jjjay0826/rocket-system/doc/README.md

# doc/ 導覽 

## 🆕 第一次接觸這個專案?先讀 **[getting_started.md](getting_started.md)**

**本頁是給「已經懂這個領域」的人用的路由表**,直接就出現開傘判據、
拖曳傘、卡爾曼、遙測封包這些詞。如果這些名詞你還不熟,
先花 20 分鐘讀 [getting_started.md](getting_started.md) —— 那份從
「這塊板子到底是幹嘛的」開始講,只需要會看 C 語言。

---

**懂了之後回到這頁。**下面每一份文件都標了狀態,
🔴 標記的**不要引用它的結論**,那是已經被推翻的舊版,留著只是為了追溯歷史。

---

## 五分鐘認識現況

**2026-08-01 在旭海實際飛過一次(第 161 隊,競賽第三名)。**

- 飛到 **833.7 m**。**ch1 的開傘主路徑在頂點後約 2 秒(1.6~2.1 s)觸發;ch2 主路徑失效,靠 18 秒備援計時器開傘** —— 備援救了它,但主路徑在兩塊板裡失敗了一塊
- 失效在回收系統的機械端:拖曳傘展開時把箭體帶進 **3.2 轉/秒**的自旋,
  主傘在自旋中充氣、傘繩扭轉、載荷集中到少數幾條線上、結構失效,
  以 32 m/s 落海
- **箭體未回收,只尋回鼻錐** → 兩塊板的 SD 卡沉海,**50 Hz 資料永久遺失**

完整版:**[flight_161_summary.md](flight_161_summary.md)** ← 沒時間的話只讀這份

---

## 依你要做的事找檔案

### 「我要準備下一次發射」

| 順序 | 檔案 | 為什麼 |
|---|---|---|
| 1 | **[known_issues.md](known_issues.md)** | **現在還沒修的問題,唯一的現況清單。**🔴 那 7 條是「下次飛之前一定要處理」 |
| 2 | **[launch_day_reference.md](launch_day_reference.md)** | 發射日操作手冊。編譯開關、開機檢查、地面站啟動、全部指令、按鈕、狀態燈 |
| 3 | **[flight_161_summary.md](flight_161_summary.md)** 第七節 | 上次飛完得到的六條改進項,前三條是回收系統 |
| 4 | [open_defects_20260801.md](open_defects_20260801.md) | 上次**發射前**的缺陷清單(快照)。當檢查清單的範本用;現況以 known_issues.md 為準 |
| 5 | [../firmware-rocket/doc/e28_b_board_checklist.md](../firmware-rocket/doc/e28_b_board_checklist.md) | B 板換 2.4 GHz E28 的接線與法規 |

> ⚠ **發射日守則**:`open_defects_20260801.md` 的 A 段是「做不到就別飛」的項目。
> 不要在發射日改開傘路徑 —— 那條寫在 `failure_analysis_20260801.md` 裡,
> 是上一屆的教訓。

### 「我要知道上次為什麼失敗」

| 檔案 | 涵蓋 | 狀態 |
|---|---|---|
| **[flight_161_summary.md](flight_161_summary.md)** | 全部三項失效的總表 ＋ 子系統成績單 ＋ 無解清單 | 🟢 **從這裡開始** |
| **[parachute_failure_20260801.md](parachute_failure_20260801.md)** | 主傘失效的完整因果鏈、證據、判據 | 🟢 開傘議題的權威版 |
| [failure_analysis_20260801.md](failure_analysis_20260801.md) | **§1 GNSS 失效**、**§2 卡爾曼速度失效** | 🟡 這兩節仍有效 |
| ↳ 同檔 §3 主傘 | | 🔴 **已被推翻,勿引用** |

### 「我要分析我自己的飛行資料」

**[../tools/README.md](../tools/README.md)** —— 兩條管線的完整使用說明,指令可以直接複製貼上:

- **管線 A 遙測**:`raw_chN.log` → 解析 → 雙板儀表板 / 對照表 / 速度反解
- **管線 B 影像**:YouTube 直播存檔 → 抽幀 → 追蹤裁切 → 天空扣除
- **管線 C 模擬**:OpenRocket `.ork` → 81 組矩陣 → 韌體開傘邏輯重跑 → 地面站回放

### 「我要改韌體」

| 檔案 | 內容 |
|---|---|
| [../firmware-rocket/doc/interactive_features.md](../firmware-rocket/doc/interactive_features.md) | 互動功能與 LED 指示(PB6/PB7 開關、兩顆 LED 的語意) |
| [../firmware-rocket/doc/rocket_v2_CubeMX_config.md](../firmware-rocket/doc/rocket_v2_CubeMX_config.md) | CubeMX 逐項設定清單(重新產碼時照這份) |
| [../shared/README.md](../shared/README.md) | 兩端共用的東西:封包契約、LoRa 模組設定檔 |
| [failure_analysis_20260801.md](failure_analysis_20260801.md) §2 | 卡爾曼速度為什麼不可信 —— **改開傘判據前必讀** |

### 「我要做地面站」

[../firmware-ground/README.md](../firmware-ground/README.md) ＋ [../shared/protocol.h](../shared/protocol.h)。
沒有真飛行資料時用 `tools/replay309.py` 灌模擬封包進去。

### 「我要準備簡報 / 報告」

[final_presentation_plan.md](final_presentation_plan.md) —— 2026 年那次的簡報規劃。
比賽已經結束(第三名),但**評分表逐項拆解**與**論述框架**對下一屆仍然適用。

---

## 檔案總覽

### doc/

| 檔案 | 狀態 | 內容 |
|---|---|---|
| `getting_started.md` | 🟢 **新手第一站** | 從零開始:這塊板子是什麼、怎麼判斷開傘、板上有什麼、名詞表、第一個小時動手做什麼 |
| `where_is_everything.md` | 🟢 **找檔案看這份** | 兩個 GitHub repo 的 clone 指令、完整檔案地圖、以及「新東西該放哪」 |
| `README.md` | 🟢 | 本頁(路由表) |
| `known_issues.md` | 🟢 **現況清單** | 所有還沒修的問題(🔴7／🟠12／🟡5／❓3)與已修好的教訓,每項附白話說明與修法。**修好一項就更新它** |
| `flight_161_summary.md` | 🟢 **入口** | 2026-08-01 飛行總結。總表／失效鏈／子系統成績單／無解清單／改進項 |
| `parachute_failure_20260801.md` | 🟢 | 主傘失效完整分析。**開傘議題以這份為準** |
| `launch_day_reference.md` | 🟢 | 發射日操作手冊(764 行,最厚的一份) |
| `failure_analysis_20260801.md` | 🟡 部分 | §1 GNSS 🟢／§2 卡爾曼 🟢／**§3 主傘 🔴 已被推翻** |
| `open_defects_20260801.md` | 🟡 快照 | 2026-08-01 發射前的缺陷清單。部分項目已被飛行結果回答;**現況看 `known_issues.md`** |
| `final_presentation_plan.md` | 🟡 歷史 | 2026 決賽簡報規劃。評分表拆解仍可參考 |
| `sim309_81cases.csv` | 🟢 資料 | 81 組 OpenRocket 模擬(3 推力 × 3 仰角 × 9 風況) |
| `sim309_analysis.txt` | 🟢 資料 | 上者的分析輸出 |

### 其他位置的文件

| 檔案 | 內容 |
|---|---|
| [`../README.md`](../README.md) | Monorepo 總覽、為什麼用 monorepo、編譯方式 |
| [`../tools/README.md`](../tools/README.md) | 全部分析工具的使用說明 |
| [`../firmware-ground/README.md`](../firmware-ground/README.md) | 地面接收端 |
| [`../firmware-rocket/doc/`](../firmware-rocket/doc/) | 韌體互動功能、B 板 E28 換裝 |
| [`../hardware/README.md`](../hardware/README.md) | 兩代航電板的電路圖、PCB、網表,以及參考的資料表版本 |
| [`../sim/README.md`](../sim/README.md) | OpenRocket 模型(含舊版)、推力曲線、定 DEPLOY_TB 用的模擬輸出 |
| [`history/README.md`](history/README.md) | 已被取代的設計:開傘邏輯 v1.5、2025-11 FMEA |
| [`flightdata/README.md`](flightdata/README.md) | 每一份原始資料的來源、格式與原始檔名 |

---

## 狀態標示的意思

| | 意思 |
|---|---|
| 🟢 | **現行有效。**可以直接引用 |
| 🟡 | **歷史紀錄或部分過時。**內容仍有價值,但引用前看該檔的頂部說明 |
| 🔴 | **結論已被推翻。**留著只為追溯,**不要引用** |

**寫新文件時請一起維護這一頁。**這次就是因為沒有索引,
repo 裡一度同時存在三份講同一件事而結論相反的文件。

---

## 已知的倉庫問題

### 1. ✅ 已解決:`main.c` 曾在 HEAD 上編譯不過

commit `b0ad361` 有 4 處 C 字串字面值被換行切斷(寫檔時 shell 把 `\r\n`
當成真的換行處理掉了)。**已於 `f6f4c1d` 修復並推送**,現在 clone 下來編得過。

留著這條是因為那個坑會再犯:**用工具寫 C 檔時,`\r\n` 這種跳脫序列很容易
被中間的 shell 層吃掉。**寫完務必檢查引號與括號是否平衡。

### 2. ✅ 已解決:原始飛行資料現在在 repo 裡

`doc/flightdata/` —— clone 下來就有,不必跟任何人要。逐檔說明見
[flightdata/README.md](flightdata/README.md)。

火箭模型同樣已收進 `sim/models/`(先前 `gen_sim_matrix_309.py` 寫死了
某台電腦的絕對路徑,換一台就跑不動)。

### 3. 🟠 協定同步機制沒有 CI,而且住在另一個 repo

`shared/protocol.h` 沒有被任何 `.c` `#include`,但**它是同步的** ——
地面站 repo 有一支 `tests/test_crossrepo_protocol.py`,**直接讀 `main.c`**
把格式字串抓出來逐字比對(2026-08-04 重跑 26/26 通過)。

問題不是「沒同步」,是:

1. **沒有 CI**,要手動跑
2. **它在另一個 repo** —— 只改韌體的人根本不知道有這支測試

**改 `main.c` 的封包格式或指令字串後,一定要跑:**

```bash
cd rocket_system_ground_side && python tests/run_all.py
```

完整說明見 [../shared/README.md](../shared/README.md)。

### 4. ✅ 已解決:Windows 上 clone 會改到資料檔的位元組

Git for Windows 預設 `core.autocrlf=true`,checkout 時會把 LF 換成 CRLF ——
連 PDF、STEP 都會被誤判成文字檔而改壞,`SHA256SUMS` 也永遠對不上。
**repo 裡存的位元組一直是對的,壞的是 Windows 上 checkout 出來的那份。**
2026-10-09 從乾淨 clone 驗證時發現(`sim/motors/*.eng` 從一開始就中招)。

修法是根目錄的 [`../.gitattributes`](../.gitattributes):資料、設計檔、雜湊清單一律不轉換。
**在那之前 clone 的 Windows 使用者,重新 clone 一次。**

---

## 2026-08-04 做過的結構整理

給接手的人一個交代,以免以為東西不見了:

| 動作 | 原因 |
|---|---|
| 刪除 `firmware-rocket/` 與 `firmware-ground/` 的 `Application/User/` | 2026-06-26 CubeIDE UnderRoot 遷移的殘骸。這兩個是**根結構**專案,`Core/Src` 才是真實 source folder,`Application/` **從未被編譯**(產物只有 `Debug/Core/Src/*.o`),`.project`／`.cproject` 也完全沒有引用它 |
| 刪除 `firmware-rocket/Core/Inc/imu.h`、`lora.h` | 0 個 include,對應的 `.c` 早已改名成 `.bak`(而 `.bak` 被 gitignore,所以 repo 裡根本沒有) |
| `firmware-ground` 的 `.ioc` 改名 `rocket sensor` → `rocket ground` | **兩個專案的 `.ioc` 都自稱 rocket sensor。**ground 的 `.cproject` 還有 5 處 `${workspace_loc:/rocket sensor}` —— 同一個 workspace 下建置,輸出可能寫進火箭專案的目錄 |
| `lora_922_*.ini` 搬到 `shared/` | 地面端的設定檔原本住在火箭專案裡 |
| `rocket_v2_CubeMX_config.md` 搬進 `firmware-rocket/doc/` | 與其他兩份韌體文件放一起 |
| `.gitignore` 移除 `*.launch` 規則 | 與它自己上面三行的註解「刻意保留入庫:`*.launch`」自相矛盾。既有的兩個沒事(早就被追蹤),但**新增的會被靜默忽略** |

### ⚠ `sandbox/baro` 刻意沒有比照辦理 —— 它的結構和另外兩個不一樣

整理過程中差點把 `sandbox/baro` 也一起清掉,**那會讓它連結失敗**。原因:

| | `firmware-rocket` / `firmware-ground` | `sandbox/baro` |
|---|---|---|
| 專案根 | 資料夾本身 | **`STM32CubeIDE/` 子資料夾** |
| 結構 | 根結構(2026-06-26 已遷移) | **舊 linked-resource** |
| `Core/Src/*.c` | 真實 source folder | 以 `<link>` 連進 `Application/User/Core/` 這個虛擬名稱 |
| `Application/User/` 裡的 startup／syscalls／sysmem | 沒被引用的重複品 | **實體檔案,而且是建置唯一的來源** |

`sandbox/baro/Core/` 底下雖然也有一份 startup／syscalls,但那在**專案根之外**,
`.project` 沒有連它,所以不在建置裡。**動 baro 的檔案結構之前先看 `STM32CubeIDE/.project`。**

**沒有動的**(已知取捨,不是疏漏):

- `main.c` 2468 行的 monolith。IMU 是唯一沒有獨立驅動的感測器
  (bmp585／gnss／lora_e22／logger／sd 都有),`imu.c` 是最自然的第一刀 ——
  **但那是飛安關鍵路徑,不該在沒有台架驗證的情況下拆。**
- `sdcard.c` 是死碼但不能刪:`logger.c:18` 的 `extern FIL file;` 靠它定義。

---

## 附註

**① 兩塊完全獨立的板,是這個專案做過最值得的決定。**
2026-08-01 那次,**兩次開傘衝擊各只有一塊板錄到** —— 單板就永遠不會知道
發生過兩次衝擊,整條失效鏈也就推不出來。電源、感測器、天線全部獨立。

**② 純量測比濾波後的量可靠一個數量級。**實測:

| 量 | 雙板差 |
|---|---|
| 頂點**純氣壓**高度 | **0.3 m** |
| 頂點**卡爾曼**高度 | 3.5 m |
| 最大上升速度(卡爾曼) | 10.3% |
| `cond_B` 觸發時刻(吃卡爾曼速度) | **4.5 秒** |

開傘判據能用純氣壓就別用濾波後的速度。

**③ 事後才想量的東西,加進封包幾乎不要錢。**
2026-08-01 的關鍵證據(1166 °/s 自旋)是**事後**從封包裡湊出來的;
如果當初直接送 `|w|`,地面在飛行當下就看得到。同理加速規的峰值保持暫存器 ——
2 Hz 取樣抓不到開傘衝擊真峰值,那個暫存器成本近乎為零。
