jjjay0826/rocket-system/doc/flightdata/README.md

# flightdata/ — 原始遙測與 SD 卡記錄

**這是整個專案唯一無法重製的東西。**其他所有分析產出（CSV、圖表、影像幀）
都可以從這些檔案 ＋ `tools/` 重跑出來，但這些檔案本身沒有備份來源。

兩種來源，**都沒有經過任何處理**：

- `raw_ch*.log` —— 地面站收到什麼就存什麼
- `IMU_*.CSV`、`LOG_*.TXT` —— 板上 SD 卡寫的原檔（只有檔名在收進來時改過，對照表在各段）

| 資料夾 | 日期 | 是什麼 |
|---|---|---|
| [`20260801/`](#20260801--2026-08-01-旭海實飛第-161-隊) | 2026-08-01 | ★ 旭海實飛 |
| [`20260731_eve_of_launch/`](#20260731_eve_of_launch--發射前一晚的-ch1-測試) | 07-31 夜 | 發射前一晚 ch1 地面測試 |
| [`20260722_ground_test/`](#20260722_ground_test--2026-07-22-ch2-的地面測試) | 07-22 | ch2 地面測試（含 SD 失敗樣本） |
| [`20260720_ground_test/`](#20260720_ground_test--2026-07-的三次測試) | 07-20～21 | 三次地面／飛行測試 |
| [`20260717_test/`](#20260717_test--2026-07-17-的-500-hz-記錄) | 07-17 | 500 Hz SD 記錄 |
| [`20260605_drop_tests/`](#20260605_drop_tests--2026-06-投放測試的-sd-卡記錄) | 06-05～06 | 投放測試 SD 記錄 |

---

## 20260801/ — 2026-08-01 旭海實飛（第 161 隊）

| 檔案 | 大小 | 行數 | 是什麼 |
|---|---|---|---|
| **`raw_ch1_20260801_152419_5e03e520_utc.log`** | 15 KB | 85 | **★ ch1，帶 UTC 時戳，只含飛行窗口** |
| **`raw_ch2_20260801_152419_5e03e520_utc.log`** | 18 KB | 91 | **★ ch2，同上** |
| `raw_ch1_20260801_152419_5e03e520.log` | 1.75 MB | 10136 | ch1 完整連線記錄（含發射前 93 分鐘待機） |
| `raw_ch2_20260801_152419_c212c94f.log` | 1.94 MB | 11257 | ch2 完整連線記錄 |

### ★ 為什麼 `_utc` 那兩個最重要

`T` 欄位是各板**自己開機後的毫秒數**，兩塊板開機時間不同，所以兩份 log 的 `T`
**不能直接比對**。`parse_raw_lora.py` 再各自以「第一個 `ST:1` 封包」當 t=0，
兩板的 t=0 差 0.49 秒 —— **那是 ch1 離架時掉了兩包（SQ14170、14171）加上 2 Hz 量化，
不是兩板判定離架的時間差**（2026-10-15 更正，舊文寫成「ch1 較晚判定」）。

`_utc` 版本在每行前面多了地面站收到封包時的 UTC 時戳，**這是唯一能把兩塊板放到
同一條時間軸上的東西**：

```
16:57:25.560 T7087226 SQ14166 AX-0.983 AY+0.011 AZ-0.011 ...
└─ 地面站 UTC ─┘ └────────── 火箭送出的原始封包 ──────────┘
```

2026-08-01 的整個失效分析都建立在這上面 —— 「**兩次**開傘衝擊，各只有一塊板錄到」
這個關鍵發現，沒有共同時間軸就推不出來。每包的「UTC − T」相對中位數只散佈 ±10 ms，
所以換算後兩板的取樣點穩定相差 30 ms，這是對齊正確的驗證。

⚠ ch2 的 `_utc` 版**沒有收錄 MSG 行**；ch1 的 `_utc` 版裡 MSG 行的時戳是沿用前一包的，
不是獨立的收包時間。開傘訊息在哪兩包之間，要看完整版 log 的前後順序。
[`tools/verify_timeline_0801.py`](../../tools/verify_timeline_0801.py) 就是這樣讀的，
並把失效分析時間軸的每一列從這裡重算一次。

### 完整版有什麼額外的東西

- 發射前 93 分鐘的待機封包 —— 可以看電池電壓漂移、GPS 收斂過程
- ch1 的**空中斷電重開機**（`RST=POWER-ON`）與重開後的 41 個封包
- `raw_ch1_...5e03e520.log` 含約 5000 個損壞位元組（占 0.29%）。
  **那不是檔案壞掉，是無線電位元錯誤** —— 它本身就是鏈路品質的真實記錄，不要「修」它。

---

## 20260720_ground_test/ — 2026-07 的三次測試

| 檔案 | 大小 |
|---|---|
| `raw_ch1_20260720_115824_8153b14f.log` | 124 KB |
| `raw_ch1_20260720_122930_7f8a913d.log` | 252 KB |
| `raw_ch1_20260721_122019_509bd551.log` | 52 KB |

發射前的地面／飛行測試。硬體與韌體都與 8/1 那次不同，
**不要拿來和實飛資料混著分析**。

---

## 20260722_ground_test/ — 2026-07-22 ch2 的地面測試

| 檔案 | 大小 | 行數 |
|---|---|---|
| `raw_ch2_20260722_173021_41f29e2c.log` | 31 KB | 171 |
| `raw_ch2_20260722_175316_f0a1dfec.log` | 3 KB | 19 |
| `raw_ch2_20260722_210613_4fdd140b.log` | 845 KB | 3967 |

地面站 `data/` 資料夾留下的 ch2 原始記錄（當天在做雙板地面站）。
**開頭就是 SD 初始化失敗**（`SD: FAIL ... fres=3`、`REINIT FAIL`、`GIVE-UP`）——
是 [known_issues.md](../known_issues.md) #8「SD 卡 reset 後鎖死」的實際樣本。

## 20260731_eve_of_launch/ — 發射前一晚的 ch1 測試

| 檔案 | 大小 | 行數 |
|---|---|---|
| `raw_ch1_20260731_235856_5baa84ec.log` | 98 KB | 855 |
| `raw_ch1_20260801_011332_ffaff45a.log` | 170 KB | 1445 |
| `raw_ch1_20260801_023341_5096a02d.log` | 1 KB | — |

2026-07-31 23:58 ～ 08-01 02:33，實飛前一晚 ch1 的地面測試，同樣來自地面站 `data/`。
最後一個檔只有 978 位元組、**全是亂碼**（鮑率不對或模組雜訊），照原樣保留。

## 20260605_drop_tests/ — 2026-06 投放測試的 SD 卡記錄

| 檔案 | 原始檔名 | 大小 | 長度 |
|---|---|---|---|
| `IMU_20260605_1723.CSV` | `IMU.CSV` | 2.5 MB | 81.8 s |
| `IMU_20260605_1738.CSV` | `IMU(1).CSV` | 270 KB | 8.2 s |
| `IMU_20260605_1743.CSV` | `IMU(2).CSV` | 333 KB | 11.5 s |
| `IMU_20260606_1653.CSV` | `IMU(3).CSV` | 1.8 MB | 58.5 s |
| `LOG_20260605_1727.TXT` | `LOG(1).TXT` | 49 KB | 539 行 |
| `LOG_20260605_2043.TXT` | `LOG(2).TXT` | 9 KB | 60 行 |

- 投放測試板（`sandbox/parachute` 的前身）寫在 SD 卡上的記錄。
  `IMU_*.CSV` 是 **500 Hz**（`ts_us` 每筆 2000 µs），欄位
  `ts_us,gx_dps,gy_dps,gz_dps,ax_g,ay_g,az_g,baro_m,vz_ms,imu_hz_m`；
  `LOG_*.TXT` 是 2 Hz 的氣壓文字記錄（`T= P= H= RelH=`）。
- **檔名是收進來時重新命名的**：原檔名都叫 `IMU.CSV`／`LOG.TXT`，
  下載時被加上 `(1)(2)`。新檔名用的是檔案時間（取出 SD 卡或下載的時間，
  測試本身在當天或更早），對照見上表。
- ⚠ **每個檔對應哪一次投放、投放高度多少，沒有留下紀錄。**

## 20260717_test/ — 2026-07-17 的 500 Hz 記錄

| 檔案 | 大小 | 長度 |
|---|---|---|
| `IMU_002.CSV` | 3.0 MB | 87.6 s |

`sandbox/parachute` 格式（多了 `g_tot,kf_vz_ms,kf_h_m` 三欄）。測試內容沒有留下紀錄。

### 每個資料夾都有 `SHA256SUMS`

收進來時算的雜湊值。要確認檔案沒被改過：

```bash
cd doc/flightdata/20260605_drop_tests && sha256sum -c SHA256SUMS
```

---

## 怎麼用

```bash
python tools/parse_raw_lora.py doc/flightdata/20260801/raw_ch1_20260801_152419_5e03e520_utc.log --out-dir out
python tools/parse_raw_lora.py doc/flightdata/20260801/raw_ch2_20260801_152419_5e03e520_utc.log --out-dir out
python tools/flight_report.py out/raw_ch1_*_parsed.csv out/raw_ch2_*_parsed.csv --out report.png
```

**第一個參數放先失聯的板（ch1）**，第二個放涵蓋全程的（ch2）。
完整說明見 [`../../tools/README.md`](../../tools/README.md)。

封包欄位的意思見 [`../getting_started.md`](../getting_started.md) 第六節。

---

## 沒有進來的東西

| | 為什麼 |
|---|---|
| **SD 卡的 50 Hz 記錄** | 🔴 **永久遺失。**箭體未回收，兩塊板隨之沉海 |
| 直播影像幀（668 MB） | 可再生：`tools/grab_yt_frames.py`，來源 `youtube.com/watch?v=ogR7rgce_ps` 的 **5:54:53 起 47 秒** |
| 解析後的 CSV、事件檔、儀表板 | 可再生：用上面的指令 |
