jjjay0826/rocket-system/doc/open_defects_20260801.md

# 發射日缺陷清單 — 2026-08-01

> ## 🟡 這是 2026-08-01 **發射前**的快照
>
> **火箭已經飛了**，所以下面有些項目已經被飛行結果回答，有些則被證明無關。
> 下一屆的用法是：**當作檢查清單的範本**逐條確認現況，不要當成現在的狀態。
>
> 飛行結果 → [flight_161_summary.md](flight_161_summary.md)
>
> **現在還沒修的有哪些 → [known_issues.md](known_issues.md)**（現況清單，與本檔衝突時以它為準）
>
> 已知被飛行結果直接影響的項目：
>
> | 原項目 | 飛行後 |
> |---|---|
> | 回收系統相關（B 段） | 🔴 **主傘確實失效了**。因果鏈見 [parachute_failure_20260801.md](parachute_failure_20260801.md)。減震繩／傘繩強度那幾條要按新結論重寫 |
> | D 段「只有現場能回答」 | 大部分已有答案，但**箭體未回收**，實體相關的永遠不會有答案 |
> | SD 卡相關 | 🔴 **卡隨箭體沉海**。SD 問題仍未解，但這次沒有資料損失以外的後果 |
>
> 文件導覽 → [README.md](README.md)

> 發射 13:00。本表依「還來不來得及」排序，不是依嚴重性。
> 每一項都註明是【已確認】還是【未知】—— 未知的那些只有現場能回答。

---

## 🔴 A. 會擋住發射

| # | 缺陷 | 狀態 | 需時 |
|---|---|---|---|
| ~~**A1**~~ | ~~`REMOTE_CMD_UNRESTRICTED` 仍開啟~~ → **2026-08-01 已關閉**<br>連同另外兩個一起：`PYRO_ADC_FITTED`（分壓實際沒焊）、<br>`LORA_MODE_PINS`（M0/M1 實際還接地，`/setch` 會讓 GPIO 短路到地 82mA）<br>🔴 **仍需重新編譯燒錄兩塊板，並確認 `#warning` 消失** | 已改，未燒錄 | 燒錄 + 驗證 |
| **A2** | **關掉之後的閘門從未在硬體上測過**<br>`/arm` → `/dpl` 的接受／拒收路徑只驗過編譯與結構斷言<br>★2026-08-01：IDLE+ARM 已改成裸脈衝，**ARM 窗口內可重複測**，<br>　不必每發都斷電重開 | 未測 | 20 分 |
| **A3** | **開傘改雙路 PA0+PA1 從未實測**<br>並聯到同一顆電火頭，**任一路單獨拉高就會點著**。<br>要用電表確認開傘時**兩支腳都有 7V** | 未測 | 15 分 |
| **A4** | **E28 在吐 RSSI 位元組**<br>會混進遙測流 → 解析器整幀丟棄。實測 21 個位元組全部落在<br>−71 ~ −111 dBm，是環境噪聲的 RSSI 值 | 已確認 | 20 分 |
| **A5** | **ch2 (com14) 完全連不上**（重試 331 次）<br>雙板熱備援目前只剩一塊板。可能是 A4 的下游症狀 | 已確認 | ? |

**A1～A3 沒做完不該上箭。**

---

## 🟠 B. 已知缺陷，發射前該查

### 回收系統

| # | 缺陷 | 數字 |
|---|---|---|
| **B1** | **CO2 彈射只噴 50 cm** | HPR 通則要 3～5 m。**95% 的能量沒到鼻錐上**。<br>驗法：秤 CO2 瓶刺破前後重量（五分鐘） |
| **B2** | **開傘衝擊 22～53 g** | 靜風 557 kgf／最壞 **1336 kgf**（×1.2～1.8 開傘衝擊係數後更高）。<br>傘繩與連接件額定值**未知** |
| **B3** | **減震繩是否有彈性** | 有彈性 18 kgf vs 沒彈性 272 kgf — **差 15 倍**。<br>最便宜的一項改善 |
| **B4** | **浮力段 88 cm 不夠** | 17.5 kgf vs 需要 25.2 kg → 短少 7.7 kgf。<br>要 2～3 條泳池浮條 ＋ 引擎室隔板封死 |

### 韌體（2026-08-01 新增）

| # | 缺陷 | 影響 |
|---|---|---|
| **B8** | **`rel_alt` 完全沒有突波抑制**<br>`peak_rel_alt` 直接吃 `if (rel_alt > peak) peak = rel_alt`，<br>實測 KH 會有單包 >10m 的突波 | ① cond_A 提早觸發（無害，速度較低反而好）<br>② 上升段大突波會提前武裝 cond_A（**靠 AND 閘擋住**）<br>🔴 ③ 觸發 KF 大偏差重置 → `kf2_v = vz_baro_lp`（被污染成正值）<br>　　→ **cond_B 的 1.5 秒計時重來**<br>🔴 ④ 突波間隔 < 1.5s → cond_B 永不成立 → **只剩 C 計時器**<br>單次突波：C 備援接得住（已驗證）。**賽後修，不要在發射日動開傘路徑** |

### 硬體

| # | 缺陷 | 狀態 |
|---|---|---|
| **B5** | **酸性助焊劑**（凡士林＋氯化鋅＋鹽酸） | 航電板是否用它焊的**未確認**。<br>「室內好、室外壞」與離子污染的濕度依存完全吻合 |
| **B6** | **LDO 板通電 7 秒短路** | 未解決。下游只剩排針與單芯線 |
| **B7** | **E28 發射功率 12 dBm**（模組是 27 dBm 的料） | 白白少 15 dB。2.4 GHz 的傳播本來就吃緊 |

---

## ⚪ C. 已知但這次接受

| # | 缺陷 | 為什麼接受 |
|---|---|---|
| **C1** | SD reset 鎖卡救不回來 | 已實測四修無效。飛行資料以 LoRa 為主，SD 當備份 |
| **C2** | 沒有看門狗（IWDG／WWDG 都關） | 四個故障處理器已改成重開機，但「當機以外的卡死」無保護 |
| **C3** | SD 寫入最長阻塞 ~1.1 s | 原本 2 s，已降。跑在開傘狀態機同一迴圈 |
| **C4** | LoRa RX ring 266 ms < SD 恢復 1.1 s | SD 卡住時上行指令可能整段掉 |
| **C5** | `cmd.c` 單槽 pending 覆寫 | 連續兩道指令會蓋掉前一道 |
| **C6** | `settings.json` 機器專屬卻入庫 | 合併會互相覆蓋 |

---

## ❓ D. 未知 — 只有現場能回答

這些直接決定上面的結論：

- [ ] **實測秤重的回收質量**（25.2 kg 是推算）→ 決定浮條 2 條還是 3 條
- [ ] **傘繩／連接件的額定拉力** → 決定 B2 是不是致命
- [ ] **減震繩是彈性的嗎** → 15 倍差距
- [ ] **CO2 瓶規格與秤重結果** → 決定 B1 的原因
- [ ] **傘艙實際長度**（49 cm 是從設計圖讀的）
- [ ] **剪切銷幾支？還是只靠摩擦？**
- [ ] **洩壓孔孔徑與數量**
- [ ] **航電板用哪一罐助焊劑焊的**
- [ ] **E22 (ch1) 的參數** — 有沒有同樣的 RSSI 問題
- [x] ~~分壓電路焊了沒~~ → **沒焊**（2026-08-01 現場確認，`PYRO_ADC_FITTED` 已關）
- [x] ~~M0/M1 改線了沒~~ → **沒改，還接在 GND**（`LORA_MODE_PINS` 已關）
- [x] ~~AUX 接 PB9 了沒~~ → **接了**（`LORA_USE_AUX` 維持開啟）
- [ ] **落區是海是陸**

---

## 🔍 E. 從未審查過的程式碼

```
韌體
  firmware-rocket/FATFS/Target/user_diskio.c
  firmware-rocket/FATFS/Target/ffconf.h
  firmware-rocket/Core/Src/tim.c              104 行
  firmware-rocket/Core/Src/syscalls.c         176 行   newlib 樁，低風險
  firmware-rocket/Core/Src/sysmem.c            79 行   同上
  USB_DEVICE/Target/usbd_conf.c               671 行
  Core/Src/system_stm32f4xx.c                 747 行   CubeMX 生成

地面站
  src/gui/visualizers/attitude_displayer.py
  src/gui/visualizers/visualization_tools.py
  src/gui/flow_layout.py
  src/core/models.py 的邊界情況（格式已由 crossrepo 覆蓋）
```

風險評估：`syscalls.c`／`sysmem.c` 是 newlib 樁，幾乎不可能有事。
`user_diskio.c`／`ffconf.h` 在 SD 那條路，而 SD 已降級成非必要。`tim.c` 值得看一眼。

---

## 📌 F. 今天新發現、且推翻先前結論的

| # | 事情 |
|---|---|
| **F1** | **C 備援在 7/81 組會先觸發**。`tools/analyse_309.py` 的彈道解析式說 0/81，<br>但 `tools/fw_logic.py` 真跑韌體邏輯是 **7/81**。<br>A∧B 實際要頂點後 **1.95 s**，不是解析式的 1.55 s ——<br>氣壓計要穿過自己的雜訊才確認跌破 10 m，卡爾曼也要時間把負速度建起來。<br>**不是失效**（C 在頂點後 1.67 s 觸發，火箭正在下降），<br>但「開傘靠 A∧B」要改成「高推力端靠 C」 |
| **F2** | **`fw_logic` 不含氣壓膜時間常數** → 真板的 A 會更慢，走 C 的組數只會更多 |
| **F3** | **`groundhitvelocity` 是合速度**，含水平漂移。<br>先前用它反推質量得到 26.3 kg 是高估的；<br>用無風組的純垂直降速 6.449 m/s 反推是 **25.2 kg** |

---

## 建議的當日順序

```
第 1 小時   A4  關掉 E28 的 RSSI 輸出 → 看 ch2 通不通（A5 可能一起解決）
            B1  秤 CO2 瓶刺破前後重量

第 2 小時   A1  關掉 UNRESTRICTED、重新編譯（確認 #warning 消失）
                燒錄兩塊板

第 3 小時   A2  測 /arm → /dpl 閘門
            A3  電表確認開傘時 PA0+PA1 兩支腳都有 7V

第 4 小時   B3  檢查減震繩彈性
            B4  買浮條、用擠的泡棉封引擎室隔板

隨時       B5  目視檢查 SPI2 焊點有無腐蝕（★不要洗，來不及乾）
```

**如果只能做三件事：A1、A3、B3。**
前兩件決定傘會不會開，第三件決定傘開了之後繩子會不會斷。
