jjjay0826/rocket-system/doc/launch_day_reference.md

# 發射日操作手冊

> 建立 2026-07-27。所有數值皆從程式碼核對而來,非憑記憶。
> 韌體 `rocket-system@main`、地面站 `rocket_system_ground_side@main`。
> 飛行模擬來源:**OpenRocket `3.0.9`**,81 組矩陣(3 推力 ×3 仰角 ×9 風況)。
>
> ⚠ **2026-08-01 更新**:本文以下的數字多數仍是 3.0.8 的。3.0.9 每一項都更好
> (最小備援餘裕 1.29→**1.69 s**、C 先觸發 6/81→**0/81**、最偏西 −48→**+19 m**、
> 臨界東風 4.0→**4.6 m/s**),所以舊數字是**保守側**,照舊值操作不會出錯。
> 完整 81 組見 `doc/sim309_analysis.txt` 與 `doc/sim309_81cases.csv`。
>
> 🔴 但有一項**結論改變**:`tools/fw_logic.py`(真跑韌體的 (A∧B)∨C,不是彈道
> 解析式)顯示 **7/81 組會由 C 先觸發**,而不是 0/81。A∧B 實際要頂點後 1.95 s。
> 不是失效 —— C 在頂點後 1.67 s 觸發,火箭正在下降。詳見
> `doc/open_defects_20260801.md` 的 F1。
> 最後更新 2026-07-31。

---

## 🔴 第一部分:出門前必做(做不到就別飛)

### 1. 三個編譯開關的狀態

| 開關 | 位置 | 現在 | 飛行前必須 |
|---|---|---|---|
| `REMOTE_CMD_UNRESTRICTED` | `main.c:774` | ✅ **已關** | 保持關閉 |
| `PYRO_ADC_FITTED` | `main.c:181` | ✅ **已關** | 保持關閉(分壓**沒有**焊) |
| `LORA_MODE_PINS` | `lora_e22.c:49` | ✅ **已關** | 保持關閉(M0/M1 **還接在 GND**) |
| `LORA_USE_AUX` | `lora_e22.c:71` | ✅ 開 | 維持(AUX→PB9 已接,現場確認) |

**⚠ 2026-08-01 更正:本表在此之前有兩行是錯的。**
舊版寫 `PYRO_ADC_FITTED` 與 `LORA_MODE_PINS`「✅ 開,維持」,理由是
「2026-07-27 分壓已焊/M0M1 已改線」—— **兩項硬體改動實際上都沒有做**。
照舊表操作會在發射台上做出錯誤決定,所以三個開關已全部關閉。

**關閉的理由**

- **`REMOTE_CMD_UNRESTRICTED`**:開著時遠端開傘沒有任何閘門 —— 不需要 ARM、
  不管飛行狀態、可無限重複點火。那是桌測用的。
  關閉後恢復三道閘門:IDLE 需先 ARM、離架後 10 秒內拒收、已開傘/已落地拒收。
  **編譯時不再噴 `#warning ... NOT FLIGHT SAFE`,那行消失才算真的關掉。**

- **`PYRO_ADC_FITTED`**:分壓沒焊,PB0/PB1 讀到的是浮接雜訊(0.0~0.5V)。
  而 5.0V 以下就判定「保險絲熔斷」→ **等於永久謊報一個最該告警的故障**。
  關掉之後 `v_fuse`/`v_arm` 維持 `-1`,遙測送 -1 =「沒有量測能力」,
  與「量到 0V＝真的熔斷」明確區分。

- 🔴 **`LORA_MODE_PINS`**:M0/M1 還硬接在 GND,而韌體把 PB7/PB5 設成**推挽輸出**。
  平常寫 LOW 無害,但 **`/setch` 會把兩支同時拉 HIGH 200~700ms** ——
  3.3V 直接短路到地,輸出級 R_ds(on) 約 25~50Ω → **每支腳約 82mA,
  而 STM32F411 單腳絕對最大值是 25mA(超標 3.3 倍)**。
  而且換頻根本不會成功:模組端 M0/M1 實體仍是 0,從沒進設定模式。
  **關閉前絕對不要打 `/setch`。**

⚠ **兩塊板都要燒同一個設定。**

### 2. 燒錄後立刻接 USB 檢查開機報告

```
MOD: BMP=1 IMU=1 LORA=1  REF_PRESS=1013.25 hPa  CLK=HSE  RST=POWER-ON  VF=-1.00V VA=-1.00V
```

| 欄位 | 正常 | 不正常代表什麼 |
|---|---|---|
| `BMP=` | 1 | 0 = 氣壓計沒起來,開傘條件 A 失效 |
| `IMU=` | 1 | 0 = 慣性感測沒起來,開傘條件 B 失效 |
| `LORA=` | 1 | 0 = **模組沒回應**,整場收不到遙測 |
| `REF_PRESS=` | 950~1030 | 超出 = 氣壓計讀值有問題 |
| `CLK=` | **HSE** | `HSI-FB` = 晶振故障已降級,**板子要查** |
| `RST=` | POWER-ON | `BROWNOUT` = 電源瞬斷(接觸不良/撞擊)<br>`IWDG` = 看門狗(異常)<br>`NRST-PIN` = 有人按了重置 |
| `VF= / VA=` | **7~8.4V** | -1.00 = ADC 沒啟用(分壓已焊,不該再看到 -1)<br>接近 0 = **保險絲熔斷** |
| 若出現 `BUS=CLAMPED!` | 不該出現 | SPI2 匯流排被鉗位,**立刻斷電查線** |
| 若出現 `UNRESTRICTED MODE` | 不該出現 | **不能飛,回去關開關** |

**兩塊板都要各自檢查一次。**

### 3. 電火頭安全程序

規範 4.6:儲能裝置在有人靠近時必須有**兩個獨立事件**擋著。

- **整備/搬運/上架**:啟動開關 OFF(或點火線未接)= 安全狀態
- **人員撤離後**、依審查委員指示才武裝
- **武裝動作必須從遠處做**(拉繩拔銷/長桿),不可用手在箭體上接線
- 武裝後**任何人不得靠近火箭**

---

## 第二部分:地面站啟動

### 開機順序

```
1. 先插好兩個 LoRa dongle(915MHz 和 2.4GHz)
2. 確認 settings.json 的 COM 埠對得上(見下)
3. 雙擊 run_persist_backend.bat   ← 最常用:同時起後端+GUI
```

| 檔案 | 用途 |
|---|---|
| `run_persist_backend.bat` | **標準啟動**:後端常駐 + GUI,GUI 關掉後端還在 |
| `run_gui_only.bat` | 只開 GUI,接到已經在跑的後端(GUI 崩潰後重開用) |
| `run_backend_ch1.bat` / `ch2.bat` | 只開單一頻道後端(除錯用) |

### COM 埠設定

檔案 `settings.json`,現在是:

```json
ch1 → com11 @ 9600     (915MHz  E22)
ch2 → com7  @ 9600     (2.4GHz  E28)
```

**COM 號換插孔就會變。** 開機發現對不上,兩個辦法:
- 改 `settings.json` 後重開
- 或 GUI 裡打 `/port COM12`(只改焦點頻道,即時生效)

⚠ **兩個頻道絕對不能設同一個 COM 埠**——序列埠是獨佔的,設一樣會有一塊板無聲失聯。

---

## 第三部分:所有指令

在 GUI 最下方的命令列輸入,**必須以 `/` 開頭**。打 `/help` 可以隨時叫出清單。

### 連線類

| 指令 | 作用 |
|---|---|
| `/port <COM>` | 換焦點頻道的序列埠,例 `/port COM12` |
| `/baud <數字>` | 換鮑率(正常都是 9600) |
| `/connect` | 重新連線 |
| `/disconnect` | 停止序列通訊 |
| `/focus <ch>` | 切換焦點頻道,例 `/focus ch2` |

### 資料類

| 指令 | 作用 |
|---|---|
| `/reset-angle` | 地面端姿態歸零(火箭平放時做) |
| `/reset-data` | **開新的一場**:舊 CSV/log 封存,開新檔,畫面全清 |

### 校準類

| 指令 | 作用 |
|---|---|
| `/cal` | 焦點板氣壓歸零 + 地面姿態歸零 |
| `/cal_all` | **全部板**氣壓歸零 + 地面姿態歸零 ← 發射台上用這個 |

⚠ 只在 IDLE 受理,飛行中火箭會拒收。

### 🚨 緊急類(火工品)

| 指令 | 作用 |
|---|---|
| `/arm` / `/arm_all` | 遠端解鎖,**30 秒**視窗 |
| `/dpl` / `/dpl_all` | 強制開傘 |
| `/abg` / `/abg_all` | 開氣囊 |

**帶 `_all` 的會同時發給兩塊板,緊急時一律用 `_all`。**

### 換頻(硬體改線後才能用)

| 指令 | 作用 |
|---|---|
| `/setch <0-80>` | 換 LoRa 頻道,頻率 = 850.125 + ch (MHz) |

**合規頻道只有 CH70~74**(920~925MHz)。現用 **CH72 = 922.125MHz**。
撞頻時的順序建議:**CH73 → CH71 → CH74**(CH70 貼著法規邊界,最後才用)。

⚠ **火箭換頻後,地面端 dongle 必須跟著換,否則該板立刻失聯。**

---

## 第四部分:按鈕(地圖與 log 之間那一排)

```
焦點: [ch1][ch2] ┃ [傘 ch1][囊 ch1][傘 ch2][囊 ch2] ┃ [傘 ALL][囊 ALL] ┃ [校準 ALL] [☑Auto 跟隨]
```

| 按鈕 | 行為 |
|---|---|
| **焦點 ch1/ch2** | 切換圖表/地圖顯示哪塊板。單板指令(`/dpl` 等)會打到焦點板 |
| **傘/囊 各板** | 只對該板 |
| **傘 ALL / 囊 ALL** | 兩塊板同時 |
| **校準 ALL** | 氣壓歸零(單擊即發,靠火箭的 IDLE 閘門防誤按) |
| **Auto 跟隨** | 圖表自動捲動 |

### ARM 到底在管什麼（2026-08-01 補寫）

`ARM` 做三件事，然後就開始倒數：

```c
manual_arm_code = HAL_GetTick() % 10000;   // 隨機四位數，每次都不同
manual_arm_time = HAL_GetTick();           // 起算
manual_armed    = 1;
```

火箭回：`MSG INFO MANUAL ARMED - FIRE 0473 within 30s (SAFE aborts)`
**那個四位數只有這一次有效，而且只有你看得到**（走你的 LoRa 頻道回來）。

#### 窗口長度是動態的

| 狀態 | 窗口 | 為什麼 |
|---|---|---|
| `IDLE`（地面） | **30 秒** | 防「ARM 完就分心」——發射台上有人站在旁邊 |
| 飛行中（≠IDLE） | **300 秒** | 緊急時「單發 `FIRE <碼>`」就開傘（1~2 秒），<br>不必在下墜的十幾秒裡跑完兩步 |

★ 地面 ARM 之後火箭起飛，窗口會**自動延長成 300 秒**（判斷式看的是當下的
`flight_state`，不是 ARM 當時的）。這是刻意的：飛行中 armed 待命正是備援
要的狀態。

#### 🔴 兩條開傘路徑，只有一條需要 ARM

| 路徑 | 需要 ARM？ | 完整條件 |
|---|---|---|
| **`FIRE <碼>`**（USB／手打） | ✅ **一定要** | ① 已 ARM<br>② 窗口未逾時<br>③ **四位數碼完全相符**<br>④ 不是 DEPLOYING／DEPLOYED<br>⑤ 不是 LANDED |
| **`/dpl`**（地面站，`#CMD:FORCE_DPL_SALT9981#`） | **只在 IDLE 要** | · IDLE → **必須先 ARM**（桌測解鎖）<br>· 飛行中 → **不必 ARM**，改由三道閘門擋：<br>　　離架後 10 秒內拒收（上升段誤開＝解體）<br>　　已 DEPLOYING／DEPLOYED 拒收<br>　　已 LANDED 拒收 |
| **PB6 實體鈕** | ✅ 要，還要更多 | IDLE **且** ARM **且** GNDTEST 三者齊備 |

**為什麼 `/dpl` 飛行中不要 ARM**：那是唯一的緊急救援手段，而且它的秘鑰
字串本身就是驗證（24 字元，同頻他隊或雜訊發不出來）。要求兩步會在最需要
它的時候多花 0.7 秒×2。

#### ★ 地面上：ARM 窗口內可以【重複】測試（2026-08-01）

`IDLE` 且已 ARM 時，`/dpl` 與 `FIRE <碼>` 都走**裸脈衝** ——
只拉腳、**不推狀態機、也不解除 ARM**。

```
/arm            → FIRE 0473 within 30s
/dpl            → 點火（1 秒脈衝）    ← 量電壓
/dpl            → 再一次              ← 換人看
/dpl            → 再一次              ← 拍照存證
   ...30 秒內想測幾次都可以
```

**為什麼需要這個**：走正常路徑的話 `flight_state` 會被推進
`DEPLOYING → DEPLOYED →（靜止 10 秒）→ LANDED`，而 **LANDED 是終點、回不去**
—— 一次上電只能測一發，之後全部回 `already deployed / landed`。
桌測要量兩支腳的電壓、要驗上行鏈路、要換人確認，一發不夠。

**這不是把解禁模式開回來。** 那個版本【完全沒有閘門】；這裡：

| 條件 | 效果 |
|---|---|
| **必須先 ARM** | 刻意動作，30 秒後自動失效 |
| **必須在 IDLE** | 離架偵測一成立（2.5g×200ms）這條路就消失，<br>之後只剩會推狀態機的正常路徑 |
| 脈衝進行中不重複觸發 | `dpl_pulse_active` 擋著 |

火箭的回應會標明是哪一種：

```
地面測試  MSG SUCCESS Parachute deployed successfully (ground test - repeatable while ARM holds)
飛行中    MSG SUCCESS Parachute deployed successfully
```

#### 什麼會讓 ARM 失效

| 觸發 | 位置 |
|---|---|
| 窗口逾時 | `ManualDeploy_Poll` 每輪主迴圈檢查 |
| **`SAFE` 指令** | 立刻解除，回 `MANUAL SAFE (disarmed)` |
| `FIRE` 成功點火 | **飛行中**點完就解除；**地面（IDLE）不解除**，見上一節 |
| `FIRE` 碼過期／已開傘／已落地 | 一併解除，強迫重新 ARM |
| 遠端 `/dpl` 成功 | **飛行中**解除；**地面（IDLE）不解除** |

★ **`FIRE` 打錯碼【不會】解除 ARM** —— 只回 `wrong code`，窗口繼續。
打錯字不用重來。

#### 地面站上怎麼看

狀態列會顯示 `🔓ARMxx s` —— **那是火箭回讀的倒數**，不是地面站自己算的。
看不到它就代表 ARM 沒有真的送達。

### 點火鈕的兩段式保險

1. **第一次按** → 變紅、文字變「確認?」、開始 **3 秒倒數**
2. **3 秒內再按一次** → 才真的發射
3. **300ms 內的連按會被忽略**(防手抖/雙擊)
4. **3 秒沒有第二次按** → 自動解除

按鈕寬度是鎖死的,按下去**位置不會移動**,第二下不會誤點到旁邊。

---

## 第五部分:狀態燈與符號

### 每塊板的 LED(左下角)

| 顏色 | 意思 | 該做什麼 |
|---|---|---|
| 🟢 **綠** | 正常收資料 | — |
| 🟠 **橙(常亮)** | 後端在跑,還沒收到遙測 | 等/查天線/查火箭有沒有開 |
| 🟡 **黃(閃)** | **有資料流入但全部解析失敗** | **查裝置插對沒、鮑率對不對、頻段對不對** |
| 🟠 **橙(閃)** | 資料變舊(1.5~5 秒沒新資料) | 訊號變弱,注意 |
| 🔴 **紅** | 超過 5 秒沒資料 | RF 中斷 |
| 🟣 **紫(閃)** | 後端服務沒啟動 | 跑 `run_persist_backend.bat` |

**黃燈是最容易被誤解的**:它代表訊號有進來但看不懂,通常是**插錯 dongle**或**鮑率設錯**,不是天線問題。

### 狀態列符號

```
▶ch1 com11 ✔0.3s 🔒7.9V    ch2 com7 ◌無資料
```

| 符號 | 意思 |
|---|---|
| `▶` | 這是焦點板,單板指令會打到它 |
| `✔0.3s` | 正常,0.3 秒前收到資料 |
| `⚠2.1s` | 資料變舊 |
| `✖8s` | 失聯 8 秒 |
| `◌無資料` | 還沒收到過 |
| `⚠格式錯` | 有資料但解析失敗 |
| `🔓ARM28s` | **該板已武裝**,還剩 28 秒 |
| `🔒7.9V` | pyro 電源正常、未武裝(要 ADC 焊好才有) |
| `🔓武裝7.9V` | pyro 已武裝 |
| `🔴熔斷` | **保險絲斷了,這塊板點不了火** |

### 開傘確認訊息

| 訊息 | 意思 |
|---|---|
| `✅ [CONFIRMED] ch1 DPL verified` | **火箭確實收到並執行了** |
| `🚫 [ch1] DPL REJECTED by rocket: ...` | 火箭收到但拒收(後面會寫原因) |
| `🔴 [UNCONFIRMED] ch1 DPL 已送出但 10s 內未見下行確認` | **沒有任何回應**,可能上行中斷 |

**看到 UNCONFIRMED 不要慌**:另一塊板若正常,單傘仍可安全著陸。可以重發,但**不要因為單板未確認而中止任務**。

---

## 第六部分:飛行狀態機

```
IDLE(0) ──離架偵測──► LAUNCHED(1) ──開傘判斷──► DEPLOYING(2) ──1秒──► DEPLOYED(3) ──靜止──► LANDED(4)
```

| 狀態 | 顯示 | 意思 |
|---|---|---|
| 0 IDLE | 地面靜置 | 等待離架 |
| 1 LAUNCHED | 飛行中 | 監視高度與時間 |
| 2 DEPLOYING | **開傘訊號輸出中** | GPIO 拉高 1 秒 |
| 3 DEPLOYED | 開傘完成 | 等待落地 |
| 4 LANDED | 已落地 | 低功耗記錄(終點,不會再變) |

### 地面站畫面上的 11 列是怎麼來的

火箭只有 5 個狀態,但畫面列了 11 列 —— **其餘 6 列是地面站從遙測推導的**,
用不同底色與「推導」二字標示,不會和火箭回報混在一起。

**火箭回報(綠底,ST 欄直接來)**

| 列 | ST | 韌體怎麼判 |
|---|---|---|
| `IDLE` | 0 | 開機預設 |
| `LAUNCHED` | 1 | 合加速度 ≥ 2.5g **持續 200ms**(100Hz 下連續 20 筆) |
| `DEPLOYING` | 2 | `(A ∧ B) ∨ C` — 見下一節 |
| `DEPLOYED` | 3 | DEPLOYING 之後 1 秒(`DEPLOY_PULSE_MS`) |
| `LANDED` | 4 | \|total_g−1\|<0.15 **且** rel_alt<30m,**持續 10 秒**<br>★兩半都要有活著的感測器背書,否則不判定 |

**地面站推導(淡藍底,標「推導」)**

| 列 | 依據 | 規則 |
|---|---|---|
| `ARMED` | 下行 MSG | 收到 `MANUAL ARMED` —— 是火箭的**回讀**,不是地面站送出指令的時刻(規範 4.6.7 要的就是回讀) |
| `IGNITION` | 遙測 `GA` | **ST:0 期間只記候選**(最後一次由下往上穿過 1.5g),**等 ST 變 1 才定案**。★火箭自己看不到點火(要 2.5g×200ms,那時已過約 1.3 秒),但遙測一直在送,地面站看得到推力爬升 —— 這是量到的,不是拿常數回推。<br>★**不能在 ST:0 就定案**:那是整段待命時間,搬上架/放下/撞到/陣風都會超過 1.5g,而推導是一次性的,誤標就再也蓋不掉。<br>候選距離離架超過 5 秒不採信 —— 寧可空著也不標編出來的時間 |
| `BURNOUT` | 遙測 `GA` | ST:1 期間 `GA < 1.15`(且先看過 `GA > 1.5`)。與韌體同一門檻 |
| `COASTING` | 同 BURNOUT | 同一刻。時間戳相同**不是冗餘** —— BURNOUT 是「推力沒了」,COASTING 是「開始純靠慣性」,報告書要分開講 |
| `APOGEE` | ST 轉 2 | 進入 DEPLOYING 的那一刻,峰值已經確定。標籤帶高度 |
| `TOUCHDOWN` | 遙測 `VZ` | ST:3 期間 \|vz\| 從 >3 掉到 <1。**★這不等於 LANDED** —— LANDED 要靜止 10 秒,也就是觸水後 10 秒。落海要記的是**觸水點**,不是十秒後漂走的位置 |

**時間軸**

- **T0 = `LAUNCHED`**(離架),不是點火、也不是開傘
- **用火箭自己的時鐘**(遙測 `T` 欄的 uptime),不是地面站收到封包的時間 ——
  否則鏈路延遲與 GUI 延遲會被算進 T+
- 遙測 2Hz → **時間解析度就是 0.5 秒**,而且 T0 最多晚半包,所以之後每一格
  會系統性早約 0.3 秒。這是量測極限,不是 bug
- 火箭中途重開(uptime 歸零)會自動退回牆上時鐘

**怎麼讀顏色**

| 樣子 | 意思 |
|---|---|
| 綠底 | 火箭回報過,已經越過 |
| 灰底 | 目前所在 |
| **紅底** | 🔴 **火箭列被跳過** = 那段遙測整段掉包 |
| 淡藍底 + 「推導」 | 地面站推導出來的 |
| 白底 + 灰字 + 「—」 | 推導列還沒推導出來(**不是掉包**,火箭本來就不送) |

### 離架偵測

**合加速度 ≥ 2.5g 持續 200ms**。地面搬運甩動甩不出 2.5g,所以不會誤判。

### 🔴 2026-08-01 更新：開傘不總是靠 A∧B

`tools/fw_logic.py` 用 Python 重跑韌體的判斷（真的跑卡爾曼、真的加感測器
雜訊），餵 3.0.9 的 81 組模擬。結果與手冊裡的彈道解析估計**不一致**：

| | 解析式估計 | **真跑邏輯** |
|---|---|---|
| 上升段開傘 | 0/81 | **0/81** ✓ 兩者一致，這才是安全要求 |
| **由 C 觸發** | 0/81 | 🔴 **7/81** |
| A∧B 落在頂點後 | 1.55 s（假設） | **1.95 s（實測）** |

A∧B 慢了 0.4 秒 —— 氣壓計要**穿過自己的雜訊**才確認跌破 10m，卡爾曼也要
時間把負速度建起來。於是推力最高的 7 組，18 秒備援先到，早 A∧B 約 0.14 秒。

**不是失效**：C 在頂點後 1.67 秒觸發，火箭正在下降。但說法要改成
**「高推力端靠 C」**，`DEPLOY_TB_MS` 是承重的，不是純保險。

⚠️ 而 `fw_logic` 還**不含氣壓膜的時間常數** → 真板的 A 只會更慢，走 C 的組數只會更多。

### 開傘條件 `(A ∧ B) ∨ C`

| 條件 | 內容 |
|---|---|
| **A** | 氣壓高度低於最高點 10m(且最高點需 ≥20m) |
| **B** | 垂直速度持續向下 1.5 秒 |
| **C** | **離架後 18 秒**無條件強制開傘(備援) |

- A∧B 同時成立 = 頂點後確認下降,**最精確**
- C 單獨成立 = 感測器故障時的保底

### ★ 感測器故障時的降級規則(2026-07-30 改成不對稱)

| 死掉的 | 結果 | 為什麼 |
|---|---|---|
| **IMU 死** | **cond_A(純氣壓)單獨守門**,照常開傘 | 純氣壓無積分無漂移,峰值是單調閂鎖,假高點只會讓開傘變晚(安全方向) |
| **氣壓計死** | **主路徑整個關閉,退到 18 秒備援** | cond_B 用的 `kf2_v` 靠氣壓修正,氣壓一死就沒有修正源;滑行段近自由落體,加速度計讀 ≈0,連重力參考都失去 → 那個數字是漂移量不是量測值 |
| 兩者皆死 | 只剩備援 C | — |

> **舊版是對稱的(任一顆死掉就讓另一顆單獨決定)。已改掉**——用一個漂移中的
> 濾波器決定開傘,最壞情況是推力段誤觸 = 解體。

### 遙測上怎麼看降級

| `MOD:` | 意思 |
|---|---|
| **`F`** | 四個模組全活 ✓ |
| **`7`** | 🔴 氣壓計死(主路徑已關,只剩 18 秒備援) |
| **`B`** | 🔴 IMU 死(cond_A 單獨守門,仍會正常開傘) |
| `E` | SD 卡死(不影響開傘) |

`C:` 欄是開傘條件:`C:0` 正常飛行中 ／ `C:1` IMU 死 ／ `C:F` 兩條件皆成立(開傘)

### 實測時序(**3.0.8** 的 81 組模擬:3 推力 × 3 仰角 × 9 風況)

| | 離架偵測後 |
|---|---|
| 頂點出現 | 13.53 ~ **16.71 s** |
| C 備援觸發 | 固定 18.00 s |
| **最小餘裕** | **+1.29 s**(`T110_e80_W4`,頂點 1230m) |
| 主路徑 A∧B | 頂點 +1.55 s(「持續下降 1.5 秒」是瓶頸) |

**C 只在 6/81 組比 A∧B 早觸發**,而且全是 +10% 推力(T090 0/27、T100 0/27)。
**標稱馬達完全走 A∧B。**看到「backup timer」訊息 = 馬達超推,或氣壓路徑失效。

> 3.0.5(short) 的舊數字是 0.58 s 餘裕、25/81 走 C。**3.0.8 頂點低了約 12%,
> 滑行短 0.7 秒,兩項都因此改善**——備援餘裕變 2.2 倍,主路徑拿回主導權。

> **`DEPLOY_TB_MS` = 18 秒是定案值,不要再調。**
> 加大能買到「上升段誤觸」的餘裕,但那個後果是良性的;代價卻是氣壓計全死時
> 開傘速度從 44 → 54 m/s(衝擊負荷 1.5 倍,隨 v²),而那條路徑沒有其他保護。

### ~~氣囊~~ → **已於 2026-07-31 移除**

🔴 **這一節原本描述的自動充氣邏輯已經整組刪掉。** 氣囊不飛,而**PA0(原氣囊路)
已經並聯進降落傘的發火迴路** —— 傘要 PA0 與 PA1 同時驅動。

因此:

| 原本 | 現在 |
|---|---|
| 撞擊偵測自動充氣 | **已刪除** |
| LANDED 補充氣 | **已刪除** |
| 遠端 `/abg` | **韌體明確拒收**,地面站按鈕也拿掉了 |
| PB6 只點 PA0 | **改成同時點 PA0+PA1**(單路等於什麼都沒發生) |

⚠️ **並聯的意義:任一路單獨拉高就會點著電火頭。** 所以任何殘存的「只拉 PA0」
路徑都是活雷 —— 全部已移除,`tests/test_crossrepo_protocol.py` 有反向斷言守著。

🔴 **燒錄後必須用電表確認開傘時兩支腳都有 7V。** 這一項從未實測過。

### ~~自旋不可能誤觸氣囊~~ → 已無意義

氣囊移除後這個分析不再適用（原內容：IMU 安裝半徑 <1.5cm，5g 需 9.1 rev/s，
而陀螺儀 5.56 rev/s 就飽和，所以自旋撞不到氣囊門檻）。保留這段只是為了說明
當初為什麼判定安全 —— 現在沒有任何東西會被 5g 觸發。

## 📅 2026-08-01 13:00 的實際預測(Windy 地面預報:東北東偏東 2 m/s)

```
地面東風分量 = 2.0 × cos(11.2°) = 1.96 m/s     ← 落在判準卡的 🟡 帶
傘下等效東風 = 3.14 ~ 3.53 m/s（地面 ×1.6~1.8）
```

**九種推力×仰角組合全部在回收區內。**但餘裕差很多:

| 仰角 | 最壞落點 | 距西界 | |
|---|---|---|---|
| **79°** | +139 m | **191 m** | ✅ |
| 80° | +86 m | 138 m | ✅ |
| **81°** | **+13 m** | **65 m** | 🟡 |

> **仰角從 81° 改成 79°,餘裕從 65 m 變成 191 m —— 接近三倍。**
> 這是當天零成本、效果最大的一個動作。

南北向:最大南移約 103 m,距南界還有 1787 m ✅

### 箭身彎曲在這個風況下的容許量

```
朝西 1.0°  → 0/9 出界
朝西 2.0°  → 1/9 出界
朝西 3.0°  → 3/9 出界
```

比 3.0.5 的舊估算寬鬆(舊值 1° 就有 1 組出界)。**但彎曲朝東仍然是零成本的,照做。**

> 這是預報,不是實測。**發射前仍要現場量一次風**——風向轉北或轉南都會讓
> 東風分量變小(更安全),轉東才是要停的。

---

## 🌬️ 放行判準卡:風速風向(可單獨印一張帶去發射台)

```
┌─────────────────────────────────────────────────────────┐
│  發射前量風。只有「東風分量」要緊。                       │
│                                                          │
│  東風分量 = 實測風速 × cos(風向與正東的夾角)              │
│                                                          │
│  ┌──────────────────┬──────────────────────────────┐    │
│  │ 東風 < 1.5 m/s   │  ✅ 放行                      │    │
│  │ 或西/南/北風      │                              │    │
│  ├──────────────────┼──────────────────────────────┤    │
│  │ 東風 1.5~2.5 m/s │  🟡 確認箭身彎曲朝【東】       │    │
│  │                  │     仰角取公差下緣(79°)       │    │
│  ├──────────────────┼──────────────────────────────┤    │
│  │ 東風 > 2.5 m/s   │  🔴 暫停,等風轉               │    │
│  └──────────────────┴──────────────────────────────┘    │
│                                                          │
│  ⚠ 這是【地面實測值】。1000m 高的風約是地面的 1.6~1.8 倍  │
│    模擬的臨界值 4 m/s 是傘下的有效平均風。                │
└─────────────────────────────────────────────────────────┘
```

### 為什麼只怕東風

回收區極度不對稱:**東邊 +2812 m,西邊只有 −52 m**。東風把火箭吹向西邊的陸地。

**每 1 m/s 東風把落點往西推 82~131 公尺**,而無風落點才 +365~571 m。

| 東風(模擬中的均勻風) | 落西界以西 | 落**發射台**以西 |
|---|---|---|
| 3 m/s | 0 / 9 | 0 / 9 |
| **4 m/s** | 0 / 9 | **1 / 9** |
| 4.5 m/s | 1 / 9 | 4 / 9 🔴 |
| 5 m/s | 3 / 9 | 7 / 9 🔴 |
| 6 m/s | 8 / 9 | 9 / 9 |

**落在發射台後方比出界更嚴重**——那裡是人員位置。4.5 m/s 就有 4/9 會這樣。

### 反直覺:推力越大、仰角越垂直,越容易回陸地

```
T090  頂點 835m   飛行 146s   臨界東風 5.0 ~ 6.0 m/s
T100  頂點1008m   飛行 173s   臨界東風 4.7 ~ 5.7 m/s
T110  頂點1183m   飛行 201s   臨界東風 4.0 ~ 5.1 m/s  ← 最危險
```
(區間的兩端是仰角 81° 與 79°)

飛得高 → 傘下時間長 → 風吹得久。**在 ±1° 公差內,寧可偏低(79°)不要偏高。**

### 箭身彎曲:方向是你可以控制的

仰角每偏 1° → 落點移動約 **46 公尺**。箭身接合處彎曲 β 度,效果等同飛行方向偏 β 度。

```
向西偏 2.0°  → 1/9 出界（在 8/1 的預報風況下）
向東偏 3.0°  → 最遠 1078m，東界 2812m，完全安全
```

**上架前把火箭放平在直的參考面上轉一圈,量出彎向哪一側,做記號,上架時朝【東】。**
零成本,而且比「想辦法把箭身弄直」實際得多。

### 南北風不用擔心

每 1 m/s 只推 90~147 m,要出南北界(±1890 m)需要 **13~21 m/s** 的風——那種風不會放行。

---

## 第七部分:現場故障排除

### 收不到遙測

```
1. 看 LED 顏色 → 紫 = 後端沒開,跑 .bat
                → 黃 = 插錯裝置或鮑率錯
                → 橙/紅 = 真的沒訊號
2. 接 USB 看火箭開機報告 → LORA=0 就是模組問題,不是地面站
3. 檢查兩個頻道有沒有設成同一個 COM 埠
4. 剛剛在 GUI 改過 COM port / 鮑率 / 按過重連嗎?
   → 2026-07-30 之前這會有約 10% 機率讓解析執行緒無聲死亡,已修
```

### 改完 COM port 就整個沒資料(但 raw log 一直在長)

**這個缺陷已於 2026-07-30 修掉**(`start()` 每次重建佇列)。若跑的是舊版地面站,
症狀是:序列埠照讀、raw log 檔案照長,但畫面完全靜止且沒有任何錯誤訊息。

```
處置:把該頻道的 backend daemon 視窗【整個關掉】,再重跑 .bat
     ⚠ .bat 會偵測 port 還被綁著就跳過,所以舊視窗一定要先關乾淨
```

判斷方法:raw log 檔案大小一直增加(表示序列埠正常)但 GUI 完全靜止。

### 只有一塊板有訊號

**這不是中止的理由。** 雙板是熱備援,單板仍可完成回收。繼續任務,記下來事後查。

### 顯示「保險絲熔斷」

代表誤觸發被並聯導線擋下來了(**人是安全的**),但那塊板的 pyro 電源已死,點不了火。

- **發射前**:換保險絲
- **發射後**:靠另一塊板,不要中止

### 資料看起來不對

- **Roll 一直往一個方向漂** = 正常。六軸無磁力計,積分必然漂移
- **兩塊板數字略有差異** = 正常。各自獨立感測、獨立開機
- **切換頻道後統計歸零** = 正常。每塊板有各自的統計,切回去就回來了

### GUI 當掉

跑 `run_gui_only.bat` 重開 GUI,**後端還在跑、資料不會斷**。

---

## 第八部分:發射台流程(建議)

```
□ 1. 兩塊板燒錄「UNRESTRICTED 已關閉」的韌體
□ 2. 各自接 USB 檢查開機報告:
       · BMP/IMU/LORA 全 1、CLK=HSE、無 UNRESTRICTED 字樣
       · WHO=xx      → 69/6A(LSM6DS3) 或 6C(LSM6DSO),記下來
       · AZ_BIAS=x.x → 必須在 ±0.02 g 以內。超過表示校準那 2 秒火箭在晃,
                        放著別碰、重開一次
□ 3. 電火頭啟動開關 OFF,確認在安全狀態
□ 4. ★量箭身接合處的彎曲方向(放平在直的參考面上轉一圈),做記號
□ 5. ★量風。東風 >2.5 m/s → 暫停(見放行判準卡)
□ 6. 火箭上架、固定,**彎曲側朝東**、仰角取公差下緣(79°)
□ 7. 地面站啟動,確認兩個頻道都是綠燈
□ 8. 打 /reset-data 開新的一場
□ 9. ★★ 按「校準 ALL」→ 確認兩板都回 MSG SUCCESS RECAL
       這一步不能省,也不能用早上開機時的基準:
       氣壓漂 1.2 hPa → 誤判離架後無法撤銷;漂 2.4 hPa → C 備援的
       20m 地面保護失效。在發射台等幾小時就可能漂到。

       ★★ **判準:地面上 `RH` 顯示的數字,就是漂移量。**
          火箭沒動高度卻不是 0,只可能是基準過期。
            RH  < 5 m  ✅ 正常
            RH ≥ 5 m   ⚠  重新校準
            RH ≥ 10 m  🟠 誤判離架已【無法撤銷】
            RH ≥ 20 m  🔴 C 備援的 20m 地面保護【已失效】
          地面站會自動跳這三級告警,不用自己盯著算。
          等待期間隨時看到告警就再校準一次。

□ 10. ★★★ 確認 **`ST:0`**、高度歸零、`MOD:F`、`C:0`
       **`ST:` 一定要是 0。**如果顯示 1(LAUNCHED)代表已經被誤判離架閂死了
       ——狀態機沒有回 IDLE 的路徑,而 t_fly 會一路累積。真正發射時高度一過
       20m(離架後約 2.1 秒、39~46 m/s)備援計時早就超過 18 秒 → **當場開傘
       → 結構解體**。看到 ST:1 就斷電重開,不要硬飛。
□ 11. 人員撤離
□ 12. 依審查委員指示,從遠處武裝(拉繩/長桿)
□ 13. 地面站確認顯示「🔓武裝」(需 ADC 硬體)
□ 14. 倒數、點火
□ 15. 全程監看:狀態 0→1、高度上升、頂點、狀態轉 2、高度下降
       ⚠ 標稱馬達應該走 A∧B。看到「backup timer」= 馬達超推或氣壓路徑失效
□ 16. 落海後可用「囊 ALL」(若氣囊未自動觸發;自動觸發要等點火後 6 秒)
```

---

## 附錄:遙測封包格式

```
T12345 SQ42 AX+0.012 AY-0.003 AZ+0.998 GX+0.10 GY-0.20 GZ+0.05
P1013.25 RH0.5 KH0.3 VZ+0.01 GA1.00 ST:0 MOD:F GPS:1,9 C:0
VF8.12 VA7.98 LAT+22.17485 LON+120.89272
```

| 欄位 | 意思 |
|---|---|
| `T` | 開機至今毫秒 |
| `SQ` | 封包序號(算掉包率;數字倒退 = 火箭重開機) |
| `AX/AY/AZ` | 加速度 (g) |
| `GX/GY/GZ` | 角速度 (°/s)。**貼在 ±2000 = 陀螺飽和** |
| `P` | 氣壓 (hPa) |
| `RH` / `KH` | 相對高度(**裸氣壓**,開傘條件 A 用它) / KF 融合高度 (m) |
| `VZ` | KF 垂直速度 (m/s),開傘條件 B 用它 |
| `GA` | 合加速度 (g) |
| `ST:` | **飛行狀態 0~4**(不是 12 態!`ST:2` = 正在放傘,不是點火) |
| `MOD:` | 模組存活 hex:**`F`**=全好、**`7`**=氣壓計掛、**`B`**=IMU 掛、`E`=SD 掛 |
| `GPS:1,9` | GPS 有定位,9 顆衛星 |
| `C:` | 開傘條件 hex:`0` 正常飛行中、`1` IMU 死、`F` 兩條件成立 |
| `VF` / `VA` | 保險絲後端 / 武裝後端電壓(**-1 = 未裝 ADC**) |
| `LAT/LON` | 經緯度(**只在有定位時出現**;宣稱定位卻沒這兩欄的幀會被降級) |

完整定義:`shared/protocol.h`(C)與 `ground_side/doc/telemetry_format.md`。

**發射場**:旭海 22.174847, 120.892723,向東發射(方位 90°)。

---

## 附錄:已知的待辦(不影響本次發射的判斷)

- **SD 卡 reset 鎖卡的修復實測過但沒成功**——`sd_unstick_card` 深度救援
  沒能把卡救回來。飛行資料仍以 LoRa 遙測為主,SD 是加分項
- 氣囊硬體型式未確認(pyro 式 vs 泵)→ 1 秒脈衝夠不夠未定
- st.md 的 12 階段火箭端尚未實作(目前仍是 5 態,文件已標為未實作提案)
- 🔴 **本日(2026-07-30)所有韌體與地面站改動都未上實機驗證**——
  邏輯斷言與編譯都過,但沒有一項在板子上跑過

### 🔴 2026-07-31 全案審查後新增的燒錄前提醒

**這次改動很多,重燒後務必確認:**

```
□ 開機報告沒有 UNRESTRICTED MODE 字樣
□ MOD: BMP=1 IMU=1 LORA=1
□ 打一次 STATUS,確認 USB 指令仍正常
□ 飛行中不再能打維修指令 —— 這是刻意的
     PINTEST/PINHOLD/BUSFLOAT/READ/CLEAR/TRUNC/BRIDGE 只在 IDLE 受理
□ PB6 手動點火鈕已加閘門:必須 IDLE + ARM + GNDTEST 三者同時
     本次不使用 → 條件永遠不成立 = 等同關閉
□ SD 的 log.csv 每行現在完整(含換行)。舊版每行都被截斷 17~37 bytes,
     連 CRLF 都沒了 → 整份檔案黏成一行
```

**新增的自動保護(不需操作):**

| 情況 | 舊行為 | 新行為 |
|---|---|---|
| MCU hard fault | 永遠卡住 → 傘不開 | **自動重開 → 墜落救援接手開傘** |
| UART 溢位 | 上行永久失聰(遙測還在跑,看不出來) | 自動重掛接收 |
| 忘了關 BRIDGE 就上天 | 整場零遙測 | 離架偵測自動退出 |
| USB 拔掉後 | 每 500ms 空轉 80ms | 偵測到沒主機就停止重試 |

### 已解決(2026-07-30)

- ~~`shared/protocol.h` 與實際封包脫節~~ → 已對齊,並加了自動比對測試
  (`ground_side/tests/test_crossrepo_protocol.py`,韌體改格式會當場叫)
- ~~`telemetry_format.md` 的 ST 表是 12 態~~ → 已改正為 5 態
- ~~氣囊會被開傘衝擊誤觸~~ → 加了 6 秒 arming 延遲 + 30ms 持續要求
- ~~地面站 sentinel 毒化(改 COM port 後約 10% 機率遙測無聲中斷)~~ → 已修
- ~~GUI 階段名稱用的是未實作的 12 態表(ST:2 顯示成 IGNITION)~~ → 已改為 5 態
- ~~兩顆感測器全死時 60 秒後推測離架~~ → 已刪除(時間不是高度的證據)
- ~~落點模擬有一組出界(`T110_e81_E4` 在西界外 27m)~~ → 改用 3.0.8 後 **0/81 出界**
- ~~氣壓計死時由漂移的 IMU 一票決定開傘~~ → 改成關閉主路徑退到備援
- ~~IMU 凍結(SPI 有回應但停止轉換)偵測不到~~ → 加了凍結看門狗
