jjjay0826/rocket-system/doc/flight_161_summary.md

# 2026-08-01 旭海　第 161 隊　飛行總結

競賽成績 **第三名**。箭體未回收，僅尋回鼻錐。
本文全部結論來自**兩塊完全獨立的航電板 2 Hz 遙測** ＋ **TASA 直播存檔 59.94 fps 影像**。

---

## 一句話

**航電做對了它該做的事；失效全部發生在回收系統的機械端。**
ch1 的開傘主路徑在頂點後約 2 秒（1.6~2.1 s）觸發；ch2 主路徑失效、由 18 秒備援接手（見四）。

> **★2026-10-07 更正**：本文原寫「頂點後 1.5 秒」，是把 ch1 時鐘的開傘時刻（T+16.02）
> 減去 ch2 時鐘的頂點（T+14.5）—— 兩塊板各以「自己第一個 `ST:1` 封包」為 T+0，差 0.49 s，不能互減。
> （2026-10-15 補：這 0.49 s 是 ch1 離架時掉了兩包＋2 Hz 量化，**不是**兩板判定離架的時間差；
> 原文寫成「判定差 0.49 s」是錯的，見 parachute_failure 第 0 節。）
> 用同一塊板自己的時鐘重算（頂點以 ±3 s 內 11 點拋物線擬合）：
> 兩板頂點 ch1 T+13.9／ch2 T+14.4，換成 UTC 是同一刻（差 0.02 s）；
> cond_A 首次出現在頂點後 +1.6 s 的封包（前一包 +1.1 s 尚未成立；自由落體掉 10 m 至少 1.43 s）；
> ch1 開傘落在 +1.6~2.1 s、ch2 落在 +3.1~3.6 s（依韌體阻塞行為推算 ≈3.5 s）。區間來自 2 Hz 遙測的解析度。
> （2026-10-15：ch2 原寫 +3.1~4.1 s。上界改用「判定離架 ≤ 第一個 `ST:1` 封包」收緊，
> 推算方法見 parachute_failure 第 1 節；全部可用 `tools/verify_timeline_0801.py` 重算。）
之後拖曳傘把箭體帶進 3.2 轉/秒的自旋，
主傘在自旋中充氣、傘繩扭轉、載荷集中到少數幾條線上，結構失效，
主傘永久喪失阻力，全程以 32 m/s 落海。

---

## 一　飛行概要

| 項目 | 值 | 來源 |
|---|---|---|
| 起飛質量 | **29.999 kg**（實測） | 地面量測 |
| 推進劑 | 4.64 kg | `TASA_Pioneer_5K.eng` |
| 燃盡質量 | **25.36 kg** | 三條獨立驗證鏈一致 |
| 發射軌傾角 | 10.4° | 設定值 |
| 最大加速度 | **5.72 / 5.65 g**（比力）＝ 動力學 4.7 g | 雙板 |
| 最大上升速度 | 138.9 / 154.8 m/s | 雙板（卡爾曼，**不可靠，見四**） |
| **頂點高度** | **833.4 / 833.7 m** @ ch1 T+13.9／ch2 T+14.4（各板自己的時鐘；UTC 同一刻） | 雙板純氣壓 |
| 頂點水平速度 | 39.2 m/s | 滑行段標定 |
| 開傘點火 | **ch1 T+15.5~16.0（ch1 時鐘；A∧B，頂點後 1.6~2.1 s）／ch2 T+17.5~18.0（推算 ≈17.93；備援 C，頂點後 3.1~3.6 s）** | 遙測 ST＋MSG 順序 |
| 拖曳傘衝擊 | 6.14 g ＝ 1.53 kN @ T+18.04 | ch1 |
| 主傘衝擊 | 5.62 g ＝ 1.40 kN @ T+18.52 | ch2 |
| 傘降率 | **32.1 / 31.6 m/s**（端點法 31.0 / 30.4） | 雙板 |
| 終端阻力面積 | 主傘設計 10.4 m² 的 **4.5%** | 遙測 |
| 落點 | **離發射點 ≥807 m，方位 98°** | ch1 最後定位 |
| 收包 | ch1 80 包（含空中重開機）／ch2 91 包，飛行段遺失 3.49% | 地面站 |

---

## 二　失效因果鏈

```
拖曳傘展開　→　箭體開始繞長軸自旋
                （T+17.0 滾轉 50~68 °/s，此時 GA 才 0.4 g）
        ↓
自旋加劇到 1166 °/s ＝ 3.2 轉/秒（T+18.52，主傘充氣的同一瞬間）
        ↓
主傘在自旋中充氣，傘繩扭轉
        ↓
★ 載荷【不再平均分給 8 條線】而集中到少數幾條
        ↓
受力最大那條所在的傘布結構失效
        ↓
主傘永久喪失阻力，成為飄帶
        ↓
終端阻力 ＝ 只剩拖曳傘（設計值的 4.5%），以 32 m/s 落海
```

### 每一環的證據

**自旋是量到的，不是推論。**兩塊獨立航電板、兩顆獨立 IMU：

| ch2 T+ | ch1 滾轉 | ch2 滾轉 | 橫向 | |
|---|---|---|---|---|
| 16.50 | +15.5 | +15.4 | 小 | 點火後 0.5 s，還沒動 |
| 17.00 | **+49.8** | **+67.7** | 僅滾轉的 1/5~1/7 | **純滾轉，不是翻滾** |
| 17.50 | −100.0 | −114.7 | 110 | 方向反轉 |
| 18.04 | **−463.9** | （跳拍） | 524 | 拖曳傘衝擊 |
| 18.52 | （已失聯） | **+991.5** | 612 | **主傘衝擊，1166 °/s** |

- 推力段 `ax = −5.65 g`、`ay≈az≈0` → **X 是長軸，gx 就是滾轉率**
- 兩板點火前都讀 `+17 °/s`（同號同值）→ 軸定義一致，**正負號比較有效**
- **滾轉先於載荷**（T+17.0 已 50~68 °/s，GA 僅 0.4 g）→ 不是衝擊造成旋轉
- **是純滾轉不是翻滾**（橫向只有滾轉的 1/5~1/7）→ 扭矩來自回收硬體，不是氣動失穩
- **方向反覆反轉** → 懸吊系統變成扭轉振盪器，不是穩定自旋

**結構失效（而非可逆的束口）由兩條獨立證據支持：**

1. **扭轉在 T+22 就鬆開了**（滾轉降到 ±20~150 交替＝正常鐘擺），
   但 T+22~43.6 的下降率完全平直，**21 秒零恢復** → 損傷是永久的
2. **終端阻力精確等於「只有拖曳傘」**（設計值的 4.5%，等效布面約 0.8 m 見方）。
   被束口的傘通常仍有滿開的 10~30%，**主傘貢獻字面上的零**

**「載荷太低撕不動」這個反駁不成立** —— 1.40 kN 是 2 Hz 取樣的下限，
而且**傘在 1000 °/s 自旋時載荷根本不平均分配**。陀螺儀資料不是在反駁撕裂，
是在**解釋撕裂為什麼會發生**。

---

## 三　★ 第二個問題：設計本身

**這條與自旋完全獨立，就算沒有自旋也會發生。**

主傘滿開的設計下降率 6.4 m/s，很理想。但開傘載荷取決於開傘瞬間的速度，
以及傘張開要花多久（[`tools/opening_load.py`](../tools/opening_load.py)，張開時間 0.1～0.4 s）：

| 開傘速度 | 全開衝擊力 | 瞬間全開（上限） | 與驗證過的強度比 |
|---|---|---|---|
| **39～41 m/s**（本次實際） | **約 240～490 kgf** | 約 900～990 kgf | ❓ 超出驗證範圍 |
| **31 m/s**（拖曳傘終端） | **約 170～330 kgf** | 約 565 kgf | ❓ 超出驗證範圍 |
| 20 m/s | 約 100～170 kgf | 約 235 kgf | ⚠ 在邊緣 |

**驗證過的強度**：傘繩固定結構靜態拉到 **134.3 kgf 未壞**（隊上設計報告；受限於兩人體重，
不是破壞值）；8/1 飛行中撐過至少 **156 kgf** 的拖曳傘衝擊。

主傘設計成「直接跟著拖曳傘」，而拖曳傘終端就是 31 m/s ——
**這副主傘在原設計流程下，全開衝擊力會超出目前驗證過的範圍。**會不會壞不知道，
因為從來沒有拉到破壞過（見 [known_issues.md](known_issues.md) #29）。

> **★2026-10-09 更正**：本節原本寫「41 m/s 滿開 8.8 kN、會直接拉爆箭身」。
> 8.8 kN 是「瞬間全開」的上限，而「拉爆箭身」從來沒有任何強度分析或測試支持，已刪除。

> 附帶：主傘從未在氣動意義上完全張開。影像上 T+18.486 攤得最開，
> 但 ch2 在 25 ms 後只讀到 5.62 g；那一刻的有效阻力面積**只有全開的約 15%**。
> （2026-10-15：影像對齊已實測，誤差 ± 0.07 s，所以「25 ms」應讀作「± 0.1 s 內」；
> 15% 是 ch2 那一筆純遙測算出來的，成立。見 parachute_failure 第 0.1 節。）
> 從第一次看得到傘衣到攤得最開約 0.27 s（傘在自旋中，只能當量級參考）。

---

## 四　各子系統成績單

| 子系統 | 結果 | 說明 |
|---|---|---|
| **開傘判定邏輯** | ⚠ **一板成功、一板靠備援** | ch1 走 A∧B（頂點後 1.6~2.1 s）；**ch2 的 cond_B 從未及時成立，靠 18 秒備援 C 開傘**。韌體訊息明載 `backup timer T>18s`。cond_A 本身兩板差 13~36 ms，沒問題 |
| **氣壓計 BMP585** | ✅ 優 | 兩板頂點差 **0.3 m** |
| **IMU LSM6DS3** | ✅ 優 | 提供了本次唯一的關鍵證據 |
| **LoRa E22** | ✅ 良 | 飛行段遺失 3.49%，兩板皆然 |
| **雙板熱備援** | ✅ **關鍵** | 兩次開傘衝擊**各只有一塊板錄到**。單板就永遠不知道有兩次 |
| **卡爾曼高度濾波** | ⚠ 差 | 頂點兩板差 **3.5 m**（純氣壓只差 0.3 m）—— **濾波器在增加誤差** |
| ↳ 卡爾曼垂直速度 | 🔴 **導致 ch2 主路徑失效** | 頂點 ch1 −2.42／ch2 **+11.65** m/s（真值 0）；開傘衝擊時 ch2 衝到 **+30.86**（實際在以 30 m/s 下降）。根因＝Mahony 缺 `|a|` 閘，已修 |
| **GPS AT6558** | 🔴 失效 | 上升段凍結 17 s／49 m。ch2 下降段軌跡 527 m 路徑對 42 m 淨位移 |
| **SD 卡** | 🔴 不可用 | 已知的 reset 鎖卡問題，且卡隨箭體沉沒 |

### GPS 失效的定位

- 韌體**完全沒有做任何濾波**（`gnss.c` 167 行，直接賦值，零組態位元組）→ 失效在模組內部
- 全程 `fix=1`、`sats=24~25` → **沒有任何帶內指示**，地面無從察覺
- 資料表 **Maximum Acceleration 4 g** vs 實測動力學 **4.7 g** → 超規 18%，強假說但**未證實**
- ch1 空中斷電重開機後 GPS 完全正常（54 m 路徑／20 m 淨位移）→ 冷啟動可復原

---

## 五　雙板互證（本次最強的資產）

兩塊板**電源、感測器、天線全部獨立**，不預設誰是真值，兩者的差就是量測不確定度。

| 量 | ch1 | ch2 | 差 |
|---|---|---|---|
| 頂點純氣壓高度 | 833.4 m | 833.7 m | **0.3 m (0.04%)** |
| 推力段最大加速度 | 5.72 g | 5.65 g | **1.2%** |
| 傘降率 | 32.1 m/s | 31.6 m/s | **1.5%**（端點法 2.0%） |
| cond_A 觸發 | — | — | **13~36 ms** |
| 頂點卡爾曼高度 | 834.3 m | 837.8 m | 3.5 m |
| 最大上升速度 | 138.9 m/s | 154.8 m/s | 10.3% |
| cond_B 觸發 | — | — | **4.5 s** |

**上半部（純量測）一致到儀器精度；下半部（經過卡爾曼濾波）差一到兩個數量級。**
這是本次最乾淨的一條系統性結論：**純氣壓判據可靠，卡爾曼速度判據不可靠。**

> ch1 的傘降率是**空中斷電重開機、重新取零點之後**獨立量到的
> （重開機後又送回 41 包，最低到 10.2 m，比 ch2 的 20 m 還低）。
> 兩次完全獨立的量測差 1.5～2.0%。

### 質量閉合（三條獨立鏈）

| 方法 | 結果 |
|---|---|
| 引擎峰值推力 1469 N ÷ 實測 5.72 g | 25.0 kg |
| 實測起飛 29.999 − 推進劑 4.64 | **25.36 kg** |
| 傘降終端速度 ＋ 阻力反解 | 25.2 kg |

以 29.999 kg 正算峰值比力得 **5.65 g**，ch2 實測 **5.65 g** —— **誤差 0.0%**。
**引擎的峰值推力符合規格。**

---

## 六　無解清單

### 🔴 永久無解（箭體沉沒）

最大的單一損失是**板 2 的 SD 卡（50 Hz）**，它本來能一次解決：

- 引擎**實際總衝量**（峰值已證實符合，總衝量因 2 Hz 在 3 秒推力段只有 6~7 點且分不出阻力，**兩個方向都證不了**）
- 開傘衝擊真峰值（1.53 kN 只是下限）

> **★2026-08-07 更正**：原本列在這裡的「卡爾曼板間差異的根因」與「`kf2_v` 有沒有
> 彈回」**已經解開了，而且不需要那張卡**。根因是 `mahony_update()` 沒有 `|a|` 閘 ——
> 滑行段 `|a|≈0.06 g`（純阻力雜訊）也被正規化當成重力，方向取決於各板安裝姿態，
> 所以兩板歪的程度不同。頂點實測 ch1 vz=−2.42、ch2 vz=**+11.65**（真值 0）。
> 已修，見 `0b1c66b`。

傘的實體問題同樣全部關閉：破壞的確切形式、哪條繩先失效、破口從哪個角、
有無布片脫離、有無裝轉環。

> 影像也幫不上：傘衣僅約 80 px，候選碎塊 10~30 px，H.264 在該位元率下吃掉了。
> 最近鄰追蹤 2~3 幀即失效。**不要基於這段影片宣稱「看到布片飛走」。**

### 🟡 這次無解，下次量得到

| 問題 | 下次怎麼解 |
|---|---|
| 自旋的扭矩源頭（十字傘固有旋轉／倒飛尾翼／傘袋抽出） | 提高陀螺取樣率；地面拖曳測試單獨量十字傘旋轉傾向 |
| 累積扭轉圈數 | 同上（2 Hz 取樣 3 Hz 自旋且方向會反轉，積分無意義） |
| GPS 為什麼凍結 | 震動台／離心台架把模組推到 5 g |
| ~~卡爾曼板間差異的機制~~ | ✅ **已解**（Mahony 缺 `|a|` 閘），不需台架 |
| 修正後的門檻抗噪表現 | 台架跑真實 50 Hz 氣壓，確認 `vz_baro_lp` 不會在 −0.5 附近抖 |

### 🟢 有解，只是還沒做

- `main.c` 的字串修復（`f6f4c1d`）與**估計器四項修正**（`0b1c66b`）已推送，但**尚未實機編譯燒錄**
- 確認哪個韌體 binary 真的飛了（遙測反推 K1 增益比原始碼小 10×，比對 git 即可）
- `GA_ALT`／`GA_SPD` 已解析進 `GNSS_Data` 但從未送出
- 🔴 pad misfire 路徑：誤判離架 → `baro_untrusted` 於 +5 s 移除 20 m 閘 → +18 s 無條件點火且不可撤銷
- SD reset 鎖卡（四次修改未成功）

---

## 七　下次要改什麼

按優先序。前三項針對本次失效，後三項針對「下次要能查得出來」。

1. **拖曳傘與主吊帶之間加轉環**，能在 1.5 kN 載荷下自由旋轉。
   這是整條因果鏈的**起點**，也是唯一能用一個零件擋掉全部後果的環節。
   > 航電板（裝在箭身裡）錄到 3.2 轉/秒 → 扭矩一路傳到箭身 →
   > **要嘛沒裝轉環，要嘛卡死或規格不足**。

2. **主傘不可直接跟著拖曳傘。**擇一：
   - 雙段式：拖曳傘先降到 ≤20 m/s，主傘延遲到 200~300 m 再開
   - 收口（reefing）：主傘先以縮口張開，數秒後解除

3. **傘衣補強按「單條繩承受總載荷的數倍」設計，不是「總載荷 ÷ 繩數」。**
   本次總載荷 ≥1.4 kN 除以 8 條只有 175 N，任何繩都撐得住 ——
   但實際載荷全壓在少數幾條上。**平均值在自旋的傘上沒有意義。**

4. **拖曳傘偏小。**約 0.44 m² 的 CdA 給 25.4 kg 得 32 m/s；要 20 m/s 需約 **1.1 m²**（2.5 倍）。

5. **遙測封包加 `|w|`（合角速度）。**本次的關鍵證據是事後才從封包裡讀出來的；
   若直接送出，**地面在飛行當下就會看到 1166 °/s**。加一個欄位而已。

6. **加速規加峰值保持暫存器。**成本近乎為零。本次兩次衝擊各只有一塊板錄到，
   純屬運氣；有峰值保持不但不會漏，1.53 kN 那個下限也會變成真值。

---

## 附　相關文件與工具

| 檔案 | 內容 |
|---|---|
| `doc/parachute_failure_20260801.md` | 開傘失效的完整分析（本文第二、三節的展開） |
| `tools/parse_raw_lora.py` | 原始 log → CSV ＋ 事件檔（含 UTC 對齊） |
| `tools/flight_report.py` | 雙板儀表板（含空中重開機的自動處理） |
| `tools/compare_boards.py` | 雙板逐項對照 |
| `tools/fragment_track.py` | 傘衣碎塊多物體追蹤（本次證明此footage 解析度不足） |
| `tools/README.md` | 兩條管線的完整使用說明 |

### 這批分析的共同原則

1. **量到的 vs 算出來的分開標。**每個數字都註明來源。
2. **兩塊板對等。**不預設誰是真值，兩者的差就是量測不確定度。
3. **不要用猜的。**對齊準不準、裁切有沒有切到、GPS 可不可信，
   都用可以重跑的量測去判，並把判據印出來。
