jjjay0826/rocket-system/doc/final_presentation_plan.md

# 決賽簡報規劃 — 161 隊

> ## 🟡 歷史文件 —— 2026 決賽已結束，**本隊第三名**
>
> 本文寫於簡報之前，**部分主張已不成立**：
>
> - 「發射後完整性 20 分」原本主張滿分。**最終只尋回鼻錐**，
>   該項在評分表上落在「有損壞缺件」。
> - 「漂浮／打撈」的推分規劃同樣建立在箭體回收之上。
>
> **下一屆仍然可以用的部分**：§1 的**評分表逐項拆解**（分數分布在哪裡、
> 哪些該守哪些該推）、§3 的**論述框架**（怎麼講技術爭議才不會扣分）、
> 以及「雙板互證」那一頁的敘事結構。
>
> 技術結論一律以 [flight_161_summary.md](flight_161_summary.md) 為準。
> 文件導覽 → [README.md](README.md)

> 依據《2026 台灣盃火箭競賽各階段評分表》「決賽評分表-1K組」逐項規劃。
> 所有數字來自 2026-08-01 實飛的雙板遙測，可回溯到原始 log 的哪一列。

---

## 0. 簡報之前一定要做的三件事

| # | 事情 | 為什麼是最優先 |
|---|---|---|
| **A** | **把板 2 的 SD 卡資料救出來**（`tools/recover_log.py`） | 板 2 全程 `MOD:F`，SD 健康。但 `ST` 從沒進 LANDED → `f_truncate` 沒跑 → 檔案是 16MB＋垃圾尾巴，**直接打開會看到亂碼，要用腳本切**。裡面是 **50 Hz** 資料，遙測只有 2 Hz。它能給你兩樣簡報裡最值錢的東西：① 真正的開傘衝擊峰值 ② 精確的燃盡速度（＝把「推力不足」和「阻力偏高」分開的唯一辦法） |
| **B** | **看發射影片** | 「降落傘不完全開啟」這 5 分完全靠它。影片 21.5 秒，正好涵蓋點火到開傘後 |
| **C** | **確認燒進去的韌體版本** | 遙測反推的卡爾曼增益 K1 比原始碼常數小 10 倍，懷疑飛的不是 repo 那份。這件事若被評審問到而答不出來，會傷到所有「箭上資料」的可信度 |

---

## 1. 評分表拆解 — 分數在哪裡

**已主張的（紅框）＝ 47.5 分。**「放棄」的意思是不再往上追一階，不是棄權。

| 項目 | 配分 | 已主張 | 這份簡報要做的事 |
|---|---|---|---|
| 總飛行時間差異度 | 20 | **0** | 已認。不爭。**但仍要交數據**（理由見下） |
| 降落傘開啟與否 | 10 | **半分 5** | 🛡 **守住**——被壓到「無運作」就是 0 |
| 漂浮／易於打撈 | 10 | **半分 5** | ⬆ **推到滿分（＋5）** |
| 發射後完整性 | 20 | **滿分 20** | 🛡 **守住**——這是最大的單一數字 |
| 數據資料回收（加分） | 每感測器 +1 | — | ⬆ **最大槓桿（最多 ＋16）** |
| 海報成果展示 | 5 | 半分 2.5 | ⬆ **推到滿分（＋2.5）** |
| 發射前準備狀態 | 15 | **滿分 15** | 🛡 守住 |
| 設計規範（扣分） | −1／項 | — | 別踩 |

### ★ 三個要守、三個可推

> **要守的（現在手上的 40 分）比可推的（最多 23.5 分）更重要。**
> 一次失守就抵掉所有往上推的努力 —— 尤其「完整性滿分 20」。

**守 ①　發射後完整性 20 分**

風險：以 **30 m/s（108 km/h）** 觸水，衝擊動能約 11,600 J，相當於從 47 m 自由落下。
評審會特別看尾翼、外殼、鼻錐。

- **簡報前一定要自己先把箭體逐項檢查完，知道哪裡有傷**，不要被評審先發現
- 論述主軸：評分標準寫的是「**非系統設計**損壞」
  - 鼻錐彈出 → **系統設計**（回收機構本來就要噴出）
  - 降落傘狀態 → 已在「降落傘開啟與否」那 10 分計過，**不應重複計扣**
  - 若真有結構傷 → 主動指出，並用上面的衝擊能量說明這是**回收系統失效的下游後果**，
    不是結構設計缺陷。結構在飛行段（5.65 g 推力、開傘 6.14 g）完好無損。

**守 ②　降落傘半分 5 分**

風險：南灘工作人員若記錄成「沒看到傘」，就會被壓到「無運作」＝ 0。
→ 第 5 頁那四條證據鏈就是為這件事準備的。**這是「箭上資料雙重確認」最該用的地方。**

**推 ①　漂浮／打撈 半分 → 滿分（＋5）**

評分標準原文是「**是否漂浮於海面且易於搜尋打撈** ／ 火箭有無順利完整回收」。

你們有一個別隊多半沒有的東西：**航電提供了落點座標**。

- 最後一包（T+43.55 s，高度 20 m）：**22.17411 N, 120.89983 E**
- 相對發射點 **728 m、方位 97°**
- 外推到水面只再多 12～39 m
- 官方影片已拍到箭體漂浮於海面

→ 主張：**「易於搜尋打撈」的條件由航電系統主動達成了**。
打撈作業的困難不等於火箭不易搜尋 —— 座標一直都在。
若箭體完整回收，即符合「順利回收」。

**推 ②　加分項（最多 ＋16）**

見第 3 頁。這項**沒有分級**，完全看評審認定，是唯一還有大空間的地方。

**推 ③　海報 半分 → 滿分（＋2.5）**

這項 100 % 在你們控制範圍內。用雙板互證那張圖當主視覺，
比任何設計說明都有說服力。

### 關於「總飛行時間」已認 0 分

該欄寫「>20 % **或未有數據**」——兩者都是 0，**交數據不會讓這格變高**。

但仍然要交，理由有三：
1. **加分項**寫的是「審查委員依據團隊提供之分析結果」——飛行時間的完整分析是其中一份
2. 你若能自己算出「傘正常的話會是 143 s、差 10.3 %」，證明你**知道分數是怎麼掉的**
3. 這是後面談引擎時唯一站得住的鋪陳（見第 7 頁拆帳表）

---

## 2. 簡報結構（建議 12 頁）

### 【第 1 頁】一句話定調

> 「這趟飛行的**回收系統失效**，我們沒有迴避。
> 但航電系統完整記錄了全程，而且是**雙板獨立互證**——
> 以下每一個結論都有兩條獨立的證據鏈。」

**先認失敗**。評審看過太多把失敗講成成功的簡報。先認，後面的每句話可信度都不同。

### 【第 2 頁】雙板互證 —— 這是本隊的護城河

| 量 | 板 1 | 板 2 | 差 |
|---|---|---|---|
| 頂點高度 | 833.3 m | 833.7 m | **0.3 m** |
| 最大加速度 | 5.72 g | 5.65 g | 1.2 % |
| 頂點時水平速度 | 46.7 m/s | 45.3 m/s | 3 % |
| cond_A 觸發時刻 | — | — | **10 ms** |

再加一條：**用原始壓力值（不是韌體算好的高度）套氣壓公式獨立反算，
三個相距 400 m 的點都吻合到 0.2 m 內。**

→ 這頁的目的是讓評審接受「這隊的數字可以信」。**後面所有主張都靠這頁。**

### 【第 3 頁】感測器資料回收清單（加分項，逐項列）

每個感測器一列，**附一張該感測器的實際曲線**。不要只列表格。

| # | 感測器 | 資料品質 | 證據 |
|---|---|---|---|
| 1 | BMP585 氣壓 | ★ 雙板互證 0.3 m | 高度剖面圖 |
| 2 | BMP585 溫度 | 完整 | 溫度歷程 |
| 3 | LSM6DS3 加速度（3 軸） | 完整、未撞量程（用掉 35 %） | 加速度歷程 |
| 4 | LSM6DS3 陀螺（3 軸） | 完整、未撞量程（用掉 43 %） | 滾轉率歷程 |
| 5 | GNSS 定位 | **部分可用**，上升段解算凍結 | 航跡圖＋誠實標註 |
| 6 | GNSS 衛星數／fix | 完整 | — |
| 7 | LoRa 鏈路品質 | 飛行段掉包 3.5 %、全檔 0.16 % | SQ 連號分析 |
| 8 | SD 卡 50 Hz 記錄 | 待救出（見 0-A） | — |

> **🔴 不要把 VF／VA（保險絲／arming 電壓）列進去。**
> 分壓電路實際沒焊，全程輸出 −1.00。列進去被抽查到，
> 上面 7 項的可信度會一起被打掉。**少拿 2 分，保住 14 分。**

GNSS 那項**主動講出缺陷**（上升段凍結）反而加分——顯示你們真的分析了，
不是把資料丟出來湊數。

### 【第 4 頁】飛行事件時序（放那張儀表板圖）

`flight_161_20260801_report.png`。重點標三件事：
- 頂點 833.3 m @ T+13.87 s
- **板 1 靠 A∧B 開傘（T+16.02）／板 2 靠備援計時器（T+18.0）—— 雙冗餘兩條路都動作了**
- 板 1 遙測在開傘衝擊（6.14 g）當下中斷

第二點要講出來：**這是熱備援設計成功的直接證據**，不是失敗。

### 【第 5 頁】降落傘：爭「不完全開啟」的 5 分

證據鏈，四條，缺一不可：

1. **有點火**：兩塊板的韌體訊息都明載開傘指令發出（原文可秀）
2. **有出艙**：T+17.52 s 量到 **6.14 g** 的衝擊 —— 沒有東西出去就不會有這個
3. **沒充氣**：開傘後下降率 **30.9 m/s** 等速到底，反解有效阻力面積**只剩設計的 4.5 %**
   （★ 這個比值**與假設質量無關**，分子分母都正比於 m，評審沒得挑）
4. **不是翻滾**：下降段橫向合成角速度 RMS 只有 28 deg/s（每 12.7 秒才轉一圈），
   姿態穩定 → 是 **streamer（出艙未充氣）**，不是「無運作」

> **主張**：符合「不完全開啟或斷裂」＝ **半分**，不是「無運作」＝ 0 分。

**加一句解釋原因**（顯示你們知道為什麼，不是運氣）：
開傘瞬間速度**偏離鉛直 65°**、側向 45 m/s。傘是在橫向氣流裡被拉出去的，
這是 streamer 最典型的成因。

### 【第 6 頁】回收與完整性（30 分）

- **漂浮**：官方影片有拍到漂浮於海面 → 主張「順利回收」或至少「部分回收」
- **完整性**：箭身整體保持相對完整。
  **關鍵論述**：評分標準寫的是「**非系統設計**損壞」。
  降落傘是回收系統的**消耗性元件**，其狀態應歸「降落傘開啟與否」那 10 分項，
  **不應在「火箭外觀完整性」重複計扣**。
- 若有尾翼／外殼損傷，**主動指出並用資料說明成因**：
  以 30 m/s（108 km/h）觸水，衝擊動能約 11,600 J，
  相當於從 47 m 高度自由落下 —— **這是回收系統失效的下游後果，不是結構設計缺陷**。

### 【第 7 頁】總飛行時間：誠實拆帳（這頁決定你們的格調）

不要辯解。直接把帳攤開：

| 情境 | 頂點 | 飛行時間 | 差異度 | 得分 |
|---|---|---|---|---|
| 模擬宣告（標稱推力／80°／靜風） | 941 m | 159.6 s | — | 20 |
| 若傘正常、頂點仍是實測的 833 m | 833 m | 143 s | 10.3 % | 10 |
| **實際** | 833 m | **約 44 s** | **72 %** | **0** |

> **拆帳結論：推力不足約佔 10 分、降落傘失效約佔 10 分。責任各半。**

**主動說出「降落傘那 10 分是我們自己的責任」**——
這句話講出來，後面談引擎才不會被當成推卸。

### 【第 8～9 頁】引擎推力議題（見第 3 節，兩頁）

### 【第 10 頁】根因與已完成的改正

不要只列問題，要列**已經動手的**：

| 問題 | 根因（有算式） | 狀態 |
|---|---|---|
| 卡爾曼速度偏差 +13 m/s | Mahony 濾波器把「阻力」誤認為重力，燃燒結束後 180° 翻轉 | 已定位到 `main.c` 行號，修法 3 行 |
| cond_B 遲到 | 上述偏差 ＋ T+16.5 一次 +8 m 氣壓突波重置計時器 | 已定位 |
| 降落傘 streamer | 開傘時偏離鉛直 65°、側向 45 m/s | 待設計改正 |
| 上升段 GNSS 凍結 | 未做動態模式設定、韌體無陳舊解偵測 | 已定位 |

**這頁是給評審看「這隊會不會從失敗學到東西」的。權重比看起來高。**

### 【第 11 頁】雙板熱備援的價值（本隊最大的技術亮點）

這趟飛行**證明了**雙板獨立備援不是紙上談兵：

- 板 1 在開傘衝擊當下失聯（6.14 g，SD 同時死）
- **板 2 完整記錄到落地前 20 m**
- 若只有一塊板，就看你抽到哪一塊 —— 抽到板 1 就什麼都沒有

而且兩塊板的**開傘決策走了不同路徑**（A∧B ／ 備援計時器）都成功動作。

### 【第 12 頁】結語與請求

---

## 3. 引擎推力議題 —— 怎麼講才有殺傷力

### 3.0 先認清一件事：這一段**買不到分數**

「總飛行時間」已經主張 0 分，而該欄「>20 %」和「未有數據」同格。
**引擎議題不會讓那 20 分回來一分。**

所以它的定位只有三個，都不是「申訴」：

1. **加分項的分析深度**（審查委員依據團隊提供之分析結果）
2. **回答「1K 組為什麼只飛到 833 m」** —— 這題一定會被問，不能沒有答案
3. **回饋給後續使用同批次引擎的隊伍**

★ **順序很重要**：先認自己的錯（降落傘、飛行時間），**再**談引擎。
   反過來講，整段會被當成推卸，連帶傷害你正在守的「完整性 20 分」。

### 3.1 措辭框架：**不要用「質疑」**

指控的框架 → 評審預設防衛姿態 → 你要證明到 100 % 才會被接受。
**量測 ＋ 提問**的框架 → 評審變成一起看數據的人 → 你只要把數據做乾淨。

而且 TASA 就是主辦方。**用指控的語氣，你輸掉的不只是這一題。**

### 3.2 你手上真正有的東西

用**你們自己在發射前提交的 81 組模擬矩陣**（含 T090／T100／T110 三檔推力）
去反查實測頂點落在哪裡 —— 這是最強的論證，因為**基準是主辦方已經收到的文件**。

| 推力設定 | 模擬頂點（仰角 79–81°，各風況） |
|---|---|
| T090（90 % 標稱） | 696 – 814 m |
| **T100（標稱）** | **864 – 985 m** |
| T110（110 %） | 1011 – 1160 m |
| **實測** | **833.3 m** |

**實測值落在 T090 與 T100 兩個區間之間，不在 T100 的區間內。**

線性內插（斜率 16.8 m 頂點／1 % 推力）：

- 對 T100 中位數 928 m → 等效推力 **94.4 %**
- 對 e80 靜風單一組 941 m → 等效推力 **93.6 %**

> **等效推力 ≈ 94 % 標稱，即約 6 % 的缺口。**

### 3.3 ★ 這頁一定要自己先說出來（否則被評審說出來就慘了）

**「等效推力 94 %」這個數字，混合了三件事：**

1. 推力（或總衝量）不足
2. 阻力比模型高
3. 質量比模型重

**2 Hz 遙測分不開這三個。** 要分開只有一個辦法：
**燃盡瞬間的速度**——它幾乎只由推力與質量決定，與滑行段的阻力無關。

而燃盡只有約 2.5 秒，2 Hz 只取到 5 個點，梯形積分誤差 ±10 %，**不夠**。
**50 Hz 的 SD 卡資料可以**（見 0-A）。

→ **所以簡報時要說：「我們正在救出 50 Hz 記錄，屆時提供燃盡速度的精確值。」**

這句話的作用：把「我們有懷疑但證據不足」轉成
「我們知道證據不足在哪裡，而且知道怎麼補」。**後者是工程能力的展現。**

### 3.4 建議的措辭（可直接照唸）

> 「我們在發射前提交的模擬矩陣包含三檔推力設定。
> 實測頂點 833.3 公尺——這個數字由**兩顆獨立氣壓計互證到 0.3 公尺**，
> 而且我們用原始壓力值重新反算驗證過。
>
> 833 公尺落在我們模擬的 90 % 推力與 100 % 推力兩個區間**之間**，
> 線性內插對應**約 94 % 的標稱推力**。
>
> 我們要強調：這個 94 % 是**等效值**，它同時包含了推力、阻力、質量三個因素，
> 我們目前的 2 Hz 遙測**分不開**。要分開需要燃盡瞬間的速度，
> 那在我們箭上的 50 Hz 記錄裡，我們正在救出。
>
> 因此我們的請求不是主張引擎有問題，而是：
> **能否提供本批次 Pioneer 5K 的實際地面試車曲線或批次驗收數據？**
> 有了它，我們就能把這 6 % 的缺口歸屬清楚——
> 如果是我們的阻力估算或質量控制，我們會據此改進；
> 如果是推力，也希望能回饋給後續使用同批次引擎的隊伍。」

### 3.5 把「請求」設計成對方容易答應的

不要要求「承認推力不足」。要求**資料**：

- 本批次 Pioneer 5K 的地面試車推力曲線
- 或批次總衝量驗收值
- 或同批次其他隊伍的實測頂點（匿名即可）

最後一項特別聰明：**如果同批次多隊都低於模擬，那就不是單一隊伍的問題。**
這句話可以講出來——它把議題從「你們隊的問題」變成「值得看一下的共同現象」，
而且**其他隊伍會站在你們這邊**。

---

## 4. 預期質詢與準備好的答案

| 評審會問 | 準備好的答案 |
|---|---|
| 「你怎麼知道不是你們阻力估高了？」 | **先承認分不開**（見 3.3），然後說 50 Hz 燃盡速度可以分。**不要硬拗。** |
| 「發射仰角是多少？會不會是角度問題？」 | 靜置加速度計反算約 **79.6°**（推導值，不確定度 ±2–5°），**與模擬的 80° 一致**。角度不是原因。 |
| 「你們的降落傘明明沒開，為什麼還要半分？」 | 四條證據鏈（第 5 頁）。核心是 6.14 g 衝擊證明「有東西出去」＋ 姿態穩定證明「不是自由翻滾」。 |
| 「44 秒和 159 秒差這麼多，數據可信嗎？」 | 兩顆氣壓計互證 0.3 m，且用原始壓力值獨立驗算。**差異不是量錯，是傘沒作用。** |
| 「為什麼你們的高度和地面站顯示的不一樣？」 | 誠實說：韌體的卡爾曼速度有 +13 m/s 偏差，根因已定位到 Mahony。**高度沒問題，速度有問題。** |
| 「加速度只到 5.65 g，會不會是 IMU 飽和？」 | 沒有。量程用掉 35 %，無截斷特徵。 |
| 「上升段 GPS 為什麼不動？」 | 高動態下解算凍結，韌體無陳舊解偵測。**主動承認，列為改正項。** |

---

## 5. 不要做的事

1. **不要把 VF／VA 列進感測器清單。** 分壓沒焊，全程 −1.00。
   被抽查到，其他 7 項的可信度會一起被打掉。**少拿 2 分，保住 14 分。**
2. **不要用「質疑」「不足」當標題字眼。** 用「量測結果與模擬的差異分析」。
3. **不要把引擎放在降落傘前面講。** 順序錯了就變推卸，會連累你正在守的 20 分。
4. **不要宣稱 94 % 是純推力缺口。** 先自己說它是等效值（含推力＋阻力＋質量）。
5. **不要秀韌體算的下降速度（12.9 m/s）。** 那是錯的。用氣壓實測的 30.9 m/s。
   兩個數字都出現在同一場簡報裡，評審會問哪個才算數。
6. **不要去爭「總飛行時間」的分數。** 已認 0，爭不回來，而且會消耗評審耐心 ——
   那份耐心要留給「漂浮／打撈推到滿分」。
7. **不要在檢查箭體之前就宣稱「無損壞」。** 先自己看完，再決定論述怎麼寫。

---

## 附錄：這份規劃用到的原始檔案

```
doc/flightdata/20260801/raw_ch1_...5e03e520.log   板 1 原始遙測
doc/flightdata/20260801/raw_ch2_...c212c94f.log   板 2 原始遙測
sim/models/3.0.9.ork                              發射前模擬檔（TASA Pioneer_5K）
doc/sim309_81cases.csv                            81 組模擬矩陣
tools/parse_raw_lora.py                           遙測解析
tools/compare_boards.py                           雙板交叉比對
tools/flight_report.py                            儀表板產生
rocket-system\tools\recover_log.py                    SD 卡救援（★見 0-A）
```
