jjjay0826/rocket-system/doc/flightdata/20260717_test/IMU_002.CSV

ts_us | gx_dps | gy_dps | gz_dps | ax_g | ay_g | az_g | g_tot | baro_m | kf_vz_ms | kf_h_m
2000 | 1.89 | 1.05 | -2.1 | 0.0547 | 0.0527 | 1.0078 | 1.011 | 0 | 0 | 0
4000 | 2.1 | 0.98 | -2.17 | 0.0464 | 0.0518 | 1.0112 | 1.014 | 0 | 0 | 0
6000 | 2.03 | 1.12 | -2.1 | 0.0562 | 0.0483 | 1.0146 | 1.017 | 0 | 0 | 0
8000 | 1.89 | 0.98 | -2.1 | 0.0547 | 0.0571 | 1.0127 | 1.016 | 0 | 0 | 0
10000 | 1.89 | 1.33 | -1.96 | 0.0498 | 0.0503 | 1.0063 | 1.009 | 0 | 0 | 0
12000 | 1.89 | 1.33 | -1.96 | 0.0498 | 0.0503 | 1.0063 | 1.009 | 0 | 0 | 0
14000 | 2.03 | 1.19 | -1.96 | 0.0493 | 0.0522 | 1.0049 | 1.007 | 0 | 0 | 0
16000 | 2.1 | 0.98 | -2.24 | 0.0503 | 0.0498 | 1.0112 | 1.014 | 0 | 0 | 0
18000 | 2.1 | 0.98 | -2.17 | 0.0557 | 0.0562 | 1.0117 | 1.015 | 0 | 0 | 0
20000 | 2.1 | 0.98 | -2.24 | 0.0503 | 0.0464 | 1.0117 | 1.014 | 0 | 0 | 0
22000 | 1.96 | 1.12 | -2.24 | 0.0591 | 0.0483 | 1.0171 | 1.02 | 0 | 0 | 0
24000 | 1.96 | 1.12 | -2.24 | 0.0591 | 0.0483 | 1.0171 | 1.02 | 0 | 0 | 0
26000 | 1.96 | 1.26 | -2.17 | 0.0508 | 0.0557 | 1.0112 | 1.014 | 0 | 0 | 0
28000 | 1.96 | 1.05 | -2.17 | 0.0483 | 0.0542 | 1.0112 | 1.014 | 0 | 0 | 0
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
