jjjay0826/rocket-system/doc/flightdata/20260605_drop_tests/IMU_20260605_1723.CSV

ts_us | gx_dps | gy_dps | gz_dps | ax_g | ay_g | az_g | baro_m | vz_ms | imu_hz_m
2000 | 0.37 | -0.24 | -0.49 | 1.0005 | 0.0938 | 0.0342 | 0.00 | 0.000 | 0.000
4000 | 0.31 | -0.31 | -0.49 | 0.9971 | 0.0918 | 0.0352 | 0.00 | 0.000 | 0.000
6000 | 0.24 | -0.24 | -0.49 | 1.0010 | 0.0894 | 0.0371 | 0.00 | 0.000 | 0.000
8000 | 0.31 | -0.43 | -0.43 | 1.0000 | 0.0942 | 0.0337 | 0.00 | 0.000 | 0.000
10000 | 0.37 | -0.31 | -0.43 | 0.9961 | 0.0908 | 0.0371 | 0.00 | 0.000 | 0.000
12000 | 0.37 | -0.31 | -0.43 | 0.9961 | 0.0908 | 0.0371 | 0.00 | 0.000 | 0.000
14000 | 0.31 | -0.31 | -0.43 | 0.9966 | 0.0933 | 0.0342 | 0.00 | 0.000 | 0.000
16000 | 0.37 | -0.18 | -0.49 | 0.9990 | 0.0933 | 0.0342 | 0.00 | 0.000 | 0.000
18000 | 0.37 | -0.24 | -0.55 | 0.9980 | 0.0923 | 0.0356 | 0.00 | 0.000 | 0.000
20000 | 0.43 | -0.24 | -0.49 | 0.9976 | 0.0918 | 0.0356 | 0.00 | 0.000 | 0.000
22000 | 0.24 | -0.24 | -0.49 | 0.9951 | 0.0918 | 0.0361 | 0.00 | 0.000 | 0.000
24000 | 0.24 | -0.24 | -0.49 | 0.9976 | 0.0913 | 0.0347 | 0.00 | 0.000 | 0.000
26000 | 0.24 | -0.24 | -0.49 | 0.9976 | 0.0913 | 0.0347 | 0.00 | 0.000 | 0.000
28000 | 0.24 | -0.12 | -0.43 | 0.9961 | 0.0918 | 0.0356 | 0.00 | 0.000 | 0.000
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
