jjjay0826/rocket-system/doc/flightdata/20260605_drop_tests/IMU_20260605_1738.CSV

ts_us | gx_dps | gy_dps | gz_dps | ax_g | ay_g | az_g | baro_m | vz_ms | imu_hz_m
2000 | -0.06 | -0.24 | 0.24 | -0.0239 | -0.0342 | 0.9990 | 0.00 | 0.000 | 0.000
4000 | 0.00 | -0.24 | 0.18 | -0.0269 | -0.0352 | 0.9961 | 0.00 | 0.000 | 0.000
6000 | -0.06 | -0.24 | 0.18 | -0.0244 | -0.0308 | 0.9941 | 0.00 | 0.000 | 0.000
8000 | -0.06 | -0.18 | 0.24 | -0.0273 | -0.0303 | 0.9980 | 0.00 | 0.000 | 0.000
10000 | -0.06 | -0.18 | 0.24 | -0.0273 | -0.0303 | 0.9980 | 0.00 | 0.000 | 0.000
12000 | -0.12 | -0.24 | 0.18 | -0.0259 | -0.0312 | 0.9990 | 0.00 | 0.000 | 0.000
14000 | -0.06 | -0.24 | 0.18 | -0.0278 | -0.0327 | 0.9966 | 0.00 | 0.000 | 0.000
16000 | -0.06 | -0.24 | 0.24 | -0.0264 | -0.0342 | 0.9961 | 0.00 | 0.000 | 0.000
18000 | -0.06 | -0.12 | 0.24 | -0.0283 | -0.0347 | 0.9966 | 0.00 | 0.000 | 0.000
20000 | 0.00 | -0.18 | 0.24 | -0.0283 | -0.0322 | 0.9946 | 0.00 | 0.000 | 0.000
22000 | 0.00 | -0.18 | 0.24 | -0.0283 | -0.0322 | 0.9946 | 0.00 | 0.000 | 0.000
24000 | 0.00 | -0.12 | 0.24 | -0.0293 | -0.0312 | 0.9937 | 0.00 | 0.000 | 0.000
26000 | 0.00 | -0.12 | 0.12 | -0.0254 | -0.0400 | 0.9971 | 0.00 | 0.000 | 0.000
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
