jjjay0826/rocket-system/doc/flightdata/20260605_drop_tests/IMU_20260605_1743.CSV

ts_us | gx_dps | gy_dps | gz_dps | ax_g | ay_g | az_g | baro_m | vz_ms | imu_hz_m
2000 | 2.01 | -0.92 | 0.24 | -0.0474 | 0.0127 | 1.0908 | 0.00 | 0.000 | 0.000
4000 | 2.26 | -0.37 | 0.18 | -0.0488 | 0.0195 | 1.0679 | 0.00 | 0.000 | 0.000
6000 | 2.01 | -0.06 | 0.18 | -0.0508 | 0.0210 | 1.0459 | 0.00 | 0.000 | 0.000
8000 | 2.01 | -0.06 | 0.18 | -0.0508 | 0.0210 | 1.0459 | 0.00 | 0.000 | 0.000
10000 | 1.83 | 0.24 | 0.24 | -0.0562 | 0.0190 | 1.0347 | 0.00 | 0.000 | 0.000
12000 | 1.59 | 0.55 | 0.24 | -0.0537 | 0.0229 | 1.0059 | 0.00 | 0.000 | 0.000
14000 | 1.10 | 0.73 | 0.31 | -0.0518 | 0.0288 | 0.9893 | 0.00 | 0.000 | 0.000
16000 | 0.55 | 0.92 | 0.43 | -0.0454 | 0.0312 | 0.9849 | 0.00 | 0.000 | 0.000
18000 | -0.06 | 1.34 | 0.55 | -0.0449 | 0.0332 | 0.9761 | 0.00 | 0.000 | 0.000
20000 | -0.06 | 1.34 | 0.55 | -0.0449 | 0.0332 | 0.9761 | 0.00 | 0.000 | 0.000
22000 | -0.43 | 1.59 | 0.55 | -0.0425 | 0.0366 | 0.9580 | 0.00 | 0.000 | 0.000
24000 | -1.04 | 1.77 | 0.67 | -0.0415 | 0.0415 | 0.9453 | 0.00 | 0.000 | 0.000
26000 | -1.59 | 1.89 | 0.67 | -0.0342 | 0.0410 | 0.9531 | 0.00 | 0.000 | 0.000
28000 | -1.83 | 1.95 | 0.67 | -0.0332 | 0.0415 | 0.9517 | 0.00 | 0.000 | 0.000
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
