jjjay0826/rocket-system/doc/flightdata/20260605_drop_tests/IMU_20260606_1653.CSV

ts_us | gx_dps | gy_dps | gz_dps | ax_g | ay_g | az_g | baro_m | vz_ms | imu_hz_m | 氣壓推算速度
2000 | -0.12 | -0.31 | 0.18 | -0.0469 | 0.0049 | 0.9985 | 0 | 0 | 0
4000 | -0.12 | -0.31 | 0.12 | -0.0474 | 0.0024 | 1.0049 | 0 | 0 | 0
6000 | -0.06 | -0.37 | 0.24 | -0.0488 | 0.0054 | 0.9951 | 0 | 0 | 0
8000 | -0.06 | -0.37 | 0.24 | -0.0474 | 0.0024 | 0.9976 | 0 | 0 | 0
10000 | -0.06 | -0.37 | 0.24 | -0.0474 | 0.0024 | 0.9976 | 0 | 0 | 0
12000 | -0.06 | -0.24 | 0.18 | -0.0493 | -0.001 | 0.9985 | 0 | 0 | 0
14000 | -0.18 | -0.31 | 0.24 | -0.0498 | 0.002 | 0.998 | 0 | 0 | 0
16000 | -0.12 | -0.31 | 0.18 | -0.0483 | 0.0034 | 1.0005 | 0 | 0 | 0
18000 | -0.06 | -0.31 | 0.24 | -0.0479 | 0.0044 | 0.998 | 0 | 0 | 0
20000 | -0.06 | -0.24 | 0.18 | -0.0493 | -0.0005 | 0.9985 | 0 | 0 | 0
22000 | -0.06 | -0.24 | 0.18 | -0.0493 | -0.0005 | 0.9985 | 0 | 0 | 0
24000 | -0.12 | -0.24 | 0.12 | -0.0454 | -0.0015 | 0.9966 | 0 | 0 | 0
26000 | -0.12 | -0.24 | 0.12 | -0.0483 | 0.0005 | 0.9976 | 0 | 0 | 0
28000 | -0.12 | -0.37 | 0.12 | -0.0498 | 0.0005 | 1.001 | 0 | 0 | 0
30000 | -0.06 | -0.37 | 0.31 | -0.0522 | 0.0054 | 1.0005 | 0 | 0 | 0
32000 | -0.06 | -0.31 | 0.24 | -0.0513 | 0.002 | 1.0015 | 0 | 0 | 0
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
