jjjay0826/rocket-system/doc/known_issues.md

# 已知問題總表

> **這是「現在還有哪些沒修」的唯一清單。**
> [open_defects_20260801.md](open_defects_20260801.md) 是 2026-08-01 **發射前**的快照，
> 這份是**現況**。兩份說法不同時，以這份為準。
>
> 最後核對：**2026-10-07**，對照 `origin/main` 逐條確認。2026-10-09 更新 #5、新增 #29。2026-10-11 新增 #30、#31。2026-10-15 新增並結案 #32（8/1 影像對齊實測）。
> 韌體項目都在程式碼裡驗證過；硬體與回收系統的項目無法從程式碼驗證，依測試紀錄。

## 怎麼維護這份清單

- **修好一項 → 狀態改 ✅、寫上 commit，搬到最下面「已修好」**
- **編號固定，修好也不重編** —— 別處引用的「#12」才不會對錯號
- 新發現的問題接在最後面往下編
- 每一項都要有「是什麼」和「怎麼修」兩欄白話 —— 接手的人不一定懂這個領域

## 總覽

| | 數量 |
|---|---|
| 🔴 下次飛之前一定要處理 | 7 |
| 🟠 應該修 | 14 |
| 🟡 小問題 | 5 |
| ⚠ 需注意（目前不修） | 1 |
| ❓ 待確認 | 3 |

**如果只能先做三件事：#1、#2、#4。**前兩件是安全問題，第三件是 2026-08-01 失敗的根源。

---

## 🔴 下次飛之前一定要處理

| # | 是什麼 | 怎麼修 | 依據 |
|---|---|---|---|
| **1** | **8/1 之後的韌體修正都還沒燒進板子。**程式改好了，但只在電腦上編譯過；板子裡跑的可能還是舊版 —— 包括讓 ch2 主路徑失效的那個舊版。 | 兩塊板都重新燒錄，確認編譯沒有 `#warning`。桌上用 LED 代替電火頭，從 ARM 到開傘完整跑一次。 | [flight_161_summary.md](flight_161_summary.md)「有解，只是還沒做」。涉及 `22eb49b`、`f6f4c1d`、`0b1c66b`、`941b472`。**之後若已燒錄驗證，把這項改 ✅** |
| **2** | **發射台上可能誤點火，而且停不下來。**如果在台上被誤判「已發射」（搬動時甩到 2.5 g 持續 0.2 秒），5 秒後高度當然沒變 → 程式以為「氣壓計壞了」→ 拿掉備援 C 的 20 m 保險 → 第 18 秒在地上點火。這個判定是單向的，不會撤銷。 | 拿掉保險前多要一個證據：真的發射有好幾秒持續的大推力（8/1 推力段約 3 秒、峰值 5.7 g），搬動只會甩一下 —— 例如要求離架後 1 秒內的平均加速度夠大才算真的飛了。另加一個地面「取消」指令（要同步地面站並跑跨 repo 測試）。**修好之前，電火頭一定最後才接。** | `main.c` 的 `BARO_PROOF_MS`、`baro_untrusted`、`deploy_bkup`；flight_161_summary「pad misfire 路徑」 |
| **3** | **開傘只點一次，點完不檢查。**拉高 PA0+PA1 一秒就結束，不管傘有沒有真的出來。電火頭接觸不良、沒點著，板子也不會知道。 | 點火後 2~3 秒內看有沒有開傘衝擊（加速度尖峰）或下降變慢；都沒有就再點一次。最好接**第二顆獨立的電火頭** —— 第一顆如果已經燒斷，再對它通電沒有用。 | `main.c` 的 `deploy_fire_on()` 之後沒有確認邏輯。**此項先前沒有寫進任何文件** |
| **4** | **沒有轉環，傘一開火箭就跟著轉。**拖曳傘展開後，箭體被帶到 1166 °/s（每秒 3.2 圈），傘繩扭在一起，力量集中在少數幾條繩上，主傘結構失效。**這是 8/1 箭體沒回收的根本原因。** | 拖曳傘和主吊帶之間加一個能在 1.5 kN 下自由轉動的轉環。一個零件就能切斷整條失效鏈的起點。 | flight_161_summary 第二、七節；[parachute_failure_20260801.md](parachute_failure_20260801.md) |
| **5** | **主傘在太快的時候打開。**主傘直接跟著拖曳傘開，而拖曳傘的終端速度就是 31 m/s（8/1 實際在 39～41 m/s 開）。這種速度下全開，衝擊力估計約 **170～490 kgf**，超出目前驗證過的強度（見 #29）。降到 20 m/s 再開只要約 100～170 kgf。 | 改雙段式：拖曳傘先降到 20 m/s 以下，主傘延到 200~300 m 高度才開。或用收口傘（reefing）。 | flight_161_summary 第三、七節；`tools/opening_load.py` |
| **6** | **拖曳傘太小**，掉太快（32 m/s）。 | CdA 從約 0.44 m² 放大到約 1.1 m²（約 2.5 倍），才能降到 20 m/s。 | flight_161_summary 第七節 |
| **7** | **傘布補強算錯。**以為總力平均分給 8 條繩（每條 175 N），但自旋時全壓在少數幾條上。 | 按「單條繩承受總載荷的好幾倍」來設計，不是總載荷 ÷ 繩數。 | flight_161_summary 第七節 |

---

## 🟠 應該修

| # | 是什麼 | 怎麼修 | 依據 |
|---|---|---|---|
| **8** | **SD 卡 reset 後鎖死。**寫到一半被 reset（沒斷電），卡內部卡住，要整台斷電才會好。2026-07-20 加的四種軟體救法實測沒用。 | 下一版載板在 SD 的 VCC 加一顆 P-MOSFET，讓韌體能幫卡斷電重開。在那之前：SD 只當備份，飛行資料以 LoRa 為主；換卡前先斷電。 | open_defects C1；`sd_diskio_spi.c` 註解 |
| **9** | **SD 寫入最長卡 1.1 秒，開傘判斷也跟著停。**SD 寫入跟開傘狀態機在同一個主迴圈。 | SD 寫入改成背景分段（DMA 或拆小塊），或 LAUNCHED／DEPLOYING 期間暫停寫 SD、只送 LoRa。 | open_defects C3 |
| **10** | **LoRa 接收緩衝只夠 266 ms。**SD 卡住 1.1 秒時，地面送上來的指令（包括緊急開傘）可能整段被丟掉。 | 接收緩衝加大到超過 1.1 秒的量，或改用 UART DMA 接收。 | open_defects C4 |
| **11** | **指令只有一個暫存格。**連續送兩道指令，第二道會蓋掉第一道。 | 改成 4 格的小佇列。 | `cmd.c` 的 `cmd_pending`／`pending_cmd[]`；open_defects C5 |
| **12** | **沒有看門狗。**程式卡死（不是當機）時沒人把它叫醒。fault handler 已改成重開機，但無窮迴圈、等不到的 I/O 不在其中。 | 打開 IWDG，主迴圈定時餵。逾時要比 SD 最長阻塞（約 1.1 s）長，例如 2~3 s。重開機後的救援邏輯已經有了（`POSTRESET_*`）。 | 韌體裡沒有 `MX_IWDG_Init`／`HAL_IWDG_Refresh`；open_defects C2 |
| **13** | **GPS 上升段凍結。**座標凍結 17 秒、49 m，但全程報告 fix=1、24~25 顆衛星 —— 沒有任何訊號告訴你它壞了。模組規格最大加速度 4 g，實測 4.7 g（強假說，未證實）。 | 換耐更高 g 的 GPS；或燃燒結束後送一次冷啟動指令（ch1 空中重開機後 GPS 就恢復了）。地面站不要相信上升段的座標。 | flight_161_summary 第四節；[failure_analysis_20260801.md](failure_analysis_20260801.md) §1 |
| **14** | **氣壓計 SPI2 焊點怕震動。**室內正常、到室外一震就間歇讀不到（2026-07-20 C 板實測每分鐘 10~31%）。 | SPI2 四個焊點重焊、上熱熔膠。用手敲氣壓計，看 `MOD` 欄位會不會跳 —— 會跳就是焊點。 | 2026-07-20 地面測試紀錄 |
| **15** | **撞擊會讓電池接頭瞬間斷電。**投放測試曾在落地瞬間重開機，SD 寫到一半斷電、檔案系統損毀。 | 電池線焊死或熱熔膠灌死，不要用可插拔接頭。 | 投放測試紀錄（開機第 1 秒就是 2.8 g） |
| **16** | **重落地會把 SD 卡從卡槽彈出去。**push-push 卡槽被衝擊觸發退卡；有一次卡在寫入中斷電後直接報廢、資料救不回來。 | 用 Kapton 膠帶把卡封在槽裡；每次飛完當場拔卡備份，不要讓多次資料累積在同一張卡。 | 2026-07 重著陸事件 |
| **17** | **氣壓計氣孔被擋住，高度就不會動。**貼地、貼膠帶、手指靠近會有 ±1 m 級的假偏移；完全被封住時高度根本不變。 | 艙體開 ⌀3 mm 以上透氣孔，等待時手指遠離感測器。軟體已有保護（離架 5 秒高度沒爬過 10 m 就判定不可信），但它的副作用見 #2。 | 地面測試紀錄；`main.c` 的 `BARO_PROOF_MS` 註解 |
| **18** | **開傘通電時間 1 秒沒驗證過。**`DEPLOY_PULSE_MS` 在 2026-07-20 從 2000 改成 1000 ms，電火頭通電 1 秒是不是一定點得著，沒有實測過。 | 拿實際要用的電火頭、用電池實際電壓桌測幾次。不確定就改回 2 秒。 | `main.c` 的 `DEPLOY_PULSE_MS` |
| **19** | **回收系統三個量測從沒做過：**CO₂ 彈射只噴 50 cm（通則要 3~5 m）、減震繩有沒有彈性（載荷差 15 倍）、浮力少 7.7 kgf。箭體沒回收，所以這次永遠沒答案。 | 下一支火箭重新量：秤 CO₂ 瓶刺破前後的重量、拉減震繩看彈性、按實測質量算浮條數。 | open_defects B1／B3／B4 |
| **29** | **回收系統受力路徑的強度只驗證到 134.3 kgf。**傘繩固定方式是「金屬橫桿貫穿箭身＋限位器」，靜態拉力測試拉到 134.3 kgf 沒壞，但那是兩個人的體重上限，**不是破壞值**；8/1 飛行中撐過至少 156 kgf。而高速開傘的全開衝擊力估計可到 170～490 kgf（#5），**這個範圍從來沒有人測過**。另外：靜態拉 ≠ 開傘的 50～150 ms 衝擊；落下測試的「衝擊力」是用衝量÷時間算的平均值（還漏了重量），不是峰值。 | **拿備份的管子和桿子拉到破壞**（槓桿／手拉吊車／吊水桶），記下破壞值。動態峰值可以把航電板（`sandbox/parachute`，500 Hz、±16 g）綁在落下的重物上直接量。⚠ 斷裂瞬間繩子和金屬件會彈回：人不要站在繩子延長線上、繩上蓋厚毯、戴護目鏡。 | 隊上設計報告「傘繩固定方式與安全係數」；2026-06-22 落下測試紀錄；[parachute_failure_20260801.md](parachute_failure_20260801.md) 第 4 節 |
| **31** | **高頻資料只存在 SD 卡，SD 一出事就全沒了。**板上 IMU 100 Hz、氣壓 50 Hz，SD 以 50 Hz 記錄；但 LoRa 只送 2 Hz 的快照。原因是頻寬：文字格式的 50 Hz 約 9,000 B/s，而空中速率 9.6 kbps 扣掉開銷約 800 B/s，MCU→E22 的 UART 又只有 9600 baud（約 960 B/s）。8/1 的 SD 卡隨箭體沉海，自旋怎麼開始、兩次衝擊的真實峰值都永久遺失。 | **事件後補傳**：RAM 裡一直保留最近幾秒的高頻資料（F411 有 128 KB，留 6～10 KB 即可），偵測到頂點／開傘時把前後幾秒凍結起來，**在傘降期間用閒置頻寬慢慢傳回地面**。現在 2 Hz 封包只用掉約一半頻寬（還有約 400 B/s 空檔），8/1 傘降二十幾秒 ≈ 可補傳 8 KB ≈ 開傘前後 3 秒的 100 Hz 二進位 IMU 資料。補傳要用二進位格式並分段帶序號，地面站要能重組；不能佔用上行指令需要的空檔。峰值保持（`GAP`／`WP`，`941b472`）是同一思路的簡化版。 | `shared/lora_922_*.ini`（REG0=0x64：UART 9600、空中 9.6 kbps）；`941b472` 的頻寬實測（2 Hz × 174～191 B，餘裕 2.09～2.30 倍）；#8 |

---

## 🟡 小問題

| # | 是什麼 | 怎麼修 | 依據 |
|---|---|---|---|
| **20** | **韌體沒扣陀螺儀零偏。**開機的 IMU 校準只做姿態收斂，沒把靜止時的陀螺儀讀數當零點扣掉，積分會慢慢漂。（地面站的姿態顯示有扣，韌體沒有。） | 開機靜止時取 1~2 秒平均當零點，之後每筆都扣掉。 | `main.c` 的 IMU 校準區塊 |
| **21** | **GPS 高度和速度沒送進 LoRa。**有解析，但封包只有經緯度。 | 封包加欄位；同時改 `shared/protocol.h` 和地面站解析器，並跑跨 repo 測試。 | `shared/protocol.h` 的 `RKT_LORA_TX_FMT_GPS` |
| **23** | **`tools/fw_logic.py` 還是舊的開傘邏輯。**它的 cond_B 還讀卡爾曼速度 `kf2_v`，但韌體 8/7 已改讀純氣壓微分 `vz_baro_lp`。用它跑出來的開傘時間不代表現在的韌體。 | cond_B 改成「高度微分 → τ = 1 s 一階低通 → 低於 −0.5 m/s 持續 1.5 s」，跟 `main.c` 一致。 | `tools/fw_logic.py` |
| **24** | **跨 repo 協定測試沒有 CI。**測試住在地面站 repo、要手動跑；只改韌體的人不會知道它存在。 | 改封包格式或指令字串後一定要跑 `python tests/run_all.py`；長期可加 GitHub Actions。 | [README.md](README.md)「已知的倉庫問題」#3 |
| **25** | **LDO 板通電 7 秒短路；E28 發射功率只開 12 dBm。**LDO 板的短路一直沒找到原因；E28 是 27 dBm 等級的模組卻設在 12 dBm。 | LDO 板逐段斷開找短路點。E28 調高功率前，先確認比賽規則與法規上限（見 [e28_b_board_checklist.md](../firmware-rocket/doc/e28_b_board_checklist.md)）。 | open_defects B6／B7 |

---

## ⚠ 需注意（目前不修）

已知的風險，決定先不處理，但要知道它存在。

| # | 是什麼 | 如果要修 | 依據 |
|---|---|---|---|
| **30** | **通訊沒有加密，上行指令也沒有身分驗證。**下行遙測是明文 ASCII，同頻道的模組都收得到；E22 的金鑰暫存器是 `00 00`（未設定），位址與網路 ID 也是預設值。上行指令是固定字串，而且寫在這個**公開** repo 裡；ARM 的通關碼由開機毫秒數產生，並以明文回傳。另外，飛行中受理遠端開傘的條件是「離架 10 秒後」，比韌體註解寫的原意（頂點之後）早。遙測被看到不要緊；**真正要在意的是開傘指令能不能被冒用**。 | 由簡到完整：① 指令字串移出公開 repo（放不進版控的設定檔，repo 只留範本）並**全部更換** —— 舊的已永久留在 git 歷史裡 ② 遠端開傘的受理條件改成「偵測到頂點之後」 ③ 設定 E22 金鑰／位址／網路 ID（只能擋預設設定的模組，不算真正加密） ④ 完整做法：挑戰—回應式的訊息驗證（例如 HMAC-SHA256，金鑰只存在兩端）加防重放。重點是**驗證**指令來源，不是把內容藏起來。注意 STM32F411 沒有硬體亂數產生器，亂數要另外取（ADC 雜訊、計時器抖動）。此頻段不是業餘無線電頻段，不受「不得加密」的限制（見競賽合規紀錄）。 | `main.c` 的上行指令處理與 `manual_arm_code`；`shared/lora_922_*.ini` |

---

## ❓ 待確認

| # | 問題 | 為什麼重要 | 怎麼確認 |
|---|---|---|---|
| **26** | **8/1 飛的是哪一版韌體？** | 從遙測反推的卡爾曼增益 K1 比原始碼小 10 倍，飛上去的可能不是 repo 裡那一版。 | 在 git 歷史裡找 K1 是那個值的版本。 |
| **27** | **2026-07-20 地面測試的 4 次 `NRST-PIN` 重開機，是有人按的嗎？** | 如果沒人按，就是 NRST 線有硬體問題 —— 飛行中自己重開機是災難級。 | 問當天在場的人；沒人按的話，量 NRST 線、檢查重置電路。 |
| **28** | **航電板用的是哪一罐助焊劑？** | 酸性助焊劑（氯化鋅＋鹽酸）的殘留會吸濕，跟「室內好、室外壞」完全吻合。 | 問焊板的人；如果用了，用 IPA 清洗並目視檢查 SPI2 焊點有無腐蝕。 |

---

## ✅ 已修好（留著當教訓）

| # | 是什麼 | 怎麼修的 | commit |
|---|---|---|---|
| **22** | 文件把 ch1 開傘寫成「頂點後 1.5 秒」—— 拿 ch1 時鐘的開傘時刻減 ch2 時鐘的頂點 | 用同一塊板自己的時鐘重算：1.6~2.1 s。六處一起更正 | 與本檔同一個 commit |
| **32** | 8/1 直播影像和遙測的時間對齊從來沒驗證過；repo 裡兩種說法互相矛盾，「傘張最開與第二筆大載荷吻合 30 ms」靠的就是它 | 2026-10-15 在直播存檔上實測：箭開始動在直播 21293.13 s，加上 2.5 g 上升、20 筆判定與等封包，遙測 T+0 ＝ 直播 21293.48 ± 0.07 s；畫面上電視台時鐘兩次跳秒相隔 18.99 s，證明中間沒掉幀。舊的影像列與實測差 ≤ 0.05 s，維持；「30 ms」改為「± 0.1 s 內一致」，結論不變 | 與本列同一個 commit；[parachute_failure_20260801.md](parachute_failure_20260801.md) 第 0.1 節 |
| — | 文件說「ch1 比 ch2 晚 0.49 s 判定離架」—— 其實是 ch1 離架時掉了兩包，第一個 `ST:1` 晚一包出現；頂點寫成最近一包的 14.50；ch2 備援點火寫成整數 18.00；ch2 的 1010 ms 跳拍被當成巧合 | 寫了 `tools/verify_timeline_0801.py` 從原始 log 逐列重算：0.49 s 改為掉包＋量化；頂點 ≈14.35（雙板擬合）；ch2 點火 17.5～18.0（推算 ≈17.93）；跳拍是 ch2 點火時阻塞送出開傘訊息造成的。影像對齊見 #32 | 與本列同一個 commit |
| — | 姿態濾波把任何加速度都當成重力 → ch2 速度估計錯，cond_B 失效 | 只有 0.85~1.15 g 才拿加速度修正姿態；cond_B 改讀純氣壓微分 | `0b1c66b`（投放測試韌體 `5c5cec1`） |
| — | 封包只送 2 Hz 那一瞬間的值，開傘衝擊（50~150 ms）幾乎一定漏掉 | 加峰值保持：`GAP`（合加速度）、`WP`（合角速度） | `941b472`；地面站 `f169b2d` |
| — | 4 個字串被換行切斷，HEAD 編譯不過 | 修復 | `f6f4c1d` |
| — | 三個編譯開關描述了根本沒焊的硬體（其中 `/setch` 會讓 GPIO 短路到地 82 mA） | 全部關閉 | `22eb49b` |
| — | 氣孔被封時，三條自動開傘路徑同時失效 | 離架 5 秒高度沒爬過 10 m → 判定氣壓計不可信，備援退回純計時（副作用見 #2） | `d483e54` |
| — | PB6 手動點火鈕沒有任何保護，拉低 50 ms 就點火 | 加三道閘門：IDLE＋已 ARM＋地面測試模式 | 2026-07-31 |
| — | 搬運時甩一下（1.3 g）就被判定為發射 | 離架門檻改 2.5 g | `27cb79a` |
| — | LoRa 上行指令 100% 收不到（收到一半的行被丟掉） | 加跨呼叫的行累積緩衝 | `27cb79a` |
| — | LoRa 沒裝模組也回報「發送成功」 | 讀 AUX 腳確認模組真的在 | 2026-07-20 |
| — | GPS 失去定位時座標亂跳（`strtok` 吃掉空欄位） | 自寫 `nmea_split` 保留空欄位 | `7a33d25` |
| — | SD 初始化卡死（`wait_ready` 擋住 CMD0；回傳值跟「卡沒回應」一模一樣，誤導排查好幾天） | CMD0 改成特例直接送 | 2026-07-01 |
| — | SD 寫出的 CSV 亂碼 | 資料段 SPI 降到 656 kHz | `7a33d25` |
| — | 地面站：一個 KH 突波讓顯示的頂點永遠虛高 | 修正 | 地面站 `5ecc23f` |
| — | 地面站：遙測 CSV 會以三種方式默默掉資料 | 修正 | 地面站 `d33058e` |
| — | 地面站：沒有 GPS 時自己編座標 | 修正 | 地面站 `5225ab1` |
| — | 地面站：上行指令 token 沒有測試，其中一個根本送不出去 | 加跨 repo 測試 | 地面站 `9d06dab` |
| — | 地面站：`settings.json` 是機器專屬卻入庫 | 改 gitignore，留範本 | 地面站 `6bb9c0d` |
| — | 某塊黑丸版燒錄必敗 | 寫入保護（WRP）被全鎖。CubeProgrammer 的勾選是反邏輯：**沒勾＝鎖定** | 硬體 |
| — | B 板 SPI 三條線被鉗位，感測器全死 | 兇手是燒壞的 BMP585，換掉就好 | 硬體 |
