jjjay0826/rocket-system/doc/history/README.md

# doc/history/ — 已被取代的設計，留著追溯演進

這裡的東西**都不是現況**，引用前先對照現行文件。

| 檔案 | 原始檔名 | 日期 | 是什麼 | 現況看哪 |
|---|---|---|---|---|
| `deploy_logic_v1.5_2026-02-06.png` | `降落傘1.5.png` | 2026-02-06（圖上標註） | 早期開傘邏輯 v1.5 | `firmware-rocket/Core/Src/main.c` 檔頭的「開傘觸發條件」 |
| `fmea_2025-11_en.csv` | `avionics_fmea_with_solutions.csv` | 2025-11-17 | 航電 FMEA（英文，含改善措施） | [`../known_issues.md`](../known_issues.md) |
| `fmea_2025-11_zh.csv` | `火箭航電FMEA_繁體中文.csv` | 2025-11-17 | 同上的繁體中文版 | 同上 |

## 開傘邏輯是怎麼演變的

v1.5（2026-02）的設計：

| 條件 | v1.5 的判據 | 角色 |
|---|---|---|
| A | 21 s < T < 23 s（時間在安全區間） | 主判斷 |
| B | 卡爾曼濾波後的氣壓高度 ≤ 850 m | 主判斷 |
| C | 加速度由正轉負並持續 | 輔助（視測試結果決定要不要用） |
| D | T > 25 s | 強制開傘 |

到 2026-08-01 實飛時已經改成 **(A ∧ B) ∨ C**：
A＝氣壓高度比最高點低 10 m、B＝垂直速度持續向下 1.5 s、C＝離架後 18 s 備援。
（B 在 8/1 用的是卡爾曼速度，那正是 ch2 主路徑失效的原因；8/7 才改成純氣壓微分。）

兩個主要改變：

- **高度門檻從「絕對值 850 m」改成「比最高點低 10 m」** —— 不管實際飛多高都成立，
  不必事先猜頂點高度
- **不再靠加速度判斷頂點** —— 滑行段加速度計只量到約 0.06 g，判斷不了方向
  （見 [`../flight_161_summary.md`](../flight_161_summary.md) 與
  [`../known_issues.md`](../known_issues.md)「已修好」裡姿態濾波那一條）

## FMEA

2025-11 寫的，**早於現行硬體**（現行的載板與 900 MHz LoRa 是 2026 年才定案）。
「負責人」欄只有職稱。RPN 分數和元件清單引用前要對照現況。

`SHA256SUMS` 是收進來時算的雜湊值。
