jjjay0826/rocket-system/doc/parachute_failure_20260801.md

# 2026-08-01 旭海 · 主傘失效原因分析

**結論先講 —— 這是一條因果鏈，不是單一原因：**

```
拖曳傘展開時把整個箭體帶動自旋（實測 1166 °/s = 3.2 轉/秒）
        ↓
主傘在自旋中充氣，傘繩扭轉，載荷【不再平均分給 8 條線】而集中到少數幾條
        ↓
受力最大的那條所在的傘布結構失效（撕裂）
        ↓
主傘永久失去阻力，成為飄帶。終端阻力 = 只剩拖曳傘
```

**自旋是量到的**（兩塊獨立航電板，不是推論）。**撕裂是推論**，但由兩條獨立證據
支持：扭轉在 T+22 就鬆開了而傘卻永遠沒恢復阻力（→ 損傷是永久的），以及終端
阻力精確等於「只有拖曳傘」（→ 主傘貢獻字面上的零）。

另外還存在一個**與這條鏈無關的獨立設計問題**：這副主傘「直接跟著拖曳傘開」時的
開傘速度（31～41 m/s），全開衝擊力估計約 170～490 kgf，**超出目前驗證過的範圍**
（固定結構靜態拉到 134.3 kgf 未壞；飛行中撐過至少 156 kgf 的拖曳傘衝擊）。見第 4 節。

證據全部來自兩塊獨立航電板的 2 Hz 遙測 ＋ TASA 直播存檔的 59.94 fps 影像。
箭體未回收（僅尋回鼻錐），無實體佐證。

---

## 0　時間軸基準

本文一律用 **ch2 的 t_rel**：ch2 時鐘減去 ch2 **第一個 `ST:1` 封包**（`T7464588`）。
ch1 用地面站 log 的 UTC 前綴換算過來（不是擬合）；每包的換算散佈只有 ±10 ms，
兩板的取樣點因此穩定相差 30 ms。

[`tools/verify_timeline_0801.py`](../tools/verify_timeline_0801.py) 從原始 log 重算本節與第 1 節的每一列。

> **★2026-10-15 更正**：本節原本寫「兩塊板各以自己判定離架為 t=0，**ch1 比 ch2 晚 0.49 s 判定**」。
> 那不是判定延遲。`parse_raw_lora.py` 的 t=0 是「第一個 `ST:1` 封包」，
> 而 ch1 在離架那一刻**掉了兩包**（SQ14170、14171），第一個 `ST:1` 因此晚一包才出現。
> 0.49 s ＝ 掉包＋2 Hz 量化。兩板真正的判定時刻都只框得到 0.5～1 s 內，看不出誰早誰晚。
> 換算本身一直是用 UTC，所以時間軸上的數字不受影響。

**T+0 不是離架瞬間**，它比箭真正開始動晚約 0.35 s（下面實測）。

### 0.1　影像與遙測的對齊（2026-10-15 實測）

舊文件沒記錄影像是怎麼對到遙測的，repo 裡還留著兩種互相矛盾的說法
（`build_viewer.py`「片段第一幀＝離架」、`grab_yt_frames.py`「點火閃光對 16:57:44.088」，
後者那個時戳其實是 ch1 點火**前**最後一包的收包時間）。2026-10-15 直接在直播存檔上重量：

| 量什麼 | 直播時間軸（秒） | 怎麼量的 |
|---|---|---|
| 箭開始動 | **21293.13**（21293.122 那幀仍靜止，21293.139 動了 1 px） | 逐幀追蹤箭頭像素位置；之後位移 1, 2, 4, 9, 17, 28 … px 呈拋物線 |
| 合加速度過 2.5 g | ＋0.03～0.07 | 由位移的二次差分：前 3 幀加速度還沒到穩定值 |
| 韌體判定離架 | ＋0.19～0.20 | `total_g ≥ 2.5` 連續 20 筆＠100 Hz（`b0ad361` 的 `main.c`） |
| ch2 第一個 `ST:1` 封包（T+0） | ＋0.07～0.15 | 該包 KF 速度只有 3.78 m/s（≈ 0.11～0.15 s 的積分）；ch2 跳拍推算給 0.07 |
| **⇒ T+0 對應直播時間** | **21293.48 ± 0.07** | 以上相加 |
| 檢查：畫面上的電視台時鐘 | 16:57:19→20 在 21292.922～.938；16:57:38→39 在 21311.907～.924 | 兩次跳秒相隔 18.99 ± 0.02 s ⇒ **離架到開傘之間影片沒有掉幀** |

所以 **影片事件的 T+ ＝ 直播秒數 − 21293.48（± 0.07 s）**。
用這個換算，主傘在直播上的過程是：21311.47～.54 還沒張開、呈細長條（T+17.99～18.06；
顏色與之後攤開的主傘相同）、21311.64～.79 縮成一小團開始鼓起（T+18.16～18.31）、
21311.84～21312.04 攤開到最大（**T+18.36～18.56**）、21312.49 起已成長條（T+19.0）。
下表的影像列（18.22／18.49／18.99…）和這組獨立重量的結果差在 0.05 s 以內，**維持不變**。

量測方式：YouTube 不讓未登入的下載器讀到片段所在的位置（HTTP 403），
改在瀏覽器裡用播放器本身逐幀定位（`requestVideoFrameCallback` 取每幀的 `mediaTime`）
再擷取畫面比對。直播存檔 `youtube.com/watch?v=ogR7rgce_ps`，直播時間 21293 s ＝ 5:54:53。

---

## 1　事件序列

| ch2 T+ | 事件 | 量測來源 |
|---|---|---|
| ≈14.35 | 頂點 833.7 m，水平速度 39.2 m/s | 雙板 RH 拋物線擬合（ch1 14.38／ch2 14.33）；最高的一包在 14.50 |
| **16.0～16.5** | **ch1 開傘點火（A∧B）**。ch2 此時 cond_A 也已成立，但 cond_B 沒有 → **ch2 沒點火**。GA 0.07 g，滾轉 +17 °/s | ch1 的 `MSG ... auto A+B`；時間落在 ch1 `ST:1`（頂點後 +1.61 s）與 `ST:2`（+2.11 s）兩包之間 |
| 16.50 | 阻力開始上升 GA 0.22/0.13 g（ch2/ch1，下同）。滾轉仍 +15 °/s | 雙板 |
| **17.00** | **滾轉開始暴增 +68 / +50 °/s**。GA 才 0.41/0.92 g | 雙板 |
| 17.50 | 滾轉**反向** −115 / −100 °/s。開始出現橫向擺盪 | 雙板 |
| 17.5～18.0（推算 ≈17.93） | ch2 備援 C 點火（判定離架後 18 s） | ch2 的 `MSG ... backup timer T>18s` 在 `ST:1`（17.50）那包之後；判定離架 ≤ T+0 → 點火 ≤ 18.00。≈17.93 見下方「ch2 跳拍」 |
| **18.04** | **拖曳傘開傘衝擊 6.14 g = 1.53 kN**。滾轉 −464 °/s | ch1 |
| 18.22 | 影像：圓傘開始張開，491 px，長寬比 0.83 | 影片 |
| 18.35 | 影像：1910 px，長寬比 0.74 | 影片 |
| **18.49** | **影像：峰值 3443 px，長寬比 0.91（接近正圓）** | 影片 |
| **18.52** | **主傘衝擊 5.62 g = 1.40 kN。滾轉 +992 °/s（再次反向）** | ch2 |
| 18.65 | 影像：930 px，長寬比 0.66 —— 開始塌陷 | 影片 |
| 18.99 | 影像：2382 px，長寬比 **2.16** —— 已成長條 | 影片 |
| 19.02 | 影像：2202 px，長寬比 **3.06** | 影片 |
| 19.0→22.0 | 滾轉 885 → 54 °/s 衰竭 | ch2 |
| 22→43.6 | 穩定下降 **32.1 m/s**，25 秒內傘形完全未恢復 | 雙板＋影片 |

**兩塊板各錄到一筆大載荷，相隔 0.48 s。**ch1 在 18.04 讀到 6.14 g 後就失聯；
ch2 在 17.50 之後到 18.51 之間沒有封包，所以只有它錄到後面那筆。

**ch2 那 1010 ms 的空檔不是巧合，是它自己點火造成的**（2026-10-15 查韌體確認）：
點火時 `LoRa_Send` 以阻塞方式送出開傘訊息（74 B，9600 baud ≈ 77 ms），主迴圈停住；
恢復後那一圈遇到 E22 還在發射，當期遙測被跳過，下一包因此晚了 10 ms、離開 500 ms 格點。
由此反推 ch2 點火約在 **T+17.93**。這是依 `b0ad361`（8/1 當天 commit）的程式碼推算的，
而飛上去的版本仍有疑問（[known_issues.md](known_issues.md) #26）。

兩筆都 ≥ 5.6 g，而開傘衝擊約 100 ms 就衰減，所以最可能是**兩次衝擊**。
但 2 Hz 取樣分不出「兩次衝擊」和「一段持續 ≥ 0.5 s 的大載荷」。

**影像獨立支持「第二筆是主傘」**：對齊經 2026-10-15 實測（第 0.1 節），
ch2 那一筆（T+18.51）落在影像上主傘攤到最大的區間（T+18.36～18.56）裡；
ch1 那一筆（T+18.03）對應直播 21311.51，畫面上主傘還沒張開、呈細長條
（顏色與之後攤開的主傘相同），與「傘繩拉直時的衝擊」一致。

> **★2026-10-15 修正**：本段原本寫影像峰值與 ch2 第二次衝擊「吻合到 30 ms」。
> 對齊本身的誤差就有 ± 0.07 s，2 Hz 取樣又只知道 ch2 那一筆的時刻、不知道真正的峰值，
> 所以能說的是「**在 ± 0.1 s 內一致**」，不是 30 ms。

---

## 2　核心證據：滾轉

### 2.1　軸向確認

推力段 `ax = −5.65 g`、`ay ≈ az ≈ 0`，所以 **X 是箭體長軸，gx 就是滾轉率**。

兩塊板在點火前都讀到 `gx = +17 °/s`（同號同量值），證明兩板的 X 軸定義一致，
後續的**正負號比較是有意義的**。

### 2.2　滾轉率歷程

| ch2 T+ | ch1 gx | ch2 gx | 橫向 (gy,gz) |
|---|---|---|---|
| 16.50 | +15.5 | +15.4 | 小 |
| 17.00 | **+49.8** | **+67.7** | 7 / 15 —— **純滾轉，不是翻滾** |
| 17.50 | **−100.0** | **−114.7** | 110 / 110 —— 開始擺盪 |
| 18.04 | **−463.9** | （跳拍） | 524 |
| 18.52 | （已失聯） | **+991.5** | 612 |
| 19.01 | — | +881.2 | 71 |
| 20.51 | — | −194.8 | 90 |
| 21.01 | — | +224.1 | 62 |

三點必須看清楚：

**① 滾轉在任何大載荷之前就開始了。**T+17.00 滾轉已達 50–68 °/s，
但 GA 只有 0.41/0.92 g。所以**不是開傘衝擊造成旋轉，是旋轉先於開傘**。

**② 是純滾轉，不是箭體翻滾。**T+17.00 的橫向角速度只有滾轉的 1/5～1/7。
翻滾會表現在 gy/gz，這裡沒有。所以扭矩是繞長軸的，來源是**已放出的回收系統
硬體**，不是箭體氣動失穩。

**③ 方向反覆反轉。**+17 → +68 → −115 → −464 → **+992** → +881 → −195 → +224。
穩定自旋不會這樣。**方向交替 ＋ 峰值 1166 °/s（3.2 轉/秒）＝ 懸吊系統變成了
一個扭轉振盪器** —— 傘繩被扭緊、儲能、反彈、再往另一邊扭緊。

> **不能宣稱的事**：累積扭轉圈數。2 Hz 取樣一個方向會在半秒內翻轉的訊號，
> 積分出來的數字沒有意義。可以確定的只有**瞬時峰值 1166 °/s** 和**方向反轉**
> ——這兩者都是單點瞬時讀數，不受取樣率影響。

---

## 3　為什麼判定終點是「結構失效」而不只是「可逆的扭轉束口」

自旋本身是量到的，沒有爭議。問題是它導致的終局是**可逆的束口（squidding）**
還是**不可逆的結構破壞**。兩條獨立證據指向後者。

### 3.1　扭轉鬆開了，傘卻沒有回來

| ch2 T+ | 滾轉率 | 說明 |
|---|---|---|
| 19.01 | 885 °/s | 主傘充氣後 |
| 20.51 | −215 | |
| 22.02 | −54 | |
| 22.5 以後 | ±20～150 交替 | **正常的鐘擺擺盪，不是持續扭轉** |

**到 T+22 扭轉已經解掉了。**但 T+22～43.6 的下降率完全平直，維持 32 m/s，
21 秒內沒有任何恢復跡象。

被扭轉束住的傘，扭轉一鬆就會恢復部分阻力 —— **它沒有。所以損傷是永久的。**

### 3.2　終端阻力精確等於「只有拖曳傘」

```
穩定下降段（T+24~43.6，40 點最小平方）
  下降率           ch1 32.09 ／ ch2 31.60 m/s（擬合，兩板差 1.5%）
  終端 CdA         約 0.44 m²
  主傘設計 10.4 m² →  4.5%
  若全部來自十字拖曳傘 (Cd=0.65)：等效布面 0.81 m 見方
```

0.81 m 見方正是一副合理的拖曳傘尺寸。被束口的傘通常仍有滿開的 10～30%，
**主傘貢獻的是字面上的零**。

### 3.3　為什麼「載荷太低不足以撕裂」這個反駁不成立

峰值量到 1.40 kN，而一副 10.4 m² 傘的 8 條繩合計額定**一般**約 8～20 kN
（這是常見傘繩的典型值，**不是我們實際用的繩子的額定 —— 那個數字至今未知**）。
乍看差一個數量級，撕不動。但這個論證有兩個漏洞，第二個是致命的：

1. **1.40 kN 是 2 Hz 取樣的下限。**開傘衝擊只有 50～150 ms 寬，
   500 ms 取樣抓到的是峰值的一部分。
2. **★ 傘在 1000 °/s 自旋、傘繩正在扭轉時，載荷不會平均分給 8 條線。**
   扭轉與不對稱充氣會把載荷集中到少數幾條上。平均看來撐得住的載荷，
   單條可以是平均的數倍。

換句話說：**陀螺儀資料不是在反駁撕裂，是在解釋撕裂為什麼會發生。**
它說明了為什麼「總載荷不高」的情況下仍會有單點結構失效。

### 3.4　影像能講與不能講的

用 59.94 fps 原生幀做了三個量化測試：

| 測試 | 方法 | 結果 |
|---|---|---|
| 布團中央的洞是天空還是傘腔陰影 | 洞內 RGB vs 同幀同高度的乾淨天空 | **是天空**，亮度比 0.99～1.07。T+18.503 起持續存在，四周由布料完全包圍 |
| 上方大物體會不會愈離愈遠 | 以主體質心為原點（自動扣掉搖鏡） | **不會**，距離拉到約 130 px 後穩定 → 由繩索連著。那是**拖曳傘**，不是碎片 |
| 右側小物體是否脫離 | 最近鄰關聯追蹤 | **無法判定**。2～3 幀後關聯失效 |

「被布料包圍的天空色開口」與撕裂一致，但**摺疊的傘衣在投影上完全一樣**，
所以它單獨不能定案。

**碎塊追蹤在這段影片上做不到。**傘衣只有約 80 px，候選碎塊 10～30 px，
H.264 在這個位元率下把它們吃掉了。不要基於這段影片宣稱「看到布片飛走」。

### 3.5　主傘從未在氣動意義上完全張開

影像上傘布在 T+18.486 攤得最開（3443 px，長寬比 0.93），
但**那不等於充飽**：

若那一刻（約 39 m/s）主傘的阻力面積已經是全開的 10.4 m²，拉力會是 **8.8 kN = 35 g**。
ch2 在影像峰值後 **25 ms** 取樣，讀到 5.62 g。開傘衝擊的衰減時間約 100 ms，
所以「25 ms 前存在 35 g 峰值」不成立。

**那一刻主傘的有效阻力面積只有全開的約 15%**（1.40 kN ÷ 動壓 844 Pa ≈ 1.7 m²）。

> 2026-10-15：「25 ms」依賴影像與遙測的對齊。實測對齊誤差 ± 0.07 s（第 0.1 節），
> 所以應讀作「ch2 那一筆落在傘攤最開的 ± 0.1 s 內」。15% 是那一筆純遙測算的，成立；
> 「沒有 35 g」的結論在 ± 0.1 s 內仍成立，因為那段時間傘都還是攤開的狀態。

影像上從第一次看得到傘衣（T+18.22）到攤得最開（T+18.49）約 **0.27 s**
（這是影片內兩幀的時間差，不受對齊影響）。
這是目前唯一的「張開時間」實測，但傘當時在自旋中、只張開一部分，只能當量級參考。

這不但不牴觸撕裂，反而更合理：**一副只張開一部分、又在自旋的傘，
正是載荷最容易集中到少數幾條繩上的狀態。**布攤開了，但沒充飽，
受力全落在幾個角上。

---

## 4　★ 第二個問題：設計本身

這個和扭轉**完全獨立**，就算沒有扭轉也會發生。

主傘滿開的設計下降率是 `sqrt(2mg/(ρ·CdA)) = 6.4 m/s`，很理想。
但**開傘時的載荷取決於開傘瞬間的速度，以及傘張開要花多久**。

> **★2026-10-09 更正**：本節原本只列「瞬間全開」的載荷（39 m/s → 8.8 kN），
> 並據此寫「結構不可能承受」「會直接拉爆箭身」。那是**沒有根據的推論**：
> 從來沒有做過結構強度分析，而且瞬間全開是**上限**（假設傘瞬間張開、火箭完全沒減速）。
> 下表改用 [`tools/opening_load.py`](../tools/opening_load.py) 的動態模型重算，
> 並與實際驗證過的強度比較。

全開時繩子的峰值拉力（kgf；主傘 CdA 10.4 m²、箭體 25.36 kg、面積在 tf 秒內線性長到全開）：

| 開傘速度 | 瞬間全開（上限） | tf = 0.1 s | 0.2 s | 0.4 s |
|---|---|---|---|---|
| **39～41 m/s**（本次實際） | 895～989 | 454～488 | 327～351 | 236～253 |
| **31 m/s**（拖曳傘終端） | 565 | 327 | 237 | 173 |
| 25 m/s | 368 | 241 | 176 | 130 |
| 20 m/s | 235 | 173 | 132 | 99 |
| 15 m/s | 132 | 111 | 92 | 72 |

- 張開時間 tf 是最敏感的參數。8/1 影片量到的攤開時間約 0.27 s（見 3.5，只能當量級參考）
- 模型**沒有**算進繩子繃緊瞬間的衝擊與傘衣過度充氣，設計時建議再乘 1.2～1.5
- 改用 OpenRocket 模型裡的傘（3.08 m、Cd 1.3 → 9.7 m²）結果低約 5%。
  ⚠ **那份模型沒有拖曳傘**，與實飛的回收配置不同

**實際驗證過的強度：**

| | 載荷 | 來源 |
|---|---|---|
| 傘繩固定結構（金屬橫桿貫穿箭身＋限位器）**靜態**拉力測試 | **134.3 kgf 未壞**（受限於兩人體重，非破壞值） | 隊上 2026 設計報告「傘繩固定方式與安全係數」 |
| 8/1 飛行中實際承受（若為同一結構） | 拖曳傘衝擊 **≥ 156 kgf**（1.53 kN）、主傘衝擊 **≥ 143 kgf**（1.40 kN），皆為 2 Hz 下限 | 本文第 1 節；箭體到落海前都還掛著拖曳傘 |
| 31 m/s 以上全開 | **未驗證** | —— |

所以結論是：主傘設計成「直接跟著拖曳傘」，開傘速度落在 31～41 m/s，
**全開衝擊力（約 170～490 kgf）超出目前驗證過的範圍**。會不會壞**不知道** ——
不是「一定扛不住」，而是**沒有人測過**。要知道答案，見
[known_issues.md](known_issues.md) #29（拉到破壞的測試方法）。

扭轉讓主傘只張開一部分，因此 8/1 主傘的實際載荷只有約 143 kgf（下限）。

---

## 5　無法確定的事

誠實列出，不要在簡報裡宣稱：

| 問題 | 為什麼無解 |
|---|---|
| 扭矩的源頭（十字傘固有旋轉？倒飛的尾翼？傘袋抽出？） | 三者都能產生繞長軸的扭矩，2 Hz 遙測分不出來 |
| 累積扭轉圈數 | 取樣率不足，方向又會反轉 |
| **破壞的確切形式**（傘布撕裂？補強帶脫開？單條繩斷？） | 未回收；影像解析度不足以追蹤碎塊 |
| **哪一條繩先失效、破口從哪個角開始** | 同上 |
| 有無布片真的脫離 | 影像最近鄰追蹤 2～3 幀後即失效 |
| 開傘衝擊真峰值 | 2 Hz 取樣，1.53 kN 是**下限** |
| 回收系統受力路徑的破壞強度 | 只做過靜態拉到 134.3 kgf（未壞），從沒拉到破壞 |
| 是否裝有轉環、是否失效 | 未回收 |

**可以講的是「結構失效導致永久喪失阻力」，不能講的是「傘布被撕成幾片、
破口從哪個角開始」。**後者需要實體傘衣。

不過第一項有一個可用的推論：**航電板本身（裝在箭身裡）錄到了 3.2 轉/秒。**
如果拖曳傘與吊帶之間有有效的轉環，箭身不會跟著轉。所以**要嘛沒裝轉環，
要嘛轉環卡死或規格不足**。

---

## 6　修正方向

按優先序：

1. **拖曳傘與主吊帶之間加轉環**，規格要能在 1.5 kN 載荷下自由旋轉。
   這是整條因果鏈的**起點**，也是唯一可以用一個零件擋掉的環節 ——
   沒有自旋就沒有載荷集中，沒有載荷集中就沒有單點結構失效。
2. **主傘不可以直接跟著拖曳傘。**兩種做法擇一：
   - **雙段式**：拖曳傘先降到 ≤20 m/s，主傘延遲到 200–300 m 再開
   - **收口（reefing）**：主傘先以縮口狀態張開，數秒後解除
   本次的設計兩者都沒有。
3. **拖曳傘偏小。**約 0.44 m² 的 CdA 給 25.4 kg 得到 32 m/s。
   要降到 20 m/s 需要約 **1.1 m²**（約 2.5 倍）。
3b. **檢討傘衣的補強配置。**既然失效是載荷集中造成的單點破壞，
   下一副傘的傘繩接點、補強帶、傘裙帶就必須按「單條繩承受總載荷的
   數倍」來設計，而不是按「總載荷 ÷ 繩數」。這是這次最直接的設計教訓。
4. **提高遙測取樣率或至少對衝擊事件做峰值保持。**本次兩次衝擊各只有一塊板
   錄到，純屬運氣。加速規的峰值保持暫存器成本近乎為零。
5. 陀螺儀滾轉率是**極便宜且極有效的回收系統健康指標**。
   在遙測封包裡直接送出 `|w|`，飛行中就看得出扭轉。

---

## 附：本文所有數字的來源

| 數字 | 來源 |
|---|---|
| 質量 25.36 kg | 實測起飛 29.999 − 推進劑 4.64（TASA_Pioneer_5K.eng），另有兩條獨立驗證鏈 |
| 頂點水平速度 39.2 m/s | 滑行段 T+6~14.5 由 GA 與氣壓 vz 聯立解出 k 與 vx，頂點 GA 檢核吻合到 0.00 g |
| 開傘速度 41–43 m/s | 氣壓高度差分 ＋ 上述水平分量 |
| 載荷 1.53 / 1.40 kN | GA × 25.36 kg × g，**2 Hz 取樣故為下限** |
| 終端 CdA 約 0.44 m² | `tools/flight_report.py` 的最小平方下降率 ＋ 標準大氣密度 |
| 傘衣像素／長寬比 | 59.94 fps 原生幀，天空二次曲面擬合扣除後的色度通道 |
| 滾轉率 | LSM6DS3 陀螺，兩板獨立，事件前同號同量值 |
