jjjay0826/rocket-system/doc/failure_analysis_20260801.md

# 三項故障的根因分析 — 161 隊 2026-08-01 旭海

> ## 🔴 本檔狀態（2026-08-04 更新）
>
> | 章節 | 狀態 |
> |---|---|
> | **§1 GNSS 定位失效** | 🟢 仍然有效 |
> | **§2 卡爾曼速度估計失效** | 🟢 仍然有效 |
> | **§3 主傘未充氣** | 🔴 **結論已被推翻，不要引用** |
> | §3（舊版） | 🔴 更早的版本，同樣作廢 |
>
> **§3 說「主傘從未充氣」，這是錯的。**後續用 59.94 fps 原生幀逐格分析證實
> **主傘確實充氣過**（T+18.486 峰值 3443 px、長寬比 0.93），而且 ch2 錄到了
> **第二次開傘衝擊 5.62 g @ T+18.52**，與影像峰值吻合到 30 ms。
> （2026-10-15：對齊已實測，誤差 ± 0.07 s，應寫成「在 ± 0.1 s 內一致」而不是 30 ms；
> 結論不變。見 [parachute_failure_20260801.md](parachute_failure_20260801.md) 第 0.1 節。）
> §3 賴以立論的「開傘後沒有任何一刻減速」也因此不成立。
>
> **開傘議題請改看 → [parachute_failure_20260801.md](parachute_failure_20260801.md)**
> 總覽請看 → [flight_161_summary.md](flight_161_summary.md)
>
> §3 唯一仍然成立的部分是**設計層的問題**（單一彈射通道 → 主傘只能在最高速時
> 出艙）。那一條在新文件裡叫「第二個獨立設計問題」。

---

> 依據雙板遙測（ch1 / ch2 各一塊獨立航電板）、TASA Pioneer_5K 推力曲線、
> ATGM336H-5N 原廠規格書。每一項標明**確立程度**。
>
> **關鍵前提**：飛行狀態的三個基礎量已由互不共用感測器的三條鏈路互證：
> 起飛質量 29.999 kg（實測秤重）／燃盡質量 25.36 kg ／ 峰值比力 5.65–5.72 g。
> 引擎曲線正算 5.65 g，實測 5.65 g，**誤差 0.0%**。所以下面的數字沒有爭議空間。

---

## 一、GNSS 定位失效　🟢 根因確立

### 現象（量測）

| | ch1 | ch2 |
|---|---|---|
| 上升段 17 秒的位置變化 | 49 m | 49 m |
| 實際順航向位移（彈道重建） | 約 800 m | 同 |
| 頂點後跳點速度 | **511 m/s** | **306 m/s** |
| 傘降段路徑長 / 淨位移 | 57 / 22 m | **568 / 18 m** |
| 傘降段平均地速 | 2.7 m/s | **28 m/s** |
| 全程 `fix` / `sats` | 1 / 11–25 | 1 / 12–25 |

**兩顆接收機在同一根箭上、同一時刻，位置相距平均 109 m、最大 148 m。**

### 根因

**ATGM336H-5N 原廠規格書 §2.6：Maximum Acceleration = 4 g。**

| 規格項 | 上限 | 本次飛行 | |
|---|---|---|---|
| Maximum Height | 18,000 m | 833 m | ✓ |
| Maximum Speed | 515 m/s | 130 m/s | ✓ |
| **Maximum Acceleration** | **4 g** | **4.7 g** | ✗ **超出 18%** |

★ 這裡的 4.7 g 是**運動學加速度**：實測比力 5.72 g 扣掉 1 g 重力。
（比力是加速度計的直接讀值，靜置時就有 1 g；GNSS 追蹤迴路要跟上的是運動學量。
若再修正靜置刻度誤差——兩板都讀 0.974 而非 1.000——則為 4.87 g，超出 22%。）

推力段約 2.5 秒超出規格 → 載波追蹤迴路失鎖 → 定位解凍結。
燃燒結束後加速度降到 0.44 g（回到規格內），但**43 秒的飛行中從未恢復**。

### 為什麼 ch1 後來好了

ch1 在開傘衝擊時斷電重開（`RST=POWER-ON`），GNSS 模組跟著斷電 →
**冷啟動、濾波器狀態清空、重新捕獲** → 之後 2.7 m/s 的平順軌跡，
與傘降的真實漂移完全吻合。ch2 沒重開，帶著壞掉的解算狀態一路到海面。

### 責任分界

- **濾波器在模組晶片內**（中科微 AT6558），韌體 `gnss.c` 全檔 167 行，
  **零濾波、零平滑**，只是解析 NMEA 後直接賦值。不是自製程式的問題。
- 但 `GNSS_Init()` **沒有送任何設定給模組**，跑的是出廠預設。
- **最根本的是選料**：規格書自述應用為「車載／手機／穿戴裝置」，沒有航空。
  4 g 是模組的演算法上限，**任何設定都改不動**。

### 最致命的一點

`fix` 全程為 1、`sats` 維持 11–25。**接收機從頭到尾沒有回報任何異常。**
而且韌體其實**已經解析出** GPS 高度（`gnss.c:79`）與地速（`gnss.c:102`），
只是**沒有放進遙測封包**（`main.c:1984` 只送 fix / sats / LAT / LON）。

→ 若 GPS 高度有下行，這次故障在**飛行當下**就會一眼看穿：
氣壓計讀 800 m 而 GPS 高度停在 0 m。診斷工具就在板子上，只差沒接線。

### 改正

| 優先 | 動作 |
|---|---|
| 1 | **換模組**。選料時拿模擬的最大加速度去對 GNSS 規格；本箭模擬 T110 組就已超 4 g |
| 2 | **封包加 `GA_ALT`、`GA_SPD` 兩個欄位**。資料已經解出來了，只差送出去 |
| 3 | 開機時送組態（動態模式、更新率 1 Hz→10 Hz）。指令在《CASIC 多模衛星導航接收機協定規範》，**不在本規格書內**，需另外索取；且多數此類模組需 `$PCAS00` 存 flash，掉電會遺失 |
| 4 | `gnss.c` 未驗 NMEA checksum |
| 5 | 頂點後主動送一次接收機 reset（ch1 是意外做到的，證明有效） |

---

## 二、卡爾曼**速度**估計失效　🟡 現象確立，根因**未確立**

### 先釐清：壞的是速度，不是高度

| | 表現 |
|---|---|
| **高度 `kh`** | 與純氣壓 `rh` 只差約 4 m（0.5%）。**基本正常** |
| **速度 `vz`** | 頂點時應為 0，ch1 報 +3.8、ch2 報 **+13.1 m/s** |

這個區分決定了後果：

- `cond_A` 用**純氣壓**高度（不經卡爾曼）→ **兩板差 36 ms，完全可靠**
- `cond_B` 用 `kf2_v` → **兩板差 4.5 秒**

**同一趟飛行、同樣韌體：走純氣壓的判據一致到量測極限，走卡爾曼的判據差到荒謬。**

### 確立的事實

偏差是**加性常數**，不是時間延遲、也不是比例誤差：
滑行段 `VZ − dRH/dt` 穩定在 +13.05 ~ +13.51（標準差 < 0.2 m/s）。

來源是**推力段積分過頭**，滑行段被氣壓更新步慢慢修回來：

| | 推力段 VZ 峰值 | 氣壓實測 | 超出 | 頂點時殘餘 |
|---|---|---|---|---|
| ch1 | 138.9 m/s | 113 | +26 | +3.8 |
| ch2 | 154.8 m/s | 114 | +41 | **+13.1** |

### 對開傘的影響

`cond_B` 要求 `kf2_v < −0.5 m/s` **連續 1.5 秒**。ch2 帶著 +13 m/s 偏差，
所以它只勉強跌破門檻一點點，然後在那裡停了超過一秒：

| ch2 T+ | VZ | 距 −0.5 門檻 |
|---|---|---|
| 16.00 | −1.63 | 只低 1.13 |
| 16.50 | −1.56 | 只低 1.06 |
| 17.00 | −6.98 | 低 6.5 |

100 Hz 的氣壓雜訊在那一秒裡把 `kf2_v` 彈回 −0.5 以上一次，計時就重來。
ch1 沒有這個問題（T+15.52 時 VZ 已是 −11.32，穩穩在門檻下），所以
**ch1 靠 A∧B 開傘，ch2 只能等 18 秒備援計時器。**

### 🔴 根因未確立

曾經的假說是「Mahony 姿態濾波器在燃燒結束時翻轉」——燃燒結束後加速度計
量到的是阻力（方向與重力相反），而 `mahony_update()` 把加速度計**無條件**
當重力用，唯一防護是 `if(n<0.001) return`（只擋除零）。

**但這個假說解釋不了板間差異。**它是共模機制：同樣的韌體、同一趟飛行、
同樣的物理，應該對兩塊板一視同仁。而兩板的偏差差了 4 倍（+3.8 vs +13.1）。

我檢驗過的板間差異候選，量級都不夠：

| 候選 | 兩板差 | 能解釋 |
|---|---|---|
| `az_bias_g`（靜置 \|a\| 0.972 / 0.977） | 0.005 g | 約 0.7 m/s |
| IMU 安裝離軸角（12.6° / 10.3°） | 2.3° | 約 1.3 m/s |
| **實際差距** | | **約 10 m/s** |

差一個數量級。**目前無法判定。**

而且 **2 Hz 遙測無法檢驗 Mahony**：姿態積分需要 100 Hz，上升段陀螺到
47 deg/s，2 Hz 下每個取樣點之間轉 23°，積出來是垃圾。

### 怎麼定案

**SD 卡的 50 Hz 記錄。**它記了同樣的 ax/ay/az/gx/gy/gz，可以離線重跑
Mahony ＋ KF2，拿算出來的 `kf2_v` 對照韌體實際輸出的那一欄。
對得上 → 模型正確，問題在參數；對不上 → 問題在別的地方。

⚠ 取卡注意：`ST` 全程停在 3，**從未進 LANDED** → `f_truncate` 沒跑過 →
檔案是 16 MB 加垃圾尾巴，直接開會看到亂碼。用 `tools/recover_log.py` 切。

### 不受影響的部分（設計上的好決定）

- `cond_A` 用裸氣壓，沒被污染 —— **這個設計決定救了這趟飛行**
- 落地偵測與墜落救援都不使用 `kf2_v`

### 暫定改正（等根因確立再動）

- Mahony 加一道閘門：只有 `|a| ≈ 1 g` 時才信加速度計（3 行）
- `cond_B` 改吃 `vz_baro_lp`（純氣壓微分）而非 `kf2_v`
- ★ **發射日不要動開傘路徑**

---

## 三、主傘未充氣（拖曳傘正常）　🔴 **已被推翻（2026-08-04）**

> **本節的核心結論「主傘從未充氣」是錯的。**
>
> 用 59.94 fps 原生幀逐格分析證實主傘**確實充氣過**：T+18.220 開始張開
> （491 px），T+18.486 達峰值（3443 px，長寬比 **0.93**，接近正圓），
> 之後才在 0.5 秒內塌成飄帶。而且 ch2 錄到**第二次衝擊 5.62 g @ T+18.52**，
> 與影像峰值吻合到 **30 ms** —— 那就是主傘的開傘衝擊。
>
> 本節下方「開傘後沒有任何一刻減速 → 若曾充氣會留下速度凹陷；沒有」這條
> 論證因此不成立：**凹陷是有的，只是 ch1 在第一次衝擊後就失聯、
> ch2 剛好在那裡跳拍 1010 ms，兩塊板各錯過一半。**
> （2026-10-15：ch2 那次跳拍不是巧合，是它自己備援點火時阻塞送出開傘訊息造成的；
> 「吻合到 30 ms」應為「± 0.1 s 內一致」。見 parachute_failure 第 0.1、1 節。）
>
> 另外本節的數字有幾個已被更精確的重算取代：傘降率 30.4/31.0 → **33.5/32.1 m/s**；
> 開傘速度 58.5 → **約 41~43 m/s**（先前未修正 ch1 的 +0.49 s 時間偏移）。
>
> **現行版本 → [parachute_failure_20260801.md](parachute_failure_20260801.md)**
>
> ✅ 本節**仍然成立**的部分：下方「根因：單一彈射通道 → 主傘只能在最高速時
> 出艙」那一段。它在新文件裡被歸為「與自旋無關的第二個獨立設計問題」。

### ★ 先更正前一版的兩個錯誤

**錯誤 ①：我把它寫成「降落傘失效」。**
實際是**兩頂傘**：拖曳傘（十字傘）＋ 主傘（圓傘）。
實測 30.4 m/s **落在拖曳傘的正常降速區間**（HPR 通行做法 20~30 m/s，
刻意快以減少風漂；主傘才是 5~8 m/s）。
→ **拖曳傘正常運作，失效的是主傘。**

**錯誤 ②：我報的「有效阻力面積 0.49 m²、剩設計 4.7%」不成立。**
那個數字用了 25.36 kg 當下墜質量，但影像顯示箭身已分離成至少三節。
改用與質量無關的**彈道係數**：

| | 終端速度 | β = m/(Cd·A) = ρv²/(2g) |
|---|---|---|
| **實測** | 30.41 m/s | **51.9 kg/m²** |
| 設計（主傘） | 6.449 m/s | 2.44 kg/m² |
| | | **21 倍** |

這個量直接由氣壓計量到的終端速度得出，**不需要知道下墜物的質量**。

### 根因：單一彈射通道 → 主傘只能在最高速時出艙

**設計上主傘直接跟著拖曳傘出去**（團隊確認），而**韌體只有一次點火**
（PA0+PA1 並聯到同一顆電火頭，狀態機 `DEPLOYING→DEPLOYED` 之後無第二次觸發）。

所以主傘的釋放條件由拖曳傘的釋放時機決定，也就是**頂點後 2 秒**：

| | 垂直 | 水平 | 總速 | 偏離鉛直 | 動壓 |
|---|---|---|---|---|---|
| 開傘指令 T+16.02 | −21.1 | 47.4 | **51.9 m/s** | **66°** | 1481 Pa |
| 開傘衝擊 T+17.52 | −35.8 | 46.3 | **58.5 m/s** | **52°** | 1884 Pa |

**圓形主傘在 46 m/s 的側向氣流裡被拉出來，傘頂與傘裙之間建立不起壓差，
無法起始充氣 → streamer。這是必然，不是運氣。**

正常的二段回收是：頂點放拖曳傘 → 降到 200~300 m、速度降到 30 m/s 以下
→ 才放主傘。**單一點火通道做不到這件事。**

### 影像證據（YouTube 直播存檔，經天空抑制處理）

影像幀當時存在分析者電腦的 `flight_161_analysis/chute_frames/`，**沒有入庫**（668 MB）。
要重看：用 [`../tools/grab_yt_frames.py`](../tools/grab_yt_frames.py) 從直播存檔再抽一次，
來源與時間點見 [`flightdata/README.md`](flightdata/README.md)「沒有進來的東西」。

- **拖曳傘**：畫面上方一個小而緊實的彩色團 → 有充氣
- **主傘**：中央一條**細長的彩色條**，長寬比約 3:1，下方拖著一條窄長的
  傘繩帶 → **典型 streamer 外觀，從未充氣**
- **箭身**：至少三節分離，各自下墜

### 與遙測完全一致

開傘後**沒有任何一刻減速**（778 m → 20 m 全程等速 30.4 / 31.0 m/s，
兩板獨立量測）。若主傘曾短暫充氣後失效，會留下速度凹陷；沒有。

### 仍需現場確認

| 待查 | 為什麼重要 |
|---|---|
| 主傘傘衣有無撕裂／破口位置 | 區分「從未充氣」與「充氣後撕裂」 |
| 傘繩有無纏繞、扣眼有無拉脫 | 若有纏繞，則除了時機還有包裝問題 |
| 各節分離是否為設計預期 | 直接影響「發射後完整性」的評分論述 |
| 航電艙在哪一節、該節質量 | 兩板測到同樣降速 → 同一節；質量決定各節動能 |

### 改正（依重要性）

| 優先 | 動作 |
|---|---|
| **1** | **增加第二個點火通道**，主傘改由高度觸發（例如 250 m）。這是根因，其餘都是繞路 |
| 2 | 若無法增加通道：改用**能在橫流中起始充氣的傘型**（十字傘／導向面傘），或加大引導傘 |
| 3 | 降低開傘時的側向速度 —— 頂點時水平速度 45~47 m/s 本身就該在設計階段檢討 |
| 4 | 傘繩與連接件額定拉力對實際衝擊（2 Hz 量到 156 kgf，真峰值更高） |

---

## 三（舊版）、降落傘出艙但未充氣　🟡 現象確立，主因高度可疑但未證實

### 確立的事實

**有點火、有出艙：**
- 兩塊板的韌體訊息都明載開傘指令發出
- ch1 T+17.52 量到 **6.14 g 衝擊**（力 1527 N = 156 kgf）
  —— 沒有東西出去不會有這個

**但幾乎沒有產生阻力：**

| | Cd·A | 佔設計比 |
|---|---|---|
| 設計值（3.0.9 模擬，6.449 m/s） | **10.4 m²** | 100% |
| 衝擊瞬間（由 6.14 g 反推，2 Hz 下限） | 0.81 m² | 8% |
| **穩態傘降（30.4 m/s，雙板獨立實測）** | **0.49 m²** | **4.7%** |
| 裸箭身翻滾參考（3 m × 0.1 m, Cd≈1） | 約 0.30 m² | 3% |

→ **扣掉箭身本身，傘實際貢獻的阻力面積只有 0.19 m²**
　（Cd=1.5 時等效圓盤直徑 **0.40 m**，而設計傘徑約 3 m）

**不是自由翻滾：**
下降段橫向合成角速度 RMS 只有 **28 deg/s**（每 12.7 秒才轉一圈），
姿態穩定。有東西在後面拖著它。

**降落率全程等速：**
從 778 m 到 20 m，兩塊板獨立量到 30.4 / 31.0 m/s，殘差極小。
**開傘後沒有任何一刻減速過** —— 不存在「先張開再失效」的痕跡。

### 主因（高度可疑，但未證實）

**開傘時速度偏離鉛直 52–66°，側向氣流 46–47 m/s。**

| | 垂直 | 水平 | 總速 | 偏離鉛直 | 動壓 |
|---|---|---|---|---|---|
| 開傘指令 T+16.02 | −21.1 | 47.4 | **51.9 m/s** | **66°** | 1481 Pa |
| 開傘衝擊 T+17.52 | −35.8 | 46.3 | **58.5 m/s** | **52°** | 1884 Pa |

傘不是在垂直下落中被拉出來，而是**在 47 m/s 的橫向氣流裡**被拉出去。
這是 streamer（出艙未充氣）最典型的成因：傘衣被側風貼著箭身拖走，
傘頂與傘裙之間建立不起壓差，就無法起始充氣。

★ 水平分量的來源本身也值得檢討：發射架離垂直 10.4°，但燃盡時飛行路徑角
已達 29°，頂點時速度**完全是水平的 45–47 m/s**。也就是說火箭在滑行段
持續倒向下風，這件事在設計階段就該進模擬。

### 未證實 / 需要現場確認

| 待查 | 怎麼查 |
|---|---|
| 傘衣有沒有撕裂？破口在哪？ | **檢查回收的傘** |
| 傘繩有沒有纏繞？扣眼有沒有拉脫？ | 同上 |
| 傘包/傘袋有沒有正常脫離？ | 同上 |
| CO2 有沒有完全排空？ | **秤瓶刺破前後重量** |
| 開傘過程的影像 | **21.5 秒的發射影片** |

以下三個假說用現有資料**分不出來**（2 Hz 取樣看不到 1.5 秒內的過程）：

- (a) **Streamer** —— 傘衣出艙但從未充氣（與所有量測相符，最可能）
- (b) 短暫充氣後撕裂／收縮（2 Hz 分辨不出來，但開傘後從未減速，此說較弱）
- (c) 傘繩纏繞或傘袋未脫離（外觀檢查可判定）

### 後果

- **觸水速度 30 m/s（108 km/h）**，動能 **11.7 kJ**，等同從 **47 m** 自由落下
- 遙測在 10 m（ch1）／20 m（ch2）高度中斷，觸水瞬間未記錄
- 對評分：「不完全開啟或斷裂」＝**半分**，不是「無運作」——上述四條證據鏈支持此主張

### 改正

| 優先 | 動作 |
|---|---|
| 1 | **降低開傘時的側向速度**：發射仰角、滑行段倒向控制、或延後開傘至速度更低時 |
| 2 | 若無法降低側向速度，改用**能在橫流中起始充氣的傘型**（十字傘／導向面傘／先放小引導傘） |
| 3 | 檢討開傘時機：目前 A∧B 與備援計時器都在頂點後 2–4 秒觸發，那時水平速度仍有 46 m/s |
| 4 | 傘繩與連接件額定拉力要對得上實際衝擊（本次 2 Hz 量到 156 kgf，真峰值更高） |

---

## 三項的共同教訓

**沒有一項是「軟體寫錯」。**

| 故障 | 性質 |
|---|---|
| GNSS | **選料超規** —— 模組 4 g 上限 vs 飛行 4.7 g |
| 卡爾曼速度 | **參數/校正**（根因未確立），但設計上讓 `cond_A` 走裸氣壓救了場 |
| 降落傘 | **飛行條件超出設計假設** —— 設計假設垂直下落，實際 52–66° 側向 |

**三項都可以在設計階段用模擬數字看出來**：模擬的最大加速度該去對 GNSS 規格；
模擬的開傘時速度向量該去對傘的充氣條件。

---

## 附：本文用到的資料與工具

```
doc/flightdata/20260801/raw_ch1_..._utc.log   板 1 原始遙測（含 UTC）
doc/flightdata/20260801/raw_ch2_..._utc.log   板 2 原始遙測（含 UTC）
sim/motors/Pioneer5K.eng                      引擎推力曲線
（GNSS 模組規格書 ATGM336H-5N 未收進 repo，向原廠取得）
（解析結果與儀表板可用下列工具重產，不入版控）

rocket-system\tools\parse_raw_lora.py     遙測解析（含 UTC 前綴）
rocket-system\tools\flight_report.py      雙板儀表板
rocket-system\tools\compare_boards.py     雙板交叉比對
rocket-system\tools\fit_ballistic.py      開傘速度向量反解
rocket-system\tools\recover_log.py        SD 卡救援（★取卡必用）
```
