jjjay0826/rocket-system/doc/history/deploy_logic_v1.5_2026-02-06.png

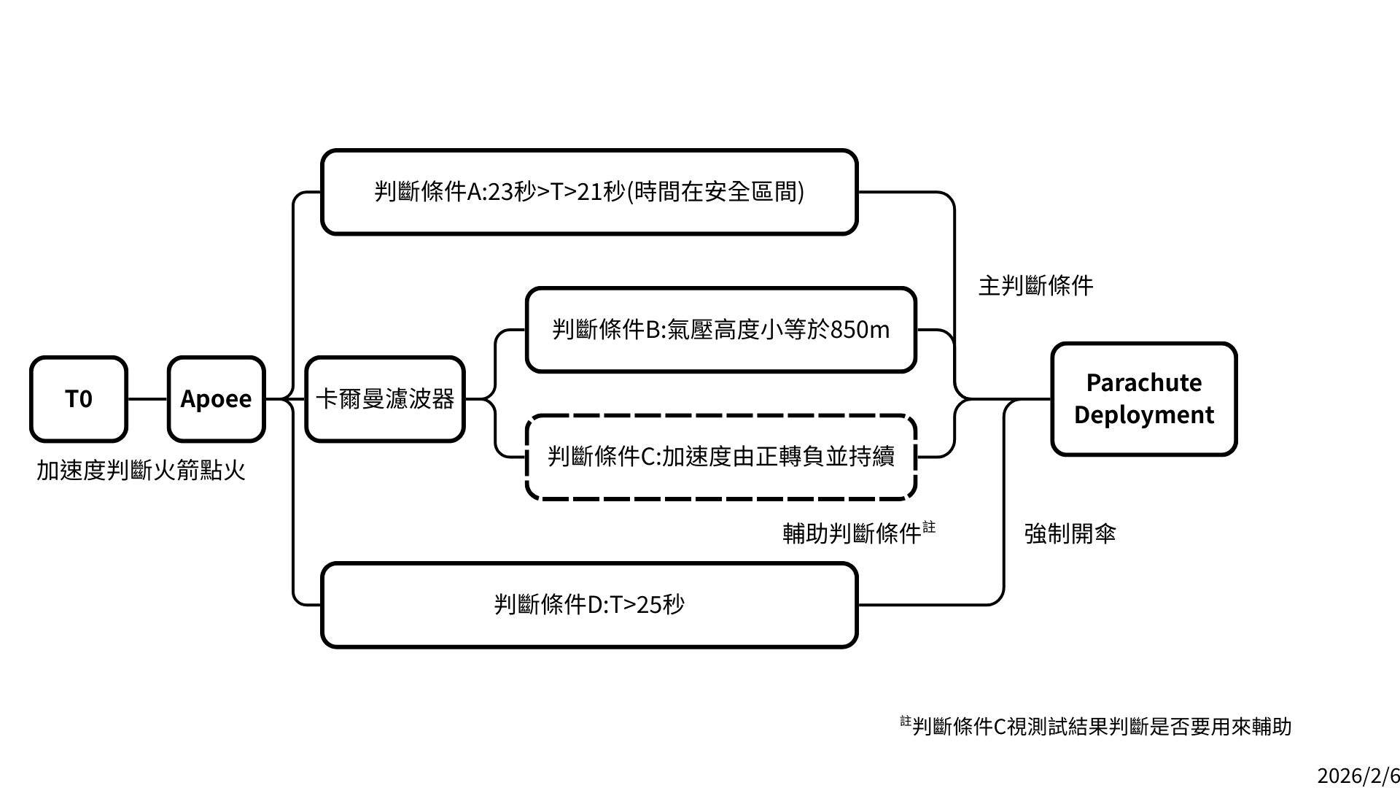
doc/history/deploy_logic_v1.5_2026-02-06.png
