jjjay0826/rocket-system/hardware/avionics_v1_2025-05/schematic_avionics_v1_2025-05-22.pdf

# PB1 19 PB2 20 PB3 39 PB4 40 PB5 41 PB6 42 PB7 43

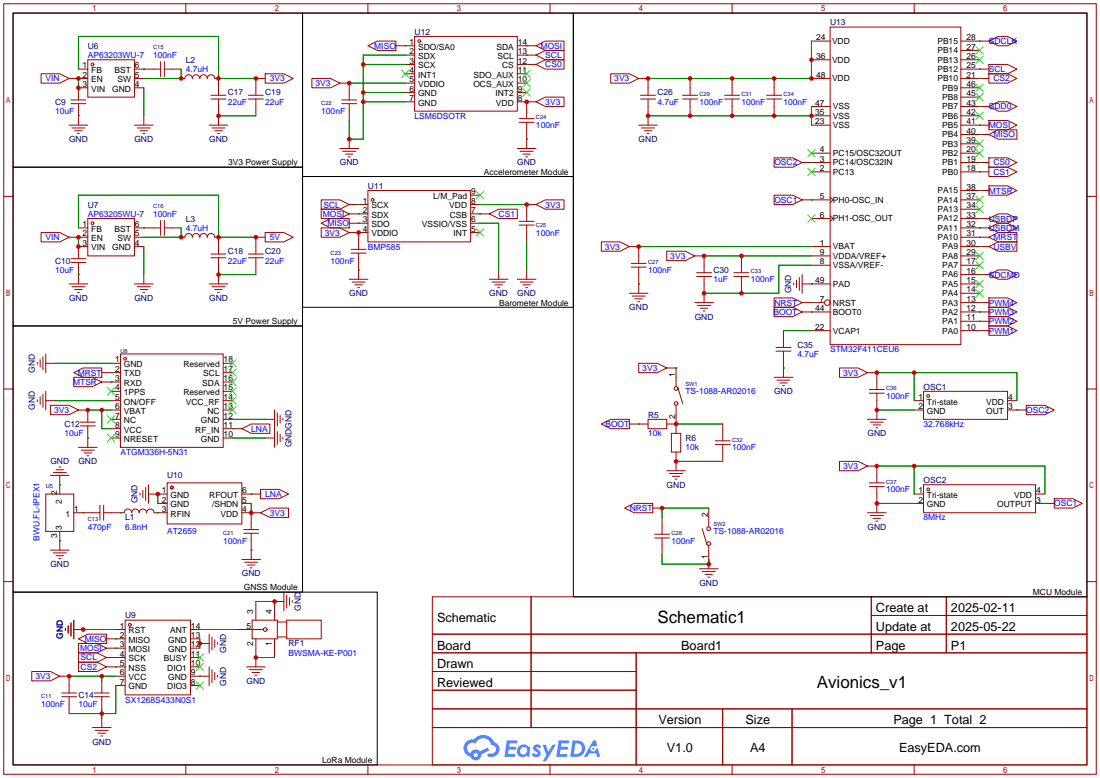
[picture p2: page 1]

Schematic | Schematic1 | Create at | 2025-02-11

DIO1 10 BUSY 11 GND 12 GND 13 ANT 14

Update at | 2025-05-22

Board | Board1 | Page | P1
Drawn | | Avionics_v1
Reviewed

Version | Size | Page 1 Total 2
V1.0 | A4 | EasyEDA.com

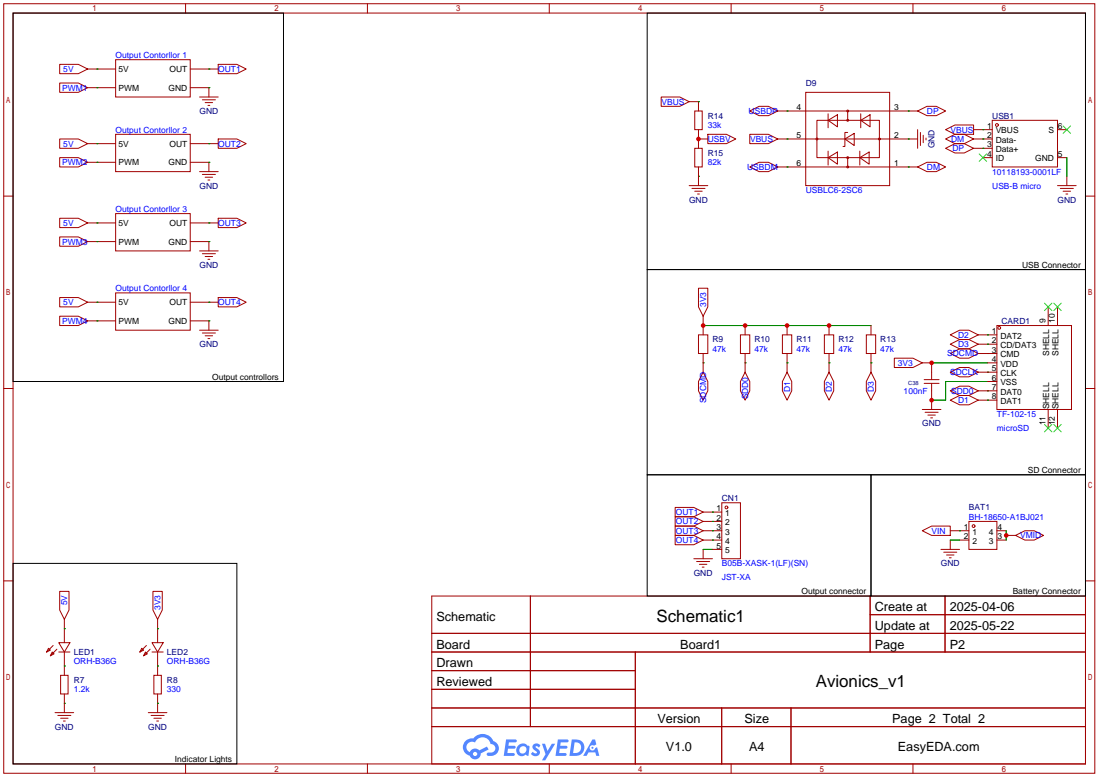
[picture p3: page 2]

Schematic | Schematic1 | Create at | 2025-04-06

Update at | 2025-05-22

Board | Board1 | Page | P2
Drawn | | Avionics_v1
Reviewed

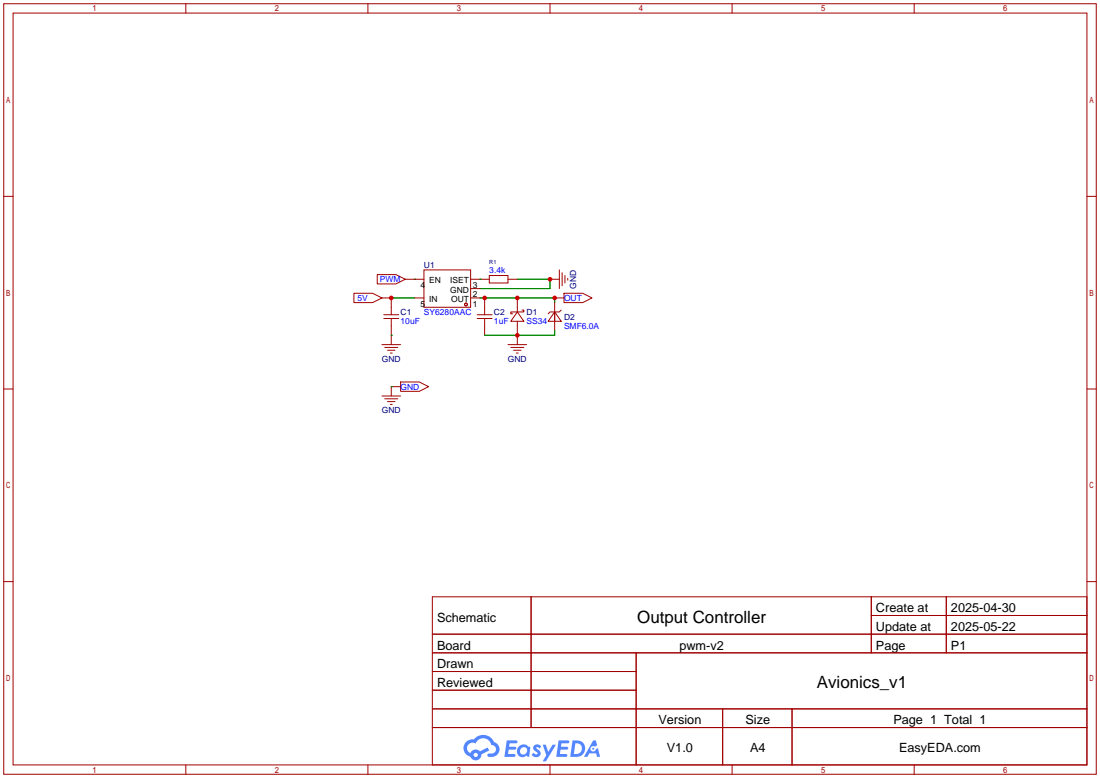
[picture p4: page 3]

Schematic | Output Controller | Create at | 2025-04-30

Update at | 2025-05-22

Board | pwm-v2 | Page | P1
Drawn | | Avionics_v1
Reviewed

5V

PWM

OUTGND

GND | GND

GND

GND

OUT 1

GND 2

ISET 3

EN 4
IN 5

U2

SY6280AAC | D4 SMF6.0A

D3
SS34

C4
1uF

C3
10uF

R2
3.4k

5V

PWM

OUTGND

GND | GND

GND

GND

OUT 1

GND 2

ISET 3

EN 4
IN 5

U3

SY6280AAC | D6 SMF6.0A

D5
SS34

C6
1uF

C5
10uF

R3
3.4k

5V

PWM

OUTGND

GND | GND

GND

GND

OUT 1

GND 2

ISET 3

EN 4
IN 5

U4

SY6280AAC | D8 SMF6.0A

D7
SS34

C8
1uF

C7
10uF

R4
3.4k
