jjjay0826/rocket-system/hardware/rocket_v7_2026-06/schematic_rocket_v7_2026-06-22.pdf

V1.0 | A4 | EasyEDA.com M⁰ M¹ RXTXAUX VCC GND SMA⁻F

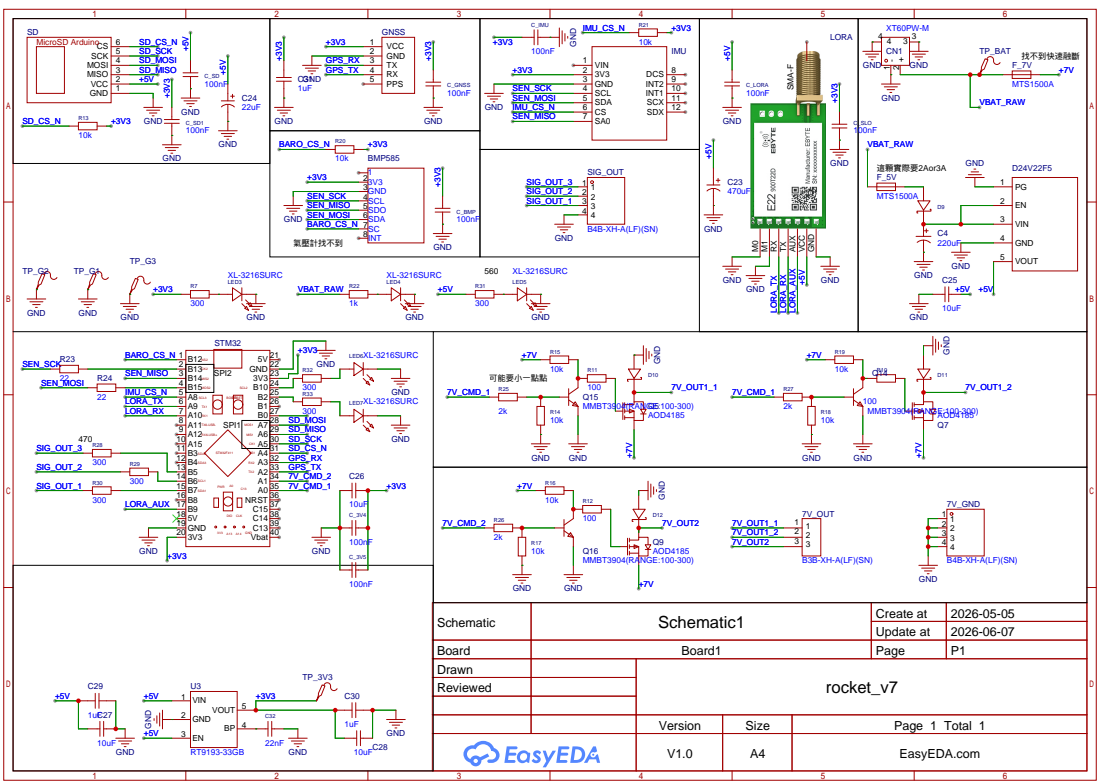
[picture p5: page 1]

Schematic | Schematic1 | Create at | 2026-05-05

Update at | 2026-06-07

Board | Board1 | Page | P1
Drawn | | rocket_v7
Reviewed
