jjjay0826/rocket-system/hardware/avionics_v1_2025-05/pcb_avionics_v1_2025-05-22.pdf

# GPS

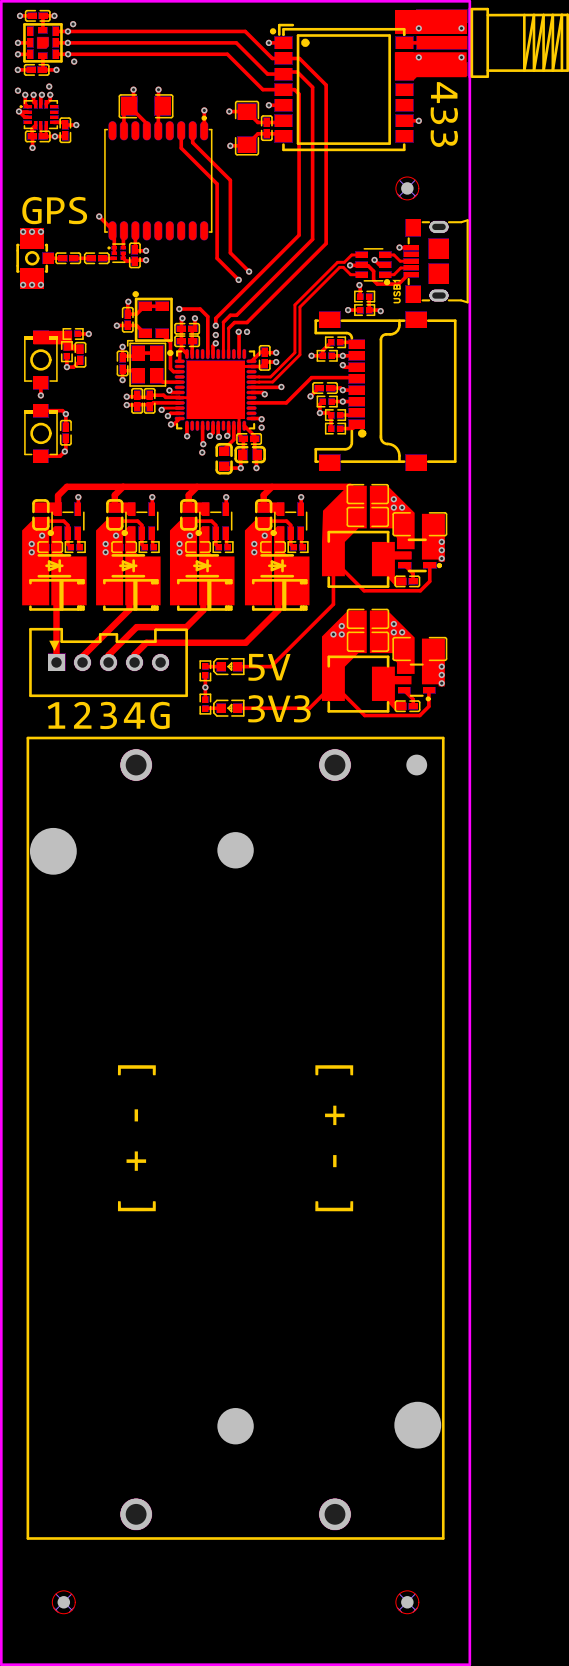
[picture p6: page 1]

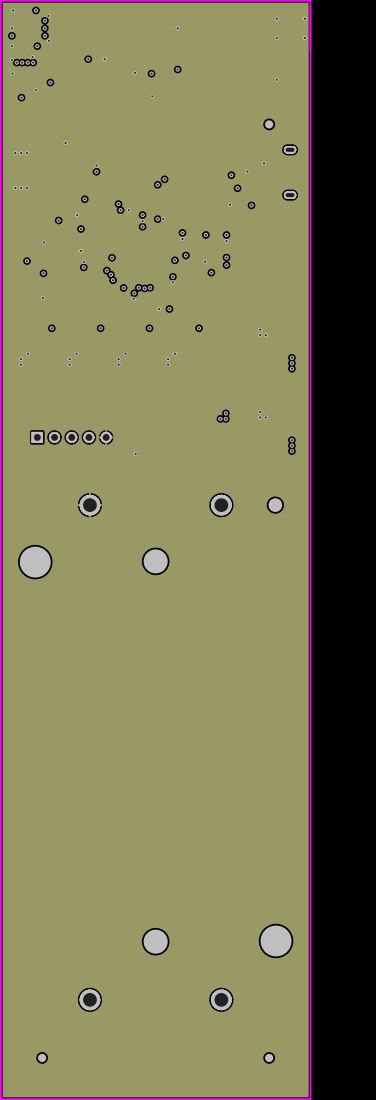
[picture p7: page 2]

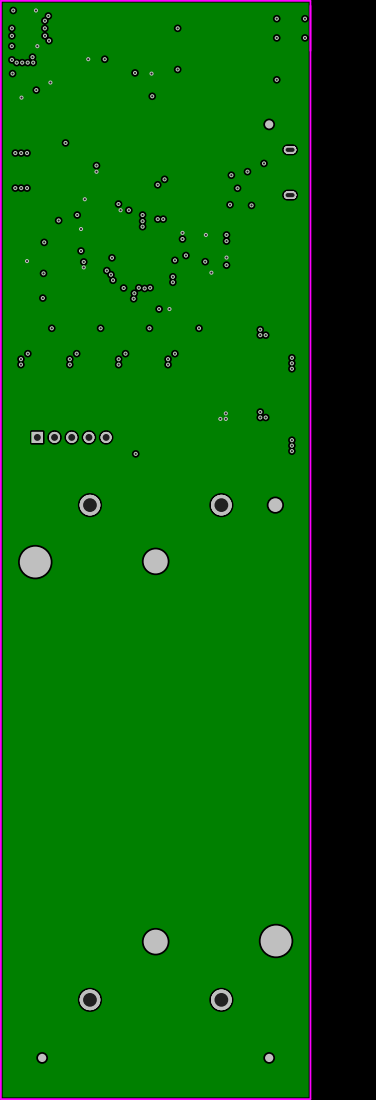
[picture p8: page 3]

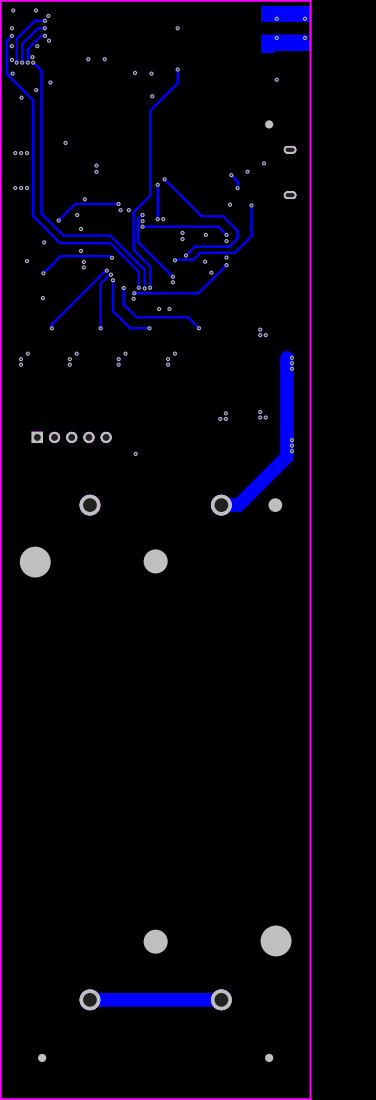
[picture p9: page 4]

# GPS

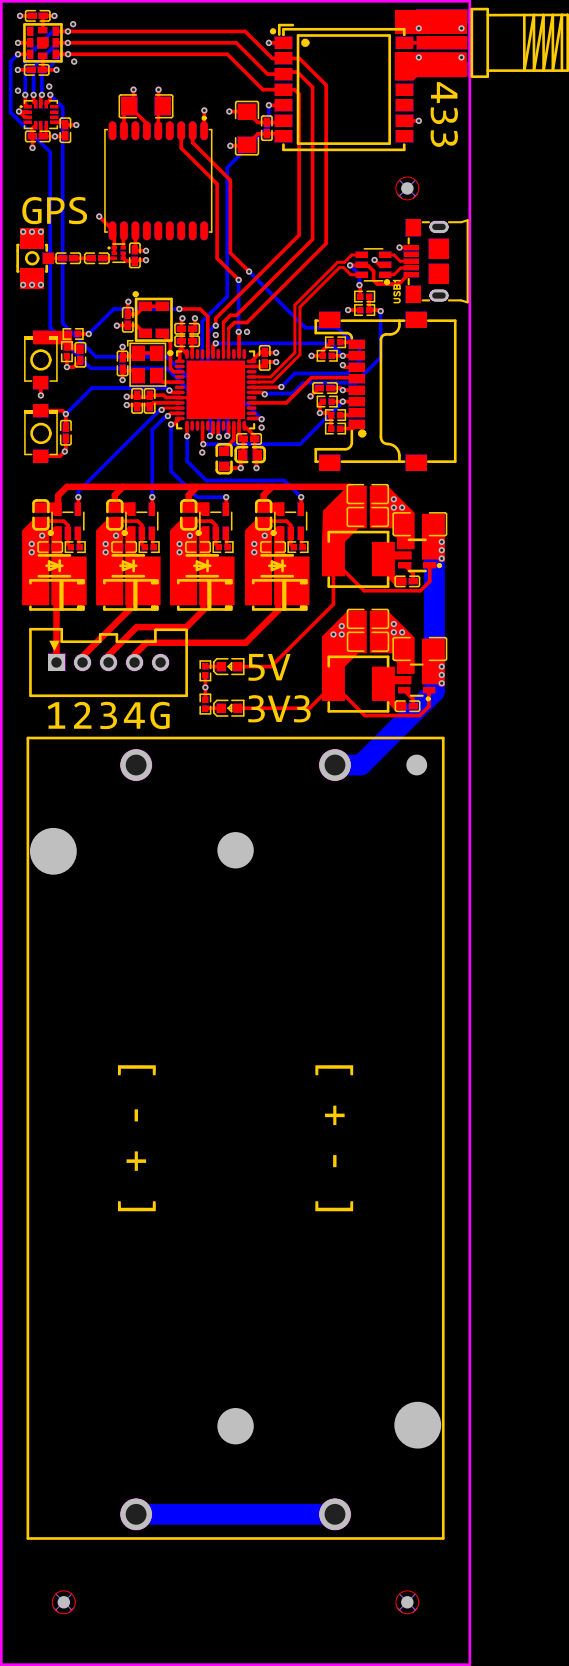
[picture p10: page 5]
