jjjay0826/rocket-system/firmware-rocket/Core/Inc/main.h

#define FIRE_7V_1_Pin GPIO_PIN_0
#define FIRE_7V_1_GPIO_Port GPIOA
#define FIRE_7V_2_Pin GPIO_PIN_1
#define FIRE_7V_2_GPIO_Port GPIOA
#define GPS_TX_Pin GPIO_PIN_2
#define GPS_TX_GPIO_Port GPIOA
#define GPS_RX_Pin GPIO_PIN_3
#define GPS_RX_GPIO_Port GPIOA
#define SD_CS_Pin GPIO_PIN_4
#define SD_CS_GPIO_Port GPIOA
#define SD_SCK_Pin GPIO_PIN_5
#define SD_SCK_GPIO_Port GPIOA
#define SD_MISO_Pin GPIO_PIN_6
#define SD_MISO_GPIO_Port GPIOA
#define SD_MOSI_Pin GPIO_PIN_7
#define SD_MOSI_GPIO_Port GPIOA
#define LED_B2_Pin GPIO_PIN_2
#define LED_B2_GPIO_Port GPIOB
#define LED_B10_Pin GPIO_PIN_10
#define LED_B10_GPIO_Port GPIOB
#define BARO_CS_Pin GPIO_PIN_12
#define BARO_CS_GPIO_Port GPIOB
#define SEN_SCK_Pin GPIO_PIN_13
#define SEN_SCK_GPIO_Port GPIOB
#define SEN_MISO_Pin GPIO_PIN_14
#define SEN_MISO_GPIO_Port GPIOB
#define SEN_MOSI_Pin GPIO_PIN_15
#define SEN_MOSI_GPIO_Port GPIOB
#define IMU_CS_N_Pin GPIO_PIN_8
#define IMU_CS_N_GPIO_Port GPIOA
#define LORA_TX_Pin GPIO_PIN_9
#define LORA_TX_GPIO_Port GPIOA
#define LORA_RX_Pin GPIO_PIN_10
#define LORA_RX_GPIO_Port GPIOA
#define SIG_3_Pin GPIO_PIN_5
#define SIG_3_GPIO_Port GPIOB
#define SIG_2_Pin GPIO_PIN_6
#define SIG_2_GPIO_Port GPIOB
#define SIG_1_Pin GPIO_PIN_7
#define SIG_1_GPIO_Port GPIOB
#define LORA_AUX_Pin GPIO_PIN_9
#define LORA_AUX_GPIO_Port GPIOB
