jjjay0826/rocket-system/firmware-rocket/Core/Src/sd_diskio_spi.c

/*
 * sd_diskio_spi.c - SD/SDHC SPI 模式 diskio（rocket_v2）
 * SPI1 + CS=PA4。基於 ChaN MMC/SDC SPI 參考實作，移植 STM32 HAL。
 *
 * 速度：init 階段 <400kHz（prescaler 256），資料階段 ~5MHz（prescaler 16，
 *       經 Arduino 模組的 74LVC125 電平轉換較保守、可靠）。
 * 注意：需週期呼叫 SD_disk_timerproc()（每 ~10ms）讓逾時計數遞減。
 */
#include "sd_diskio_spi.h"
#include "spi.h"
#include "main.h"

extern SPI_HandleTypeDef hspi1;
#define SD_SPI   (&hspi1)

/* ── CS = CubeMX label「SD_CS」(PA4) ── */
#define CS_LOW()   HAL_GPIO_WritePin(SD_CS_GPIO_Port, SD_CS_Pin, GPIO_PIN_RESET)
#define CS_HIGH()  HAL_GPIO_WritePin(SD_CS_GPIO_Port, SD_CS_Pin, GPIO_PIN_SET)

/* ── 命令 ── */
#define CMD0   (0)          /* GO_IDLE_STATE */
#define CMD1   (1)          /* SEND_OP_COND (MMC) */
#define ACMD41 (0x80+41)    /* SEND_OP_COND (SDC) */
#define CMD8   (8)          /* SEND_IF_COND */
#define CMD9   (9)          /* SEND_CSD */
#define CMD12  (12)         /* STOP_TRANSMISSION */
#define CMD16  (16)         /* SET_BLOCKLEN */
#define CMD17  (17)         /* READ_SINGLE_BLOCK */
#define CMD18  (18)         /* READ_MULTIPLE_BLOCK */
#define CMD24  (24)         /* WRITE_BLOCK */
#define CMD25  (25)         /* WRITE_MULTIPLE_BLOCK */
#define CMD55  (55)         /* APP_CMD */
#define CMD58  (58)         /* READ_OCR */

/* ── 卡種類旗標 ── */
#define CT_MMC   0x01
#define CT_SD1   0x02
#define CT_SD2   0x04
#define CT_SDC   (CT_SD1|CT_SD2)
#define CT_BLOCK 0x08

static volatile DSTATUS Stat = STA_NOINIT;   /* 磁碟狀態 */
static BYTE  CardType;
volatile uint8_t SD_dbg_cmd0 = 0xEE, SD_dbg_cmd8 = 0xEE;   /* debug：init 階段 CMD0/CMD8 回應 */
volatile uint32_t SD_dbg_spierr     = 0;   /* debug：xchg_spi 中 HAL 傳輸失敗的累計次數 */
volatile uint8_t  SD_dbg_spi_status = 0;   /* debug：最後一次 HAL status（1=ERROR 2=BUSY 3=TIMEOUT）*/
volatile uint32_t SD_dbg_spi_errcode = 0;  /* debug：最後一次 SPI ErrorCode（HAL_SPI_ERROR_*）*/
/* 逾時一律用 HAL_GetTick()(1ms SysTick) 計算 deadline，不依賴 timerproc 呼叫頻率 */

/* ══════════ SPI 低階 ══════════ */
static void FCLK_SLOW(void)  /* <400kHz：APB2 84MHz / 256 = 328kHz */
{ MODIFY_REG(SD_SPI->Instance->CR1, SPI_CR1_BR, SPI_BAUDRATEPRESCALER_256); }
static void FCLK_FAST(void)  /* 資料階段 656kHz（84MHz/128）
 * 原為 /16=5.25MHz：實測 CSV 內容出現位元亂碼（每行開頭欄位被打壞），
 * 5.25MHz 過 74HC125+排針+載板走線疑似邊際。（jx06t 降速只降到 init，此處才是資料段）
 * ⚠ 吞吐：飛行中 50Hz CSV ≈ 7-9KB/s，656kHz 實效 ~55-65KB/s → 餘裕 ~6-9×
 *  （非舊註解的「數百倍」——加欄位/提速前先重算）。 */
{ MODIFY_REG(SD_SPI->Instance->CR1, SPI_CR1_BR, SPI_BAUDRATEPRESCALER_128); }

static BYTE xchg_spi(BYTE dat)
{
    BYTE rx = 0xFF;
    HAL_StatusTypeDef st = HAL_SPI_TransmitReceive(SD_SPI, &dat, &rx, 1, 50);
    if (st != HAL_OK) {            /* HAL 傳輸失敗 → rx 仍是初值 0xFF，記錄下來以辨「假象」*/
        SD_dbg_spierr++;
        SD_dbg_spi_status  = (uint8_t)st;
        SD_dbg_spi_errcode = SD_SPI->ErrorCode;
    }
    return rx;
}
static void rcvr_spi_multi(BYTE *buff, UINT btr)
{
    for (UINT i = 0; i < btr; i++) buff[i] = xchg_spi(0xFF);
}
/* ★2026-07-31：逾時由 1000ms 降到 100ms。
 *
 * 這個函式跑在主迴圈裡，而【開傘狀態機也在同一個迴圈】。SD 卡卡住的
 * 時候，主迴圈就停在這裡，期間感測器不更新、cond_A/cond_B 不重算、
 * 18 秒備援計時不檢查。
 *
 * 單次磁區寫入的阻塞上限原本是：
 *     send_cmd → select_card → wait_ready(500)      500ms
 *     xmit_datablock → wait_ready(500)              500ms
 *     xmit_spi_multi                               1000ms
 *                                          合計 ~2000ms
 * 而 81 組模擬裡 C 備援最小餘裕只有 1.29 秒 —— 同一個數量級。
 *
 * 512 bytes @ 656kHz 實際只要 6.2ms。100ms 已經是 16 倍餘裕，正常
 * 傳輸絕不會誤觸；真的超過 100ms 表示 SPI 或卡片已經異常，那時候
 * 【快點失敗】遠比繼續等有價值 —— 資料本來就以 LoRa 為主，
 * 為了一筆寫不進去的 CSV 賠掉開傘時序不划算。
 *
 * 註：wait_ready 的兩個 500ms 沒有動。那是在等卡片完成 program，
 * SD 規格允許到 250ms，砍下去會誤判正常的慢卡。改完的上限 ~1.1s。*/
static void xmit_spi_multi(const BYTE *buff, UINT btx)
{
    HAL_SPI_Transmit(SD_SPI, (uint8_t*)buff, (uint16_t)btx, 100);
}

/* 等卡就緒（回傳 0xFF 表示 ready）；wt = 逾時 ms */
static int wait_ready(UINT wt)
{
    BYTE d;
    uint32_t t0 = HAL_GetTick();
    do { d = xchg_spi(0xFF); } while (d != 0xFF && (HAL_GetTick() - t0) < wt);
    return (d == 0xFF) ? 1 : 0;
}

static void deselect(void)
{
    CS_HIGH();
    xchg_spi(0xFF);   /* 釋放 DO，給卡一個時脈 */
}

static int select_card(void)   /* 1=OK, 0=timeout */
{
    CS_LOW();

    /* ================================================= */
    /* 新增延遲區塊：給予電平轉換晶片足夠的反應時間 */
    /* 模擬 Arduino digitalWrite 的延遲 (約幾微秒) */
    for(volatile int i = 0; i < 500; i++) {
        __NOP();
    }
    /* ================================================= */

    xchg_spi(0xFF); // 發送 Dummy Clock 讓 SD 卡準備好
    
    if (wait_ready(500)) return 1;
    
    deselect();
    return 0;
}

/* 讀資料區塊（btr 必為 512 的倍數情境下逐 512）*/
static int rcvr_datablock(BYTE *buff, UINT btr)
{
    BYTE token;
    uint32_t t0 = HAL_GetTick();
    do { token = xchg_spi(0xFF); } while (token == 0xFF && (HAL_GetTick() - t0) < 200);
    if (token != 0xFE) return 0;          /* 非起始 token = 錯誤 */
    rcvr_spi_multi(buff, btr);
    xchg_spi(0xFF); xchg_spi(0xFF);       /* 丟棄 CRC */
    return 1;
}

#if _USE_WRITE
static int xmit_datablock(const BYTE *buff, BYTE token)
{
    if (!wait_ready(500)) return 0;
    xchg_spi(token);                       /* 起始 token */
    if (token != 0xFD) {                   /* 0xFD = 停止 token，無資料 */
        xmit_spi_multi(buff, 512);
        xchg_spi(0xFF); xchg_spi(0xFF);    /* CRC dummy */
        BYTE resp = xchg_spi(0xFF);
        if ((resp & 0x1F) != 0x05) return 0;   /* 0x05 = 資料已接受 */
    }
    return 1;
}
#endif

/* 送命令；回傳 R1（bit7=0 表示有效）*/
static BYTE send_cmd(BYTE cmd, DWORD arg)
{
    BYTE n, res;

    if (cmd & 0x80) {                      /* ACMD：先送 CMD55 */
        cmd &= 0x7F;
        res = send_cmd(CMD55, 0);
        if (res > 1) return res;
    }

    if (cmd != CMD12) {
        deselect();
        if (!select_card()) return 0xFF;
    }

    xchg_spi(0x40 | cmd);
    xchg_spi((BYTE)(arg >> 24));
    xchg_spi((BYTE)(arg >> 16));
    xchg_spi((BYTE)(arg >> 8));
    xchg_spi((BYTE)arg);
    n = 0x01;                              /* 預設 CRC */
    if (cmd == CMD0) n = 0x95;             /* CMD0 CRC */
    if (cmd == CMD8) n = 0x87;             /* CMD8(0x1AA) CRC */
    xchg_spi(n);

    if (cmd == CMD12) xchg_spi(0xFF);      /* CMD12：丟一個 stuff byte */
    n = 10;
    do { res = xchg_spi(0xFF); } while ((res & 0x80) && --n);
    return res;
}

/* ── 深度救援：解開「寫入中被 reset/斷觸打斷」後鎖死的卡 ──────────────
 * 情境（2026-07-20 室外實測）：CSV 寫入中按 reset → 卡沒斷電、內部狀態機
 * 停在半途 → 重開機後 CMD0 輕量重試 5 次全敗，直到整機斷電才復活。
 * 卡可能停在三種狀態，逐一對症：
 *  (a) CMD25 等資料 token → 送停止 token 0xFD，讓卡結束多塊寫入
 *  (b) CMD18 連續讀     → CMD12 (STOP_TRANSMISSION) 中止
 *  (c) program busy（DO 拉低）→ wait_ready 長等，讓卡把中斷的寫入做完
 * 全程低速時脈（呼叫端已 FCLK_SLOW）。耗時上限 ~1.1s，只在輕量重試
 * 三連敗後執行一次。※ 斷電重開仍最可靠，本序列是把「按 reset 就能救回」
 * 的機率拉高，不是保證。 */
static void sd_unstick_card(void)
{
    /* 1. CS_HIGH 送 4096 時脈：若卡在等資料，把殘留的半個資料框沖掉 */
    CS_HIGH();
    for (int i = 0; i < 512; i++) xchg_spi(0xFF);

    /* 2. 停止 token 0xFD：卡若在 CMD25 等 token，收到後開始收尾（進 busy）*/
    CS_LOW();
    for (volatile int i = 0; i < 500; i++) __NOP();   /* 電平穩定延遲 */
    xchg_spi(0xFD);
    xchg_spi(0xFF);

    /* 3. CMD12：卡若在 CMD18 連續讀，中止它（在寫入狀態下卡會忽略，無害）*/
    xchg_spi(0x40 | CMD12);
    xchg_spi(0); xchg_spi(0); xchg_spi(0); xchg_spi(0);
    xchg_spi(0x01);                        /* dummy CRC */
    xchg_spi(0xFF);                        /* CMD12 stuff byte */
    for (int i = 0; i < 10; i++) xchg_spi(0xFF);   /* 丟棄回應 */

    /* 4. 等卡把被打斷的 program 寫完（NAND page program 最長可到數百 ms）*/
    wait_ready(500);

    deselect();
    HAL_Delay(10);
}

/* ══════════ diskio 介面 ══════════ */
DSTATUS SD_disk_status(BYTE pdrv)
{
    if (pdrv) return STA_NOINIT;
    return Stat;
}

DSTATUS SD_disk_initialize(BYTE pdrv)
{
    BYTE n, cmd, ty, ocr[4];

    if (pdrv) return STA_NOINIT;

    FCLK_SLOW();
    ty = 0;
    SD_dbg_cmd0 = 0xFF;

    /* ── CMD0 送出（含重試）───────────────────────────────────────────────
     * 兩個已知狀況一起處理：
     *  (1) 卡「還沒進 SPI 模式」時本模組 MISO 恆低（曾實測 0x00），所以 CMD0
     *      不能用 send_cmd→wait_ready（會一直等 MISO 變高、timeout）；這裡 CS
     *      拉低後直接送 frame + 讀 R1，繞過 wait_ready。
     *  (2) 只按 reset（卡沒斷電）時，卡可能還停在上次 busy/寫入狀態，單次 CMD0
     *      會失敗（就是偶爾看到的 MOD=1110）。故重試 3 次，每次先多送喚醒時脈
     *      + 短延遲，給卡時間回 idle。
     *  (3) 三連敗 → 深度救援一次再給兩次機會（見 sd_unstick_card）：
     *      實測 2026-07-20 室外，reset 後 5 次 init 全敗、直到斷電才復活＝
     *      卡停在被打斷的寫入狀態，輕量重試永遠救不回。
     * 判讀：cmd0=01 → 進 idle 成功；cmd0=FF/00 → 卡沒回（查硬體 / 或斷電重開）。*/
    for (int attempt = 0; attempt < 5; attempt++) {
        if (attempt == 3) sd_unstick_card();   /* 前 3 次輕量重試沒過 → 深度救援 */

        CS_HIGH();
        for (n = 20; n; n--) xchg_spi(0xFF);   /* 160 時脈：喚醒 + 沖掉上次殘留 */
        HAL_Delay(2);                          /* 給卡時間結束上次 busy */

        CS_LOW();
        for (volatile int i = 0; i < 500; i++) __NOP();   /* 電平穩定延遲 */
        xchg_spi(0xFF);                                   /* 一個 dummy clock */
        xchg_spi(0x40 | CMD0);                            /* CMD0 */
        xchg_spi(0); xchg_spi(0); xchg_spi(0); xchg_spi(0);   /* arg = 0 */
        xchg_spi(0x95);                                   /* CMD0 CRC */
        { BYTE r; n = 10; do { r = xchg_spi(0xFF); } while ((r & 0x80) && --n); SD_dbg_cmd0 = r; }

        if (SD_dbg_cmd0 == 1) break;   /* 進 idle → 成功，跳出重試 */
        deselect();
        HAL_Delay(5);                  /* 沒過 → 等一下再試 */
    }
    SD_dbg_cmd8 = 0xEE;
    if (SD_dbg_cmd0 == 1) {                /* 進入 idle */
        uint32_t it0 = HAL_GetTick();      /* 初始化 1s 預算 */
        SD_dbg_cmd8 = send_cmd(CMD8, 0x1AA);
        if (SD_dbg_cmd8 == 1) {            /* SDv2? */
            for (n = 0; n < 4; n++) ocr[n] = xchg_spi(0xFF);
            if (ocr[2] == 0x01 && ocr[3] == 0xAA) {        /* 2.7-3.6V */
                while ((HAL_GetTick() - it0) < 1000 && send_cmd(ACMD41, 0x40000000)) ;  /* HCS */
                if ((HAL_GetTick() - it0) < 1000 && send_cmd(CMD58, 0) == 0) {
                    for (n = 0; n < 4; n++) ocr[n] = xchg_spi(0xFF);
                    ty = (ocr[0] & 0x40) ? (CT_SD2 | CT_BLOCK) : CT_SD2;
                }
            }
        } else {                            /* SDv1 或 MMC */
            if (send_cmd(ACMD41, 0) <= 1) { ty = CT_SD1; cmd = ACMD41; }
            else                          { ty = CT_MMC; cmd = CMD1;   }
            while ((HAL_GetTick() - it0) < 1000 && send_cmd(cmd, 0)) ;
            if ((HAL_GetTick() - it0) >= 1000 || send_cmd(CMD16, 512) != 0) ty = 0;  /* 設 512 區塊 */
        }
    }
    CardType = ty;
    deselect();

    if (ty) {                               /* 初始化成功 */
        FCLK_FAST();
        Stat &= ~STA_NOINIT;
    } else {
        Stat = STA_NOINIT;
    }
    return Stat;
}

void SD_disk_deinit(void) {
    Stat = STA_NOINIT;
}

DRESULT SD_disk_read(BYTE pdrv, BYTE *buff, DWORD sector, UINT count)
{
    if (pdrv || !count) return RES_PARERR;
    if (Stat & STA_NOINIT) return RES_NOTRDY;

    if (!(CardType & CT_BLOCK)) sector *= 512;   /* 非 SDHC：位元組定址 */

    if (count == 1) {
        if (send_cmd(CMD17, sector) == 0 && rcvr_datablock(buff, 512))
            count = 0;
    } else {
        if (send_cmd(CMD18, sector) == 0) {
            do {
                if (!rcvr_datablock(buff, 512)) break;
                buff += 512;
            } while (--count);
            send_cmd(CMD12, 0);              /* 停止連續讀取 */
        }
    }
    deselect();
    return count ? RES_ERROR : RES_OK;
}

#if _USE_WRITE
DRESULT SD_disk_write(BYTE pdrv, const BYTE *buff, DWORD sector, UINT count)
{
    if (pdrv || !count) return RES_PARERR;
    if (Stat & STA_NOINIT) return RES_NOTRDY;
    if (Stat & STA_PROTECT) return RES_WRPRT;

    if (!(CardType & CT_BLOCK)) sector *= 512;

    if (count == 1) {
        if (send_cmd(CMD24, sector) == 0 && xmit_datablock(buff, 0xFE))
            count = 0;
    } else {
        /* ★2026-07-31：原本這裡是
         *     if (CardType & CT_SDC) send_cmd(ACMD41, 0);
         * 註解寫「(可選) 預擦除提示略」—— 但命令並沒有被略掉，而且送錯了。
         *
         * ChaN 參考實作在這個位置送的是 ACMD23 (SET_WR_BLK_ERASE_COUNT)，
         * 引數是 count。ACMD41 是 SEND_OP_COND —— 初始化命令，用來讓卡
         * 離開 idle。對一張已經初始化好的卡送它，最好的情況是回 0x00 被
         * 忽略，代價是每次多塊寫入白白多送兩個命令框（CMD55 + ACMD41），
         * 每框都要走一次 select_card() → wait_ready(500)。
         *
         * 這張卡本來就已經在鬧脾氣（reset 鎖卡實測救不回來），沒有理由
         * 在寫入路徑上多送一個語意不對的初始化命令。
         * 直接刪掉 —— 預擦除提示本來就是可選的最佳化，不影響正確性。 */
        if (send_cmd(CMD25, sector) == 0) {
            do {
                if (!xmit_datablock(buff, 0xFC)) break;
                buff += 512;
            } while (--count);
            /* 停止 token：buff 內容不使用，用 dummy 避免傳入 NULL */
            static const BYTE sd_stop_dummy[1] = {0};
            if (!xmit_datablock(sd_stop_dummy, 0xFD)) count = 1;
        }
    }
    deselect();
    return count ? RES_ERROR : RES_OK;
}
#endif

DRESULT SD_disk_ioctl(BYTE pdrv, BYTE cmd, void *buff)
{
    DRESULT res = RES_ERROR;
    BYTE csd[16];
    DWORD cs;

    if (pdrv) return RES_PARERR;
    if (Stat & STA_NOINIT) return RES_NOTRDY;

    switch (cmd) {
    case CTRL_SYNC:                          /* 等寫入完成 */
        if (select_card()) res = RES_OK;
        deselect();
        break;
    case GET_SECTOR_COUNT:                   /* 總磁區數 */
        if (send_cmd(CMD9, 0) == 0 && rcvr_datablock(csd, 16)) {
            if ((csd[0] >> 6) == 1) {        /* CSD v2 (SDHC) */
                cs = csd[9] + ((DWORD)csd[8] << 8) + ((DWORD)(csd[7] & 63) << 16) + 1;
                *(DWORD*)buff = cs << 10;
            } else {                          /* CSD v1 */
                BYTE n = (csd[5] & 15) + ((csd[10] & 128) >> 7) + ((csd[9] & 3) << 1) + 2;
                cs = (csd[8] >> 6) + ((DWORD)csd[7] << 2) + ((DWORD)(csd[6] & 3) << 10) + 1;
                *(DWORD*)buff = cs << (n - 9);
            }
            res = RES_OK;
        }
        deselect();
        break;
    case GET_BLOCK_SIZE:                     /* 抹除區塊大小（磁區）*/
        *(DWORD*)buff = 128;
        res = RES_OK;
        break;
    default:
        res = RES_PARERR;
    }
    return res;
}

/* 逾時改用 HAL_GetTick() 直接計算，本函式保留為相容空殼（可不呼叫）*/
void SD_disk_timerproc(void)
{
    /* no-op：時序不再依賴此函式的呼叫頻率 */
}
