jjjay0826/rocket-system/firmware-rocket/Core/Src/spi.c

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
/* Includes ------------------------------------------------------------------*/
#include "spi.h"

SPI_HandleTypeDef hspi1;
SPI_HandleTypeDef hspi2;

/* SPI1 init function */
void MX_SPI1_Init(void)
{

  hspi1.Instance = SPI1;
  hspi1.Init.Mode = SPI_MODE_MASTER;
  hspi1.Init.Direction = SPI_DIRECTION_2LINES;
  hspi1.Init.DataSize = SPI_DATASIZE_8BIT;
  hspi1.Init.CLKPolarity = SPI_POLARITY_LOW;
  hspi1.Init.CLKPhase = SPI_PHASE_1EDGE;
  hspi1.Init.NSS = SPI_NSS_SOFT;
  hspi1.Init.BaudRatePrescaler = SPI_BAUDRATEPRESCALER_256;
  hspi1.Init.FirstBit = SPI_FIRSTBIT_MSB;
  hspi1.Init.TIMode = SPI_TIMODE_DISABLE;
  hspi1.Init.CRCCalculation = SPI_CRCCALCULATION_DISABLE;
  hspi1.Init.CRCPolynomial = 10;
  if (HAL_SPI_Init(&hspi1) != HAL_OK)
  {
    Error_Handler();
  }
}
/* SPI2 init function */
void MX_SPI2_Init(void)
{

  hspi2.Instance = SPI2;
  hspi2.Init.Mode = SPI_MODE_MASTER;
  hspi2.Init.Direction = SPI_DIRECTION_2LINES;
  hspi2.Init.DataSize = SPI_DATASIZE_8BIT;
  hspi2.Init.CLKPolarity = SPI_POLARITY_HIGH;
  hspi2.Init.CLKPhase = SPI_PHASE_2EDGE;
  hspi2.Init.NSS = SPI_NSS_SOFT;
  hspi2.Init.BaudRatePrescaler = SPI_BAUDRATEPRESCALER_8;
  hspi2.Init.FirstBit = SPI_FIRSTBIT_MSB;
  hspi2.Init.TIMode = SPI_TIMODE_DISABLE;
  hspi2.Init.CRCCalculation = SPI_CRCCALCULATION_DISABLE;
  hspi2.Init.CRCPolynomial = 10;
  if (HAL_SPI_Init(&hspi2) != HAL_OK)
  {
    Error_Handler();
  }
}

void HAL_SPI_MspInit(SPI_HandleTypeDef* spiHandle)
{

  GPIO_InitTypeDef GPIO_InitStruct = {0};
  if(spiHandle->Instance==SPI1)
  {
    /* SPI1 clock enable */
    __HAL_RCC_SPI1_CLK_ENABLE();

    __HAL_RCC_GPIOA_CLK_ENABLE();
    /**SPI1 GPIO Configuration
    PA5     ------> SPI1_SCK
    PA6     ------> SPI1_MISO
    PA7     ------> SPI1_MOSI
    */
    GPIO_InitStruct.Pin = SD_SCK_Pin|SD_MISO_Pin|SD_MOSI_Pin;
    GPIO_InitStruct.Mode = GPIO_MODE_AF_PP;
    GPIO_InitStruct.Pull = GPIO_PULLUP;
    GPIO_InitStruct.Speed = GPIO_SPEED_FREQ_VERY_HIGH;
    GPIO_InitStruct.Alternate = GPIO_AF5_SPI1;
    HAL_GPIO_Init(GPIOA, &GPIO_InitStruct);

  }
  else if(spiHandle->Instance==SPI2)
  {
    /* SPI2 clock enable */
    __HAL_RCC_SPI2_CLK_ENABLE();

    __HAL_RCC_GPIOB_CLK_ENABLE();
    /**SPI2 GPIO Configuration
    PB13     ------> SPI2_SCK
    PB14     ------> SPI2_MISO
    PB15     ------> SPI2_MOSI
    */
    GPIO_InitStruct.Pin = SEN_SCK_Pin|SEN_MISO_Pin|SEN_MOSI_Pin;
    GPIO_InitStruct.Mode = GPIO_MODE_AF_PP;
    GPIO_InitStruct.Pull = GPIO_NOPULL;
    GPIO_InitStruct.Speed = GPIO_SPEED_FREQ_VERY_HIGH;
    GPIO_InitStruct.Alternate = GPIO_AF5_SPI2;
    HAL_GPIO_Init(GPIOB, &GPIO_InitStruct);

  /* USER CODE BEGIN SPI2_MspInit 1 */
    /* ★2026-07-31：把 SPI2 三支腳補上上拉。
     *
     * SPI1（SD）本來就是 GPIO_PULLUP，只有 SPI2 是 NOPULL —— 兩條匯流排
     * 同一顆 MCU、同樣的用法，設定卻不一致，看起來是漏掉而不是刻意的。
     *
     * 真正的理由是 MISO(PB14)：兩顆感測器沒被選到時都會把 MISO 放掉，
     * 這條線就浮著。而已知現象是「BMP 間歇 —— 敲擊 SPI2 焊點可重現」。
     *
     *   浮接 + 焊點接觸不良 → 讀到【隨機值】，而隨機值有機會長得像合法資料
     *                        （WHO_AM_I 剛好撞中、氣壓值看起來還行）
     *   上拉 + 焊點接觸不良 → 讀到【0xFF】，固定、明顯、抓得到
     *
     * 也就是說這個改動不會讓壞掉的焊點變好，但會讓它【壞得誠實】：
     * WHO_AM_I 讀到 0xFF 就是 init 失敗 → mod.bmp585=0 → 不對稱降級
     * 會關掉開傘主路徑退到 C 備援，而不是拿一個假的氣壓值去判高度。
     *
     * SCK/MOSI 是推挽輸出，上拉對它們沒有作用，一起設是為了少一次
     * HAL_GPIO_Init 呼叫、也維持與 SPI1 一致。
     * 速度代價：被選到時感測器主動驅動 MISO，上拉不參與；沒被選到時
     * 沒人在讀。5.25MHz 下不受影響。 */
    GPIO_InitTypeDef pull2 = {0};
    pull2.Pin       = SEN_SCK_Pin|SEN_MISO_Pin|SEN_MOSI_Pin;
    pull2.Mode      = GPIO_MODE_AF_PP;
    pull2.Pull      = GPIO_PULLUP;
    pull2.Speed     = GPIO_SPEED_FREQ_VERY_HIGH;
    pull2.Alternate = GPIO_AF5_SPI2;
    HAL_GPIO_Init(GPIOB, &pull2);
  /* USER CODE END SPI2_MspInit 1 */
  }
}

void HAL_SPI_MspDeInit(SPI_HandleTypeDef* spiHandle)
{

  if(spiHandle->Instance==SPI1)
  {
    /* Peripheral clock disable */
    __HAL_RCC_SPI1_CLK_DISABLE();

    /**SPI1 GPIO Configuration
    PA5     ------> SPI1_SCK
    PA6     ------> SPI1_MISO
    PA7     ------> SPI1_MOSI
    */
    HAL_GPIO_DeInit(GPIOA, SD_SCK_Pin|SD_MISO_Pin|SD_MOSI_Pin);

  }
  else if(spiHandle->Instance==SPI2)
  {
    /* Peripheral clock disable */
    __HAL_RCC_SPI2_CLK_DISABLE();

    /**SPI2 GPIO Configuration
    PB13     ------> SPI2_SCK
    PB14     ------> SPI2_MISO
    PB15     ------> SPI2_MOSI
    */
    HAL_GPIO_DeInit(GPIOB, SEN_SCK_Pin|SEN_MISO_Pin|SEN_MOSI_Pin);

  }
}
