jjjay0826/rocket-system/firmware-rocket/Core/Src/usart.c

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
/* Includes ------------------------------------------------------------------*/
#include "usart.h"

/* USER CODE BEGIN 0 */
UART_HandleTypeDef huart2;
/* USER CODE END 0 */

UART_HandleTypeDef huart1;
UART_HandleTypeDef huart2;

/* USART1 init function */

void MX_USART1_UART_Init(void)
{

  huart1.Instance = USART1;
  huart1.Init.BaudRate = 9600;
  huart1.Init.WordLength = UART_WORDLENGTH_8B;
  huart1.Init.StopBits = UART_STOPBITS_1;
  huart1.Init.Parity = UART_PARITY_NONE;
  huart1.Init.Mode = UART_MODE_TX_RX;
  huart1.Init.HwFlowCtl = UART_HWCONTROL_NONE;
  huart1.Init.OverSampling = UART_OVERSAMPLING_16;
  if (HAL_UART_Init(&huart1) != HAL_OK)
  {
    Error_Handler();
  }
}
/* USART2 init function */

void MX_USART2_UART_Init(void)
{

  huart2.Instance = USART2;
  huart2.Init.BaudRate = 9600;
  huart2.Init.WordLength = UART_WORDLENGTH_8B;
  huart2.Init.StopBits = UART_STOPBITS_1;
  huart2.Init.Parity = UART_PARITY_NONE;
  huart2.Init.Mode = UART_MODE_TX_RX;
  huart2.Init.HwFlowCtl = UART_HWCONTROL_NONE;
  huart2.Init.OverSampling = UART_OVERSAMPLING_16;
  if (HAL_UART_Init(&huart2) != HAL_OK)
  {
    Error_Handler();
  }
}

void HAL_UART_MspInit(UART_HandleTypeDef* uartHandle)
{

  GPIO_InitTypeDef GPIO_InitStruct = {0};
  if(uartHandle->Instance==USART1)
  {
    /* USART1 clock enable */
    __HAL_RCC_USART1_CLK_ENABLE();

    __HAL_RCC_GPIOA_CLK_ENABLE();
    /**USART1 GPIO Configuration
    PA9     ------> USART1_TX
    PA10     ------> USART1_RX
    */
    GPIO_InitStruct.Pin = LORA_TX_Pin|LORA_RX_Pin;
    GPIO_InitStruct.Mode = GPIO_MODE_AF_PP;
    GPIO_InitStruct.Pull = GPIO_NOPULL;
    GPIO_InitStruct.Speed = GPIO_SPEED_FREQ_VERY_HIGH;
    GPIO_InitStruct.Alternate = GPIO_AF7_USART1;
    HAL_GPIO_Init(GPIOA, &GPIO_InitStruct);

    /* USART1 interrupt Init */
    HAL_NVIC_SetPriority(USART1_IRQn, 0, 0);
    HAL_NVIC_EnableIRQ(USART1_IRQn);
  /* USER CODE BEGIN USART1_MspInit 1 */
    /* 啟用 USART1 全域中斷，讓 RX 能透過 ISR 接收命令 */
    HAL_NVIC_SetPriority(USART1_IRQn, 5, 0);
    HAL_NVIC_EnableIRQ(USART1_IRQn);

    /* ★2026-07-31：RX(PA10) 補上拉。
     * UART 線閒置時的定義電位是【高】。CubeMX 產生的是 GPIO_NOPULL，
     * 於是 E22 沒上電、沒插、或 TXD 進高阻的瞬間，這支腳是浮的 ——
     * 浮腳會抓到雜訊，UART 把雜訊的下緣當成 start bit，接著就是一串
     * framing error 和亂位元組，最壞會累積成 ORE。
     * （ORE 在 HAL 裡是【阻塞型】錯誤，會停掉接收；那條路已經由
     *   HAL_UART_ErrorCallback 補起來了，但最好的處理是一開始就不要
     *   讓它發生。）
     * TX 是推挽輸出，上拉對它沒作用，一起設只是省一次呼叫。 */
    GPIO_InitTypeDef rxpu1 = {0};
    rxpu1.Pin       = LORA_TX_Pin|LORA_RX_Pin;
    rxpu1.Mode      = GPIO_MODE_AF_PP;
    rxpu1.Pull      = GPIO_PULLUP;
    rxpu1.Speed     = GPIO_SPEED_FREQ_VERY_HIGH;
    rxpu1.Alternate = GPIO_AF7_USART1;
    HAL_GPIO_Init(GPIOA, &rxpu1);
  /* USER CODE END USART1_MspInit 1 */
  }
  else if(uartHandle->Instance==USART2)
  {
    /* USART2 clock enable */
    __HAL_RCC_USART2_CLK_ENABLE();

    __HAL_RCC_GPIOA_CLK_ENABLE();
    /**USART2 GPIO Configuration
    PA2     ------> USART2_TX
    PA3     ------> USART2_RX
    */
    GPIO_InitStruct.Pin = GPS_TX_Pin|GPS_RX_Pin;
    GPIO_InitStruct.Mode = GPIO_MODE_AF_PP;
    GPIO_InitStruct.Pull = GPIO_NOPULL;
    GPIO_InitStruct.Speed = GPIO_SPEED_FREQ_VERY_HIGH;
    GPIO_InitStruct.Alternate = GPIO_AF7_USART2;
    HAL_GPIO_Init(GPIOA, &GPIO_InitStruct);

    /* USART2 interrupt Init */
    HAL_NVIC_SetPriority(USART2_IRQn, 0, 0);
    HAL_NVIC_EnableIRQ(USART2_IRQn);
  /* USER CODE BEGIN USART2_MspInit 1 */
  /* GPS 降優先序：ISR 內做 NMEA 解析較重，原 prio=0（最高）會搶 USB/LoRa/SysTick */
  HAL_NVIC_SetPriority(USART2_IRQn, 6, 0);

    /* ★2026-07-31：RX(PA3) 補上拉，理由同 USART1。
     * GPS 這一路更需要 —— ATGM336H 冷開機要幾十秒才開始吐 NMEA，
     * 那段時間 TXD 可能還沒被驅動，RX 就是浮的。 */
    GPIO_InitTypeDef rxpu2 = {0};
    rxpu2.Pin       = GPS_TX_Pin|GPS_RX_Pin;
    rxpu2.Mode      = GPIO_MODE_AF_PP;
    rxpu2.Pull      = GPIO_PULLUP;
    rxpu2.Speed     = GPIO_SPEED_FREQ_VERY_HIGH;
    rxpu2.Alternate = GPIO_AF7_USART2;
    HAL_GPIO_Init(GPIOA, &rxpu2);
  /* USER CODE END USART2_MspInit 1 */
  }
}

void HAL_UART_MspDeInit(UART_HandleTypeDef* uartHandle)
{

  if(uartHandle->Instance==USART1)
  {
    /* Peripheral clock disable */
    __HAL_RCC_USART1_CLK_DISABLE();

    /**USART1 GPIO Configuration
    PA9     ------> USART1_TX
    PA10     ------> USART1_RX
    */
    HAL_GPIO_DeInit(GPIOA, LORA_TX_Pin|LORA_RX_Pin);

    /* USART1 interrupt Deinit */
    HAL_NVIC_DisableIRQ(USART1_IRQn);
  }
  else if(uartHandle->Instance==USART2)
  {
    /* Peripheral clock disable */
    __HAL_RCC_USART2_CLK_DISABLE();

    /**USART2 GPIO Configuration
    PA2     ------> USART2_TX
    PA3     ------> USART2_RX
    */
    HAL_GPIO_DeInit(GPIOA, GPS_TX_Pin|GPS_RX_Pin);

    /* USART2 interrupt Deinit */
    HAL_NVIC_DisableIRQ(USART2_IRQn);
  }
}

/* USER CODE BEGIN 1 */
/* MX_USART2_UART_Init 已由 CubeMX 生成（見上方），舊板手寫版移除以免重複定義。
 * GPS 只需接收，生成版為 TX_RX 模式無妨（我們不對 GPS 發送）。*/
/* USER CODE END 1 */
