jjjay0826/rocket-system/sandbox/baro/Core/Src/i2c.c

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
/* Includes ------------------------------------------------------------------*/
#include "i2c.h"

I2C_HandleTypeDef hi2c1;
I2C_HandleTypeDef hi2c3;

/* I2C1 init function */
void MX_I2C1_Init(void)
{

  hi2c1.Instance = I2C1;
  hi2c1.Init.ClockSpeed = 100000;
  hi2c1.Init.DutyCycle = I2C_DUTYCYCLE_2;
  hi2c1.Init.OwnAddress1 = 0;
  hi2c1.Init.AddressingMode = I2C_ADDRESSINGMODE_7BIT;
  hi2c1.Init.DualAddressMode = I2C_DUALADDRESS_DISABLE;
  hi2c1.Init.OwnAddress2 = 0;
  hi2c1.Init.GeneralCallMode = I2C_GENERALCALL_DISABLE;
  hi2c1.Init.NoStretchMode = I2C_NOSTRETCH_DISABLE;
  if (HAL_I2C_Init(&hi2c1) != HAL_OK)
  {
    Error_Handler();
  }
}
/* I2C3 init function */
void MX_I2C3_Init(void)
{

  hi2c3.Instance = I2C3;
  hi2c3.Init.ClockSpeed = 100000;
  hi2c3.Init.DutyCycle = I2C_DUTYCYCLE_2;
  hi2c3.Init.OwnAddress1 = 0;
  hi2c3.Init.AddressingMode = I2C_ADDRESSINGMODE_7BIT;
  hi2c3.Init.DualAddressMode = I2C_DUALADDRESS_DISABLE;
  hi2c3.Init.OwnAddress2 = 0;
  hi2c3.Init.GeneralCallMode = I2C_GENERALCALL_DISABLE;
  hi2c3.Init.NoStretchMode = I2C_NOSTRETCH_DISABLE;
  if (HAL_I2C_Init(&hi2c3) != HAL_OK)
  {
    Error_Handler();
  }
}

void HAL_I2C_MspInit(I2C_HandleTypeDef* i2cHandle)
{

  GPIO_InitTypeDef GPIO_InitStruct = {0};
  if(i2cHandle->Instance==I2C1)
  {
  /* USER CODE BEGIN I2C1_MspInit 0 */
  /* I2C1 bus recovery: 用 GPIO 模擬 9 個 SCL 脈衝，解除 SDA stuck low
   * PB6=SCL, PB9=SDA（Open-Drain + 外部或內部上拉）               */
  {
    __HAL_RCC_GPIOB_CLK_ENABLE();
    GPIO_InitTypeDef r = {0};
    r.Pin   = GPIO_PIN_6 | GPIO_PIN_9;
    r.Mode  = GPIO_MODE_OUTPUT_OD;
    r.Pull  = GPIO_NOPULL;
    r.Speed = GPIO_SPEED_FREQ_LOW;
    HAL_GPIO_Init(GPIOB, &r);
    HAL_GPIO_WritePin(GPIOB, GPIO_PIN_6 | GPIO_PIN_9, GPIO_PIN_SET);
    HAL_Delay(1);
    for (int _i = 0; _i < 9; _i++) {
      HAL_GPIO_WritePin(GPIOB, GPIO_PIN_6, GPIO_PIN_RESET); HAL_Delay(1);
      HAL_GPIO_WritePin(GPIOB, GPIO_PIN_6, GPIO_PIN_SET);   HAL_Delay(1);
    }
    /* STOP condition: SDA low→high while SCL high */
    HAL_GPIO_WritePin(GPIOB, GPIO_PIN_9, GPIO_PIN_RESET); HAL_Delay(1);
    HAL_GPIO_WritePin(GPIOB, GPIO_PIN_9, GPIO_PIN_SET);   HAL_Delay(1);
  }
  /* USER CODE END I2C1_MspInit 0 */

    __HAL_RCC_GPIOB_CLK_ENABLE();
    /**I2C1 GPIO Configuration
    PB6     ------> I2C1_SCL
    PB9     ------> I2C1_SDA
    */
    GPIO_InitStruct.Pin = GPIO_PIN_6|GPIO_PIN_9;
    GPIO_InitStruct.Mode = GPIO_MODE_AF_OD;
    GPIO_InitStruct.Pull = GPIO_NOPULL;
    GPIO_InitStruct.Speed = GPIO_SPEED_FREQ_VERY_HIGH;
    GPIO_InitStruct.Alternate = GPIO_AF4_I2C1;
    HAL_GPIO_Init(GPIOB, &GPIO_InitStruct);

    /* I2C1 clock enable */
    __HAL_RCC_I2C1_CLK_ENABLE();
  }
  else if(i2cHandle->Instance==I2C3)
  {
  /* USER CODE BEGIN I2C3_MspInit 0 */
  /* I2C3 bus recovery: PA8=SCL, PB8=SDA */
  {
    __HAL_RCC_GPIOA_CLK_ENABLE();
    __HAL_RCC_GPIOB_CLK_ENABLE();
    GPIO_InitTypeDef r = {0};
    r.Mode  = GPIO_MODE_OUTPUT_OD;
    r.Pull  = GPIO_NOPULL;
    r.Speed = GPIO_SPEED_FREQ_LOW;
    r.Pin   = GPIO_PIN_8; HAL_GPIO_Init(GPIOA, &r);
    r.Pin   = GPIO_PIN_8; HAL_GPIO_Init(GPIOB, &r);
    HAL_GPIO_WritePin(GPIOA, GPIO_PIN_8, GPIO_PIN_SET);
    HAL_GPIO_WritePin(GPIOB, GPIO_PIN_8, GPIO_PIN_SET);
    HAL_Delay(1);
    for (int _i = 0; _i < 9; _i++) {
      HAL_GPIO_WritePin(GPIOA, GPIO_PIN_8, GPIO_PIN_RESET); HAL_Delay(1);
      HAL_GPIO_WritePin(GPIOA, GPIO_PIN_8, GPIO_PIN_SET);   HAL_Delay(1);
    }
    HAL_GPIO_WritePin(GPIOB, GPIO_PIN_8, GPIO_PIN_RESET); HAL_Delay(1);
    HAL_GPIO_WritePin(GPIOB, GPIO_PIN_8, GPIO_PIN_SET);   HAL_Delay(1);
  }
  /* USER CODE END I2C3_MspInit 0 */

    __HAL_RCC_GPIOA_CLK_ENABLE();
    __HAL_RCC_GPIOB_CLK_ENABLE();
    /**I2C3 GPIO Configuration
    PA8     ------> I2C3_SCL
    PB8     ------> I2C3_SDA
    */
    GPIO_InitStruct.Pin = GPIO_PIN_8;
    GPIO_InitStruct.Mode = GPIO_MODE_AF_OD;
    GPIO_InitStruct.Pull = GPIO_NOPULL;
    GPIO_InitStruct.Speed = GPIO_SPEED_FREQ_VERY_HIGH;
    GPIO_InitStruct.Alternate = GPIO_AF4_I2C3;
    HAL_GPIO_Init(GPIOA, &GPIO_InitStruct);

    GPIO_InitStruct.Pin = GPIO_PIN_8;
    GPIO_InitStruct.Mode = GPIO_MODE_AF_OD;
    GPIO_InitStruct.Pull = GPIO_NOPULL;
    GPIO_InitStruct.Speed = GPIO_SPEED_FREQ_VERY_HIGH;
    GPIO_InitStruct.Alternate = GPIO_AF9_I2C3;
    HAL_GPIO_Init(GPIOB, &GPIO_InitStruct);

    /* I2C3 clock enable */
    __HAL_RCC_I2C3_CLK_ENABLE();
  }
}

void HAL_I2C_MspDeInit(I2C_HandleTypeDef* i2cHandle)
{

  if(i2cHandle->Instance==I2C1)
  {
    /* Peripheral clock disable */
    __HAL_RCC_I2C1_CLK_DISABLE();

    /**I2C1 GPIO Configuration
    PB6     ------> I2C1_SCL
    PB9     ------> I2C1_SDA
    */
    HAL_GPIO_DeInit(GPIOB, GPIO_PIN_6);

    HAL_GPIO_DeInit(GPIOB, GPIO_PIN_9);

  }
  else if(i2cHandle->Instance==I2C3)
  {
    /* Peripheral clock disable */
    __HAL_RCC_I2C3_CLK_DISABLE();

    /**I2C3 GPIO Configuration
    PA8     ------> I2C3_SCL
    PB8     ------> I2C3_SDA
    */
    HAL_GPIO_DeInit(GPIOA, GPIO_PIN_8);

    HAL_GPIO_DeInit(GPIOB, GPIO_PIN_8);

  }
}
