jjjay0826/rocket-system/(commit log)

2026-06-27 Initial monorepo: firmware-rocket, firmware-ground, sandbox, shared protocol
    - firmware-rocket: STM32F411 rocket avionics (rocket_v7), parachute auto-deploy
    - firmware-ground: LoRa ground receiver
    - sandbox/{parachute,baro}: bench-test projects
    - shared/protocol.h: LoRa telemetry contract (extracted from current TX; not yet wired into both ends)
    - .gitignore for STM32CubeIDE build artifacts
2026-06-27 Clear firmware-ground to placeholder; rewrite ground station later
    Previous lora_receiver was a half-baked copy of a sensor project (unused drivers + full CMSIS). Removed contents, kept the folder with a README that points to shared/protocol.h and gives rewrite guidance. Original backup untouched at Desktop/航電程式/lora_receiver.
2026-06-27 docs: annotate LoRa packet as shared protocol in main.c
    Cross-reference shared/protocol.h (RKT_LORA_TX_FMT/RX_FMT); flag manual-sync requirement across main.c snprintf, protocol.h, and firmware-ground parser.
2026-06-28 fix(firmware-rocket): float printf, MISO pull-up, SD init debug log
    - Enable 'use float with printf' (newlib-nano) so telemetry floats print
    - PA6/MISO internal pull-up for SD SPI
    - Log CMD0/CMD8 in 'SD: FAIL' line to diagnose init (currently cmd0=FF)
    [main.c, rocket sensor.ioc, sd_diskio_spi.c, spi.c]
2026-06-29 feat: add SPI configuration and SD card SPI driver implementation
2026-06-29 feat: initialize STM32F411 firmware project with HAL, CMSIS, and USB middleware libraries
2026-06-29 feat: configure SPI1 and SPI2 interfaces and associated GPIO pins in STM32CubeMX
2026-06-30 feat: initialize SD card SPI interface and implement FatFs disk I/O drivers
2026-06-30 chore(sd): re-apply HAL-status check + SPI1 loopback on jx06t HSE base
    - xchg_spi: check HAL_SPI_TransmitReceive() return, record spierr/status/errcode
    (tells a real card no-response from a HAL transfer failure)
    - main.c: SD FAIL line prints spierr/st/ec; add MISO<->MOSI loopback self-test
    before logger_init (diagnostic, removable)
    - sits on jx06t's HSE-25MHz clock (correct for the Black Pill); my obsolete
    HSI .ioc change dropped
    [main.c, sd_diskio_spi.c]
2026-07-01 fix(sd): skip wait_ready before CMD0 so init actually sends it
    Root cause of the long-standing "SD: FAIL cmd0=FF": send_cmd() calls
    select_card()->wait_ready() before every command, spinning until MISO
    reads 0xFF. This module holds MISO low (0x00) right after power-up, before
    the card enters SPI mode, so wait_ready() times out, select_card() fails,
    and send_cmd() returns a HARDCODED 0xFF without ever sending CMD0's 6 bytes.
    That hardcoded 0xFF looks identical to a real "card didn't answer" 0xFF,
    which misdirected days of hardware debugging toward wiring/level-shifter.
    Fix: in disk_initialize send CMD0 as a special case that skips wait_ready
    (CS low, send frame, read R1 directly). After this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
    [main.c, sd_diskio_spi.c]
2026-07-01 fix(rocket): rolling log file, READ no-wipe, LANDED output stall
    - logger: open log<N>.csv (incrementing) each boot instead of overwriting
    log.csv, so past flights are preserved; READ no longer wipes the log
    (re-open with FA_OPEN_APPEND instead of logger_init/CREATE_ALWAYS)
    - main: fix LANDED output fully stopping -- t_out was updated before the
    5s-throttle check so (now-t_out) was always 0; now a dynamic interval
    (500ms normal / 5s LANDED). Bug found by jx06.
    [logger.c, main.c]
2026-07-01 feat(ground): LoRa E22 -> USB CDC telemetry receiver
    New firmware-ground (STM32F411 Black Pill, same pinout as rocket): USART1
    receives the E22 transparent-mode LoRa stream and forwards each line
    verbatim to the PC over USB CDC. Built by copying the rocket CubeMX base
    (HAL/USB/USART1/HSE-25MHz/E22 driver) and stripping flight code:
    - rewrote main.c to a minimal LoRa_Receive -> cdc_write loop
    - removed bmp585/gnss/logger/cmd/sdcard drivers
    - it.c dropped GNSS callback; usbd_cdc_if.c dropped cmd input
    - renamed Eclipse project to "rocket ground" to avoid IDE name clash
    [lora.h, lora_e22.c, lora_e22.h, main.c, main.h, rocket sensor.ioc]
2026-07-01 fix(sd): retry CMD0 on init so reset (no power-cycle) succeeds more often
    After a plain reset the card keeps power and may still be in its last
    busy/write state, so a single CMD0 sometimes fails (the occasional
    MOD=1110). Now retry CMD0 up to 3x, each attempt first sending more wake-up
    clocks (160) + a short delay to let the card settle back to idle.
    Power-cycling remains the reliable path; this just raises the reset
    success rate.
    [sd_diskio_spi.c]
2026-07-01 fix(lora): improve line reception logic and error handling in LoRa_Receive function
    [lora_e22.c, main.c, rocket sensor.ioc]
2026-07-02 fix(rocket): SD reliability + GNSS parsing + sensor liveness + single CDC output
    Bench-verified batch:
    - sd_diskio: data-phase SPI 5.25MHz -> 656kHz (prescaler 16->128). At 5.25MHz
    through the 74HC125 module the CSV showed corrupted bytes (garbled fields);
    at 656kHz a full bench run reads back 100% clean. Throughput need is ~200B/s
    so margin is huge.
    - main: SD init auto-retries every 3s (max 5) instead of one-shot at T+3s;
    first power-on sometimes got a garbled CMD0 response (e.g. 0x3F) from the
    not-yet-settled rail and needed a manual reset -- now it recovers itself.
    - logger/cmd: new TRUNC command trims the 8MB preallocation to real size for
    bench sessions (in flight LANDED st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
    [bmp585.c, cmd.c, gnss.c, logger.c, logger.h, lora_e22.c, main.c, sd_diskio_spi.c]
2026-07-02 chore(ground): drop unused CubeMX leftovers copied from the rocket build
    Remove dead files never referenced by the ground receiver: SPI1/SD diskio,
    TIM, the whole FATFS stack, stray imu.h/lora.h and the rocket CubeMX notes.
    Core/Src is now just gpio/usart/lora_e22/main/it/msp/system.
2026-07-05 feat(sandbox): rebuild parachute test firmware for Black Pill (HSE 25MHz)
    Parachute-deployment bench-test project, regenerated on the WeAct Black
    Pill base (HSE 25MHz). Migrated from the old linked-resource STM32CubeIDE/
    subfolder to a root-level project and removed stale rocket-sensor leftovers
    (.ioc / .launch). Also gitignore *.launch (IDE debug configs).
2026-07-10 feat(rocket): clock fault detection + status-aware 50Hz logging + gyro scale fix
    時鐘故障防護（本日病板事件的直接產物）：
    - HSE 起振失敗 → 自動降級 HSI 84MHz（PLLM8/N168）續跑，不再磚死全暗
    - HSE 正常時啟用 CSS：飛行中晶振失效走 NMI → HAL_RCC_CSSCallback
    重配 HSI 84MHz，UART/SPI 鮑率不變、開傘狀態機不中斷
    - NMI_Handler 改呼叫 HAL_RCC_NMI_IRQHandler（原 while(1) 會卡死）
    - 開機報告新增 CLK=HSE/HSI-FB(HSE FAIL!) 與 RST= 重啟原因鑑識
    （IWDG/POR/BOR/NRST/SFT），Error_Handler 自行初始化 LED 讓早期失敗可見
    記錄系統：
    - CSV 依飛行狀態變頻：IDLE 2Hz / 飛行 50Hz / LANDED 5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
    [cmd.c, gnss.c, logger.c, logger.h, main.c, sd_diskio_spi.c]
2026-07-10 fix(sandbox): parachute CSV persistence hardening + gyro scale sync
    parachute（500Hz IMU 投放測試韌體）：
    - CSV header 建檔即寫入+f_sync 持久，結果檢查、失敗留痕——幽靈開機
    不再留 0-byte 檔(S3)
    - >6g 落地即刻 f_sync 搶救移至純 IMU 路徑（10ms 塊），不受氣壓閘門
    拖累——撞擊瞬間正是 BMP 最易讀值異常的時刻(S4)
    - 週期 sync 16→4 批：斷電尾段損失 2s→0.5s（電池噴飛實證×2）
    - sync 失敗與寫入失敗分流：已入檔資料不再進 retry buffer 重寫成
    64 列重複(C9)
    - CSV 欄位名精確化：vz_ms/imu_hz_m → kf_vz_ms/kf_h_m（兩欄皆 KF2 值）
    - sd_diskio 同步火箭端 656kHz 修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
    [imu_fast.h, main.c, sd_diskio_spi.c]
2026-07-10 chore(ground): prune stale FATFS source entry from .cproject
    66bd4d9 已移除 ground 未用的 FATFS 目錄，IDE 重建時同步清掉
    .cproject 的 FATFS sourceEntry（兩組建置設定各一處）。
2026-07-16 feat(rocket): SPI2 sensor-bus diagnostics + boot clamp health-check
    B 板感測器 VDDIO 鉗位事故（三線被二極體式路徑鉗在 ~1V、SPI 閒置灌 46mA）
    的診斷與防護工具化：
    診斷命令（cmd.c，僅手動觸發、對正常運作零影響）：
    - PINTEST : B13/B15 改 1Hz 方波 GPIO x8，電表看 MCU 推不推得動（分辨
    MCU 輸出級 vs 外部鉗位），完後 NVIC_SystemReset 還原 SPI2
    - PINHOLD : 靜態保持 3x60s 相位（避免電表平均假象），供跨 22Ω 量電流
    - BUSFLOAT: 三線改 analog Hi-Z、CS 拉高維持到重開機（量測/剪腳前防 46mA）
    開機健檢（main.c，每次開機執行）：
    - 三線先當輸入採樣，任一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
2026-07-17 feat(parachute): add LoRa E22 telemetry TX (shared rocket↔ground protocol)
    投放測試韌體加入 LoRa 遙測，地面站（firmware-ground）不改即可同時收本韌體
    與飛行韌體：
    - 複製 firmware-rocket 的 lora_e22.c/.h（逐字節相同，同一透傳驅動）
    - main.c：mod 加 lora 旗標、開機 LoRa_Init()、開機報告加 LORA= 並經 LoRa
    送一份；500ms 遙測送共用協定封包（與 shared/protocol.h 的 RKT_LORA_TX_FMT
    逐字一致）
    - 狀態映射：parachute 無 flight_state，用 land_state → 協定碼
    （LAND_FLIGHT→"LA" / IMPACT→"DP" / LANDED→"DD"）
    - it.c：加 HAL_UART_Tx/RxCpltCallback，依 instance 分派 USART1→LoRa
    設計要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
2026-07-18 feat: implement interactive GPIO features for LoRa control and ignition, and define system status LED indicators
2026-07-18 feat: implement interactive GPIO features for LoRa telemetry toggle, manual ignition, and status LED feedback
2026-07-18 feat(rocket): altitude-gate the 20s backup deploy timer (ground-safety)
    地面安全補強（回應「組裝/搬運晃動誤觸發」疑慮）：
    問題：發射偵測誤判 LAUNCHED 後，20s 備援開傘（deploy_bkup）原為「純計時、
    無高度確認」→ 地面誤判 → 20s 後無條件點火。主觸發(A+B)在地面不會成立，
    但這個純計時備援會照燒，是唯一的地面點火漏洞。
    修法：備援計時器加高度閘門，氣壓計活著時額外要求 peak_rel_alt >=
    DEPLOY_PEAK_MIN_M(20m)——與 cond_A 同一道既有的 20m 防地面誤觸閘門，
    風險姿態一致。地面高度永不爬 → 備援被擋 → 不會地面點火。
    氣壓計死時退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
2026-07-19 feat: implement GNSS drivers and interactive GPIO features for LoRa control, ignition triggers, and status LED indicators
2026-07-19 feat: implement SD card SPI interface and logging framework for firmware system
2026-07-19 feat(rocket): manual deploy command (USB + LoRa) with 2-step arm/fire safety
    手動開傘（人工 override，USB CDC 與 LoRa 上行共用同一安全核心）：
    安全設計（兩段式 + 動態通關碼 + 逾時）：
    - ARM → 回覆動態 4 位碼（HAL_GetTick 產生、每次變動）
    - 限時 10s 內送 'FIRE <碼>'，碼精確吻合才點火；'SAFE' 解除
    - 防單一亂碼/RF 雜訊誤觸、防重放、逾時自動解除、已開傘則拒絕
    - 點火走與自動開傘相同的 DEPLOYING 路徑（共用 2s 脈衝收尾）
    整合：
    - main.c：ManualDeploy_HandleLine(line, reply) 安全核心 + ManualDeploy_Poll()
    （逾時解除）；主迴圈 drain LoRa_Receive → 核心（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
2026-07-19 feat(ground): USB->LoRa uplink for manual deploy commands
    地面端加入上行通道（配合火箭端 8ab576b 的手動開傘 LoRa 路徑）：
    電腦在串口打的整行 → 經 LoRa 送給火箭端 → 火箭端解析 ARM/FIRE/SAFE。
    - usbd_cdc_if.c：CDC_Receive_FS 原本丟棄下行 bytes，改呼叫 Ground_OnUsbRx
    取走本包資料（re-arm 前，USB ISR context 只推 ring）
    - main.c：g_urx ring（ISR 寫/主迴圈讀，無鎖 SPSC）+ Ground_OnUsbRx；
    主迴圈組整行（\r/\n 為界）→ LoRa_SendStr（補 '\n' 給火箭端斷行）
    - 既有下行遙測轉發不受影響（RX 路徑未動）
    ⚠ 這是 jx06 的 firmware-ground，請 review。未編譯未測試。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
2026-07-20 fix(rocket): SD reset-lockup rescue, LoRa RX line loss, remote deploy protocol
    SD (2026-07-20 outdoor test: 4x NRST resets -> SD dead until power cycle):
    - sd_diskio_spi: sd_unstick_card() deep rescue after 3 failed CMD0
    (flush 4096 clocks + 0xFD stop token + CMD12 + wait_ready 500ms), retry 3->5
    - main: reopen circuit breaker - 3 failed rounds (~6s) force logger_mark_failed()
    -> full remount path (fake-success f_open on half-dead card starved it before)
    - main: skip blocking re-init during LAUNCHED/DEPLOYING (deploy-loop safety)
    - main: REINIT FAIL diagnostics (fres+cmd0+cmd8); cmd: close log before
    PINTEST/PINHOLD reset (reset during write locks card until power cycle)
    - logger: prea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
    [cmd.c, logger.c, logger.h, lora_e22.c, main.c, sd_diskio_spi.c]
2026-07-20 fix(rocket): reply REJECT on malformed #CMD instead of silent ignore
    Bench typing a 24-char secret with one wrong char gave zero feedback.
    [main.c]
2026-07-20 feat(rocket): TEST_FIRE bench command - repeatable ignition without reset
    #CMD:TEST_FIRE_SALT7777# fires a bare 2s pulse on PA1 without touching
    flight_state, so the bench cycle is ARM once -> fire as many times as
    needed within the 30s window. IDLE+armed only; flight path stays on dpl.
    [main.c]
2026-07-20 fix(rocket): lora_922_rocket.ini content was still 868.125 - now 922.125/CH72
    Previous commit renamed the file but git mv carried the stale staged
    content; the 922.125 (0x48) + REG1=0x20 edit stayed unstaged.
2026-07-20 feat(rocket): MSG event format, #CMD ARM variant, TEST_FIRE gate relaxed
    - All command replies unified to ground-station spec: MSG <LEVEL> <content>
    (INFO/WARN/ERROR/SUCCESS); deploy success texts match the spec examples
    - ARM also accepted as #CMD:ARM_SYSTEM_SALT7763# (format unification;
    short ARM kept for USB/manual bench use)
    - TEST_FIRE gate relaxed: only LAUNCHED/DEPLOYING blocked - after a bench
    dpl test (state=DEPLOYED) repeat firing no longer requires a reset
    - Auto-deploy event now also sent over LoRa as MSG SUCCESS (was USB-only;
    ground station could only infer it from the ST field)
    [main.c]
2026-07-20 feat(rocket): REMOTE_CMD_UNRESTRICTED bench switch, drop TEST_FIRE
    Per bench-test request: official keys only, gates temporarily off.
    - TEST_FIRE command removed; testing now uses the official dpl/abg keys
    - REMOTE_CMD_UNRESTRICTED (single #define) bypasses all gates and makes
    dpl a bare repeatable pulse (no flight_state change)
    - Guardrails against flying this build: #warning at compile time, and
    MSG ERROR broadcast on USB+LoRa at boot
    - Revert for flight = comment out the #define and rebuild
    [main.c]
2026-07-20 feat(sim): Pioneer-5K thrust curves from 2025-03-25 static test (+-10% variants)
    Converted from 1kHz load-cell data (kgf) to RASP .eng: 28-point resample,
    impulse error 0.5% vs raw integral (4912 vs 4886 N*s burn-window).
    Dimensions/masses match the TASA Pioneer_5K definition (136x590mm,
    empty 8.70kg). _p10/_m10 scale thrust and propellant by +-10% for
    DEPLOY_TB_MS sensitivity analysis in OpenRocket.
2026-07-20 feat(rocket): DEPLOY_TB_MS 20s -> 18s per thrust-sensitivity simulation
    Pioneer-5K measured curve +-10% envelope (wind effect <0.1s, excluded):
    apogee 16.1-17.95s. Backup fire at ~LAUNCHED(1.9s)+18 = 19.9s gives
    +1.9s ascent-guard margin vs latest apogee, and cuts worst-case backup
    deploy speed from 48 to 35 m/s.
2026-07-20 docs(rocket): correct TB rationale with measured LAUNCHED trigger time
    State-by-state verification against the +-10% envelope showed the 2.5g
    +200ms trigger completes at ~1.3s (thrust ramp is steep), not the 1.9s
    estimate: C fires at ~19.3s = latest apogee +1.34s / earliest +3.2s.
    On the +10% end C beats the A&B main path by 0.2s and deploys at 12 m/s
    (benign cross-protection); actual deploy speed is <=14 m/s on both ends.
    [main.c]
2026-07-20 docs(rocket): E28 2.4GHz B-board migration checklist
    Dual-band redundancy plan (A=E22 922MHz, B=E28 2475MHz) finalized after
    cross-validation: 8-wire hookup (M2 pull-up to 3V3 mandatory), module
    config, zero firmware changes, LP0002 notes (500kHz BW question open),
    decoupling ladder, inter-TX interference measures, bench/pre-flight
    test list. Also corrects the 22-ohm igniter myth (path has no series R).
2026-07-21 feat(rocket): auto-inflate airbag on splashdown (impact + LANDED backup)
    Airbag (PA0) now fires automatically after touchdown/splashdown, not only by
    remote abg command. Two-layer trigger via airbag_fire_auto (one-shot flag):
    - primary: impact detection (total_g over 5g in DEPLOYED) fires the instant
    it hits water, because water-surface bobbing keeps total_g agitated so the
    LANDED still-for-10s condition may never latch at sea
    - backup: on LANDED transition, in case impact was too soft to detect
    Open items: IMU-dead defeats both (both use total_g); 5g threshold needs
    splashdown-test calibration; confirm airbag is pyro (1s pulse ok) vs pump.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
2026-07-21 feat(tools): sim_replay.py - OpenRocket CSV to LoRa telemetry replayer
    Feeds the ground station with realistic downlink when no rocket is flying: parses OpenRocket export (data + events), interpolates to 2Hz, emits packets byte-identical to firmware format (T../AX../ST:/MOD:/GPS:/LAT..) with sensor noise, walks the 5-state flight state machine from sim events, and sends the deploy MSG SUCCESS line. Out via a second E22 on USB-TTL (--port), --dry to preview, --speed/--loop supported; com0com virtual pair works as a zero-hardware fallback.
    [sim_replay.py]
2026-07-21 feat(rocket): BRIDGE mode - rocket board doubles as USB-to-LoRa dongle
    BRIDGE command turns the board into a transparent USB CDC to LoRa forwarder so tools/sim_replay.py can feed the ground station without a separate USB-TTL adapter. Every received line is forwarded verbatim over LoRa; own 2Hz telemetry is muted (cmd_bridge_active) so only replayed data goes on air. EXITBRIDGE or reset leaves the mode. CMD_BUF_SIZE 128 to 192 to fit ~150-char telemetry lines.
    [cmd.c, cmd.h, main.c]
2026-07-21 fix(rocket): mute USB telemetry too in BRIDGE mode (was LoRa-only)
    BRIDGE previously muted only the LoRa telemetry; the USB human-readable stream kept scrolling, contradicting the 'Own telemetry muted' message and burning CPU on cdc_write with no reader (sim_replay only writes). Now the whole t_out block is skipped in BRIDGE mode.
    [main.c]
2026-07-21 feat: initialize STM32F4 firmware project with HAL, CMSIS, USB, and FatFs support
2026-07-21 fix(rocket): BRIDGE dropped every line - CRLF empty line clobbered pending
    sim_replay sends lines ending in \r\n. cmd_handle_char completes a line on
    either \r or \n, so each line produced TWO pending entries: the real data
    (on \r) then an empty string (on \n). The single-slot pending_cmd got
    overwritten by the empty line before the main loop consumed it, so BRIDGE
    forwarded nothing - ground FT232 RX never blinked. Manual CR-only typing
    dodged it, CRLF hit it. Fix: only set cmd_pending when the line is non-empty.
    [cmd.c]
2026-07-21 fix(rocket): BRIDGE fix v2 - empty line still wiped pending content
    v1 (3efa383) gated only the cmd_pending flag; the unconditional
    pending_cmd[jj]=0 still wiped the just-stored line when the \n of a CRLF
    pair arrived microseconds later in the same ISR burst. Main loop then saw
    flag=1 with empty content and forwarded nothing (ground FT232 RX still
    dark). Now the copy AND the flag are both inside the non-empty check;
    an empty line only resets the input buffer.
    [cmd.c]
2026-07-21 feat(tools): sim_replay --st12 mode for the 12-stage ground timeline
    Default output stays byte-faithful to current firmware (5 states). --st12
    switches ST: to the approved st.md scheme: 12 linear codes where events
    (2 IGNITION / 4 BURNOUT / 6 APOGEE / 7 DEPLOY / 9 TOUCHDOWN / 10 AIRBAG)
    take over the field for 4 frames then fall back to the phase code, letting
    the new ground-station timeline be developed against realistic bursts
    before the rocket firmware implements the scheme. Sequence unit-tested
    against 5k_0_h.csv events.
    [sim_replay.py]
2026-07-21 feat(tools): sim_replay launch-site/heading override for real map display
    --lat0/--lon0/--heading rotate the OpenRocket relative displacement
    (Position East/North) onto the requested downrange heading and project it
    from the real launch site, so the ground-station map shows the actual
    scenario (Xuhai 22.174847,120.892723 heading east over the Pacific)
    instead of the CSV-baked site. Without the flags the CSV-native lat/lon
    is used unchanged.
2026-07-21 feat(tools): sim_replay emits airbag MSG on ground hit (both modes)
    Matches the new firmware airbag_fire_auto behavior: MSG INFO Airbag
    inflation started (auto splashdown) at GROUND_HIT. OpenRocket has no
    post-splashdown data, so replay keeps broadcasting the frozen landing
    point for 30s (beacon phase) - enough for the ground station to exercise
    TOUCHDOWN/AIRBAG/LANDED display in both 5-state and --st12 modes.
2026-07-21 feat(tools): sim_replay realistic GPS noise (random walk + jitter)
    Straight-line track complaint root-caused: old sims (single-axis wind)
    genuinely fly out and drift back along one line - the projection was
    faithful. New sim (5k_0_r) has crosswind so the track is a real 2D arc
    (N +381m at apogee curving back to 0 at splashdown). On top, GPS output
    now carries a clamped +-5m random walk plus ~1.2m per-fix jitter so the
    map track looks like a real receiver, not a math curve.
    [sim_replay.py]
2026-07-21 feat: implement bidirectional LoRa-to-USB bridge and configure standard interrupt handlers
2026-07-21 feat: implement bidirectional bridge between USB CDC and E28 LoRa module via UART ring buffers
2026-07-24 feat: remote RECAL command - baro zero re-calibration from ground station
    #CMD:RECAL_SALT5566# re-zeros ref_press (8-sample average) + resets both
    Kalman filters. Gated to FLIGHT_IDLE only - an in-flight re-zero would
    corrupt the altitude baseline that deploy logic depends on, so this gate
    is NOT bypassed even by REMOTE_CMD_UNRESTRICTED. Replies MSG SUCCESS with
    the new reference or MSG ERROR when BMP has no valid pressure.
    Pairs with ground station /cal /cal_all + 校準 ALL button.
    [main.c]
2026-07-25 feat: pyro power monitoring via ADC (fuse health + arming verification)
    Two voltage taps on the pyro rail, read through PB1/PB0 (ADC1_IN9/IN8), the
    only free ADC-capable pins on this board:
    PB1 = after the fuse -> is the fuse intact?
    PB0 = after arming sw -> is the rocket actually armed?
    Why the fuse tap matters: with a safety shunt fitted, an accidental trigger
    sends the current through the shunt instead of the igniter - nobody gets hurt,
    but it blows the fuse and kills the whole pyro rail. A blown fuse looks
    identical to a good one, so without this the failure is only discovered at
    apogee when the chute does not fire. 0V here is the evidence.
    Why the arming tap matters: competi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
    [main.c]
2026-07-25 feat: LoRa channel switching over the air (#CMD:SETCH_nn#)
    Rule 4.1.4.3 requires proving the link works on more than one channel so teams
    do not collide on finals day. With M0/M1 strapped to GND the only way to retune
    is to pull the module and drive it from a USB-TTL adapter - not something you
    can do on the pad. This adds LoRa_SetChannel(): drive M0/M1 high, write
    register 05H via C0 05 01 <ch>, verify the C1 echo, drop back to transparent
    mode and re-arm the IT receiver.
    Frequency = 850.125 MHz + ch, so ch=72 is the 922.125 MHz we fly today.
    Pin reuse - no new pins needed:
    PB7 (was SIG_1, the disable-LoRa jumper, now retired) -> M0
    PB5 (was SIG_3, never used at all)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
    [lora_e22.c, lora_e22.h, main.c]
2026-07-25 refactor: retire the PB7 disable-LoRa jumper (it would have killed telemetry)
    The SIG_1 jumper let you ground PB7 to silence LoRa. That pin is now the E22 M0
    mode line - and in transparent mode M0 sits LOW. So the moment LORA_MODE_PINS is
    enabled, the old check reads 'user asked to disable' and the rocket stops
    transmitting entirely. Silent, total downlink loss.
    Removed all three read sites. There is no flight reason to switch off the only
    downlink anyway; BRIDGE mode already covers the case where the air interface has
    to be freed for replayed data.
    The B10 indicator now follows actual TX activity (blink = downlink in progress)
    instead of the jumper state, which is more informative than wh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
2026-07-25 fix: gate pyro ADC behind PYRO_ADC_FITTED (unfitted pins would lie)
    Without the divider soldered, PB0/PB1 float and the ADC returns noise - which
    can land near 0V and make the ground station cry 'FUSE BLOWN', or land high and
    claim the rocket is ARMED. A confident wrong answer about pyro state is worse
    than no answer.
    Disabled by default: the ADC is not initialised, VF/VA stay -1, and the ground
    station treats -1 as 'this board has no such sensor' and shows nothing. Enable
    by uncommenting once the two divider networks are actually fitted.
    Both build configurations cross-compile clean.
    [main.c]
2026-07-27 fix: bound SETCH channel parsing; warn on out-of-band channel
    Overflow: the digit loop had no length cap, so 'ch = ch*10 + d' wrapped on
    uint32. #CMD:SETCH_4294967368# wraps to exactly 72 and sailed past the
    'ch > 80' check. Verified against a faithful model of the old and new parsers:
    old accepts it as 72, new rejects it. Capping at 3 digits makes overflow
    impossible, and a 4th digit now lands on a non-'#' character so it is rejected
    by the existing check.
    Band advisory (warn only, not enforced - per user's call to keep the full
    0..80 range available): NCC LP0002 permits 920-925MHz, i.e. CH70-74. Anything
    outside that now replies with a warning and proceeds. The ground station logs
    the sam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
    [main.c]
2026-07-27 fix: pyro REJECTs name their command; ADC failure no longer reads as 0V
    From the multi-agent review (18 raised, 16 refuted, these survived).
    REJECT messages now carry dpl/abg. Every rejection used to read identically, so
    the ground station could only match on channel - a RECAL rejection would clear a
    pending deploy confirmation and label the red alert 'DPL REJECTED'. Naming the
    command is the only place this can be fixed properly; matching on wording alone
    cannot separate dpl from abg when both are pending.
    'already deployed' reworded to 'REJECT dpl - already deployed (chute is already
    out)'. Semantically that reply is good news, and in the flight build the 2nd-4th
    burst frames always hit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
    [main.c]
2026-07-27 doc: launch day operating reference
    Everything needed on the pad in one printable page: the three build switches and
    which one blocks flight, how to read the boot banner, every ground station
    command, what each LED colour and status glyph means, the deploy logic with the
    verified +-10%% timing margins, and a pad checklist.
    All values were read out of the source rather than recalled - constants from
    main.c, the command list from the /help string, LED colours and glyphs from
    check_heartbeats, COM ports from settings.json.
2026-07-28 feat: put the TX sequence number in the telemetry packet (SQ)
    The rocket has always counted lora_seq, but it only ever went to the USB
    console - the packet never carried it, so the ground station's lora_seq column
    sat at 0 and link quality could not be measured at all. That is what made the
    earlier '38%% packet fragmentation' scare impossible to settle from the data.
    One field, no new hardware: the receiver sees a gap in the sequence and knows
    exactly how many frames the RF link dropped.
2026-07-28 feat: enable PYRO_ADC_FITTED and LORA_MODE_PINS (hardware is fitted)
    User confirms both divider networks are soldered and M0/M1 are cut from GND and
    wired to PB7/PB5 on both boards. Rail voltages (VF/VA) and /setch now go live.
    Also closes a boot-time transient this exposed: CubeMX's gpio.c leaves PB7 as
    input-with-pullup (it used to be the SIG_1 jumper), so between MX_GPIO_Init and
    LoRa_Init - with the 1-second USB enumeration delay in between - M0 reads high
    and M1 low, parking the E22 in WOR transmit mode for over a second. Harmless in
    practice since nothing transmits then, but there is no reason to let the module
    sit in an unintended mode at boot. LoRa_ModePinsInit() is now called early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
2026-07-28 fix(safety): ground self-ignition, blind barometer, and dead clock failover
    Three findings from the full audit. Verified by extracting the decision
    expressions and driving them through the failure scenarios (20/20 pass).
    FINDING 2 - a single SPI2 solder joint could fire both pyro channels on the
    ground. The boot self-check clamps the bus and skips IMU+baro init (both share
    SPI2), leaving mod.bmp585=0 forever. The degraded path reads that as "both
    sensors dead, I must be flying", declares launch at T+60s, and the backup
    deploy's ternary opens fully because the baro is "dead" - PA1 at T+78s. Land
    detection is then trivially true on a stationary bench, so PA0 follows at
    T+89s. Every power-on r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
    [main.c]
2026-07-28 fix(safety): recover the chute after an in-flight reset, without persistent memory
    Finding 4 of the full audit. A reset in flight - impact power interruption,
    which this vehicle has already logged as BROWNOUT/POWER-ON in its reset flags -
    drops flight_state back to IDLE. Re-detecting launch needs 2.5g for 200ms, but
    the motor burned out long ago and both coast and descent sit at or below 1g, so
    the board can never return to LAUNCHED. The 18s backup never starts counting
    and the chute never fires. The other board is unaffected, but that halves the
    redundancy exactly when it is needed.
    The obvious fix - persist the state - does not actually work here. RTC backup
    registers share VDD on this bo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
    [main.c]
2026-07-28 fix(safety): gate airbag auto-fire behind actually having flown, add ground test mode
    Finding 1 of the full audit. The bench procedure the HELP text teaches -
    ARM then FIRE - walks the state machine DEPLOYING -> DEPLOYED -> (10s of
    stillness) -> LANDED, and LANDED calls airbag_fire_auto(). On a stationary
    bench total_g sits at 1.00 and rel_alt at 0, so the landing condition is
    trivially true. The second pyro channel fires eleven seconds after a test the
    operator thinks only involves the chute - and cmd.c's warning says "igniter",
    singular, so there is no reason to have disconnected the airbag one.
    (The audit also claimed this permanently disabled sea-landing inflation.
    That part was wrong: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
    [main.c]
2026-07-28 fix: landing detection must not trust a dead sensor's stale reading
    total_g and press/rel_alt are declared outside the main loop, so once a sensor
    dies they simply hold whatever was last read successfully - and the landing
    check used those values without asking whether the sensor was still alive.
    Worst case: the barometer never comes up at boot but the IMU does, so the
    rocket launches and deploys normally. rel_alt is then pinned at 0, and under
    canopy total_g sits at about 1.0 - both halves of the landing condition are
    satisfied for the whole descent. Ten seconds later the board declares LANDED
    several hundred metres up and inflates the airbag in mid-air. LANDED is also
    terminal, so logging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
    [main.c]
2026-07-29 fix: stop a dead barometer from handing the chute to a drifting IMU
    The sensor-failure degradation treated both sensors as interchangeable:
    lose either one and the surviving condition was forced true so the other
    could deploy alone. The two directions are not equivalent.
    cond_A is the bare barometric "10 m below peak". No integration, no drift.
    peak_rel_alt is a monotonic latch, so a spurious high reading only raises
    the threshold - it delays deployment, never advances it. The baro path also
    carries a jump gate, an anti-lockup re-anchor and a freeze watchdog. It can
    be trusted alone, and still is.
    cond_B is not comparable. It reads kf2_v, which is IMU integration corrected
    by the barometer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
    [cmd.c, main.c]
2026-07-29 chore: track drop_analysis.py, ignore Python bytecode caches
    drop_analysis.py has been sitting untracked since 2026-07-17. It regresses
    the steady-state segment of the barometric altitude to get descent rate
    straight from pressure, bypassing KF, attitude and the accelerometer - the
    cleanest measurement path available for a drop test - and detects release,
    inflation and touchdown from g_tot alone. Worth keeping.
    Running the tools/ scripts leaves __pycache__ behind, which showed up as
    untracked noise on every status check.
    [drop_analysis.py]
2026-07-29 docs: protocol.h described a packet format that stopped existing in June
    shared/protocol.h documented "N=%lu T=%lu P=.. RH=.. KH=.. G=.. S=ID|LA|DP|DD
    M=1111\n". The real packet has no "=" separators, no two-character state code,
    a hex nibble instead of four decimal digits for the module flags, ends in \r\n
    rather than \n, and carries fourteen fields the header never mentioned - three
    axes of acceleration, three of angular rate, sequence number, KF velocity, GPS,
    deploy conditions, and two pyro rail voltages. A parser written from the old
    header would decode nothing at all.
    firmware-ground/README.md carried the same dead format and told whoever rewrote
    the receiver to #include the header an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
2026-07-29 docs: launch-day manual - wind go/no-go, the new deploy rules, what the 81 sims say
    The manual predated three things that change what an operator does on the pad.
    Wind. The recovery zone runs 2812 m east and 52 m west, so only the east wind
    component matters, and every 1 m/s of it moves the landing point 100-150 m
    toward land against a no-wind offset of just 400-600 m. At 4 m/s, four of nine
    thrust/angle combinations land behind the pad - where people are - which is
    worse than merely leaving the zone. There is now a printable go/no-go card:
    under 1.5 m/s go, 1.5-2.5 m/s go with the bend pointed east and the rail at the
    low end of tolerance, above 2.5 m/s stop. Those are ground readings; the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
2026-07-30 docs: pad checklist must verify ST:0, not just altitude
    The state machine has no path back to IDLE. If launch detection false-fires
    before the real launch - a hard knock during assembly reaching 2.5g for 200ms -
    flight_state latches to LAUNCHED and t_fly starts accumulating. On the pad
    nothing happens, because the backup path also requires peak_rel_alt >= 20m and
    the altitude never climbs.
    Then the real launch happens. Altitude crosses 20m 2.05-2.20 s after ignition at
    39-46 m/s, and by then t_fly is far past the 18 s backup timer. The chute comes
    out during boost.
    The revocation logic added on 2026-07-28 does not cover this: it only revokes
    launches that were *inferred* from both sensors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
2026-07-30 tools: compute descent rate from ground-station CSV for rule 4.2.3
    The organizers will ask for evidence that splashdown stayed under 12 m/s and
    there was no way to produce it. drop_analysis.py reads the on-board SD CSV,
    which has different column names and, more to the point, cannot be relied on -
    the reset-lockup recovery was tested and did not work. The telemetry CSV the
    ground station writes is the record that will actually exist.
    It regresses rel_height against time over the steady descent rather than
    averaging the vz column. Terminal descent is constant velocity, so altitude
    against time is a straight line and its slope is the answer - and rel_height is
    the raw barometric field, so tha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
    [descent_rate.py]
2026-07-30 fix: remove the both-sensors-dead launch inference; 60 s of uptime is not altitude
    If both sensors were dead and the board had been powered for 60 s, the firmware
    declared launch and fired the chute 18 s later. The stated evidence was the
    timer, and the timer proves nothing - a normal pad sequence sits powered for far
    longer than a minute. What actually gated it was "both sensors dead", and that
    happens on the ground too: BMP585 and the IMU share SPI2, and SPI2 solder joints
    are this vehicle's demonstrated weak point - the outdoor flight showed
    intermittent BMP behaviour reproducible by tapping. The longer it sits on the
    rail in sun and wind, the better the odds. Then the chute fires 78 s af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
    [main.c]
2026-07-30 docs: the switch table listed two switches as off that have been on since 07-27
    PYRO_ADC_FITTED and LORA_MODE_PINS were enabled on 2026-07-27 once the dividers
    were soldered and M0/M1 were rewired. The manual still showed both as off and
    "enable after the hardware is done", which invites someone to turn them back off
    on the assumption that on was a mistake. Turning them off loses fuse and arming
    rail voltage (VF/VA) and remote channel changes.
    Only REMOTE_CMD_UNRESTRICTED still needs action, and its line number had moved
    from 616 to 738. Added the check that actually confirms it: the build stops
    printing the NOT FLIGHT SAFE warning.
    Boot report: VF/VA were documented as "-1.00 normal, ADC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
2026-07-30 docs: drop the fixed sentinel entry; add the unverified-on-hardware caveat
    The sentinel poisoning line was replaced in troubleshooting but survived in the
    known-issues appendix. Removed, and the two things that genuinely remain open
    added in its place: the one simulation case that lands 27 m outside the western
    boundary, and the fact that nothing changed today has run on a board.
2026-07-30 docs: work the 8/1 forecast through the landing model
    Windy has ENE-leaning-east at 2 m/s on the ground for 13:00. That is 1.96 m/s of
    east component, which lands in the amber band of the go/no-go card, and 3.1-3.5
    m/s of effective wind under the canopy once the shear factor is applied.
    All nine thrust/angle combinations stay inside the recovery zone, but the margins
    split hard by rail angle: 153 m at 79 degrees against 43 m at 81. Same wind, same
    motor - three and a half times the margin for a two degree change that costs
    nothing. Worth stating as a number rather than as the general advice to favour
    the low end of tolerance.
    At this wind a westward airframe bend of 1 degree puts T110_e81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
2026-07-30 docs: re-derive the manual's flight numbers from 3.0.8
    The airframe changed and every number in the manual was still from 3.0.5(short).
    3.0.8 apogees about 12% lower, which shortens the coast by roughly 0.7 s, and
    both effects push in the safe direction.
    Backup margin: 0.58 s -> 1.29 s, so the timer clears apogee by more than twice
    the old figure and the "only 3.1% of coast time away from an ascent-phase
    deployment" concern is gone.
    The backup also stops being the primary. It beat A∧B in 25 of 81 cases before
    and does so in 6 now, all of them the +10% motor - T090 and T100 are 0/27 each.
    A nominal motor now goes through A∧B every time, which makes a backup-timer
    message a much stronger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
2026-07-30 fix: five paths that could have cost the vehicle, three of them found by a second reviewer
    A fault handler that hangs, a button that fires both igniters unconditionally,
    a UART error that permanently deafens the uplink, a bridge mode with no way out
    once USB is gone, and maintenance commands that block the deploy loop for three
    minutes.
    --- fault handlers reset instead of hanging -------------------------------
    HardFault, MemManage, BusFault and UsageFault were all `while (1) {}`, and no
    watchdog is enabled anywhere - HAL_IWDG_MODULE_ENABLED and HAL_WWDG_MODULE_ENABLED
    are both commented out and the .ioc configures neither. So any fault in flight
    parks the MCU forever: no deploy, no backup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
    [cmd.c, cmd.h, gnss.c, gnss.h, lora_e22.c, lora_e22.h, main.c, verify_audit_20260731.py]
2026-07-30 fix: second audit pass - every SD row was being truncated, and four smaller ones
    Finished reading lora_e22.c and cmd.c, then swept the rest for unbounded string
    work, unbounded busy-waits, blocking calls on flight-reachable paths, and ISR
    state without volatile.
    --- every SD log row lost its tail, including the newline -----------------
    main.c builds a 25-column row into char csv[256]. logger_write copied it into
    char line[128] with a "[hhmmss] " prefix. A typical flight row is 135 bytes, 144
    with the prefix; worst case 164. So every single row was truncated.
    What got cut is the tail: condA, condB, peak - the deploy-decision diagnostics,
    the columns you would actually go to the SD card fo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
    [gnss.c, logger.c, lora_e22.c, main.c, verify_audit_20260731.py]
2026-07-30 docs: what to check after reflashing tonight's changes
    Six firmware fixes land in the same rebuild as REMOTE_CMD_UNRESTRICTED, so the
    manual now says what to verify and, more usefully, what is supposed to look
    different. Maintenance commands being rejected in flight is intentional; PB6
    doing nothing is intentional; SD rows suddenly having line endings is the bug
    being gone.
    Also lists the four protections that now work without anyone doing anything,
    because the failure they cover is invisible until it matters - a hard fault used
    to park the MCU with no watchdog to catch it, a UART overrun used to deafen the
    uplink while telemetry kept flowing, BRIDGE left on meant a silent flight, and an
    un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
2026-07-31 fix: the barometer freeze recovery was probably doing nothing
    The freeze watchdog fires when 50 consecutive raw reads are bit-identical and
    calls BMP585_Init, which reads CHIP_ID and writes two configuration registers.
    A stuck state machine does not come back from a register write, so the one
    recovery path aimed at exactly that failure most likely never recovered
    anything. The Yilan flight lost MOD and never got it back, which fits.
    BMP5 has the standard Bosch soft reset - CMD 0x7E, value 0xB6 - and it was
    unused. Added as BMP585_SoftReset and called before the re-init.
    Deliberately not in the boot path. At boot the chip is in a known state, so a
    reset there only adds a way to fail, and th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
    [bmp585.c, bmp585.h, main.c]
2026-07-31 feat: airbag removed - parachute now fires PA0+PA1 together
    Hardware change 2026-07-31: the airbag is not flying. PA0 (formerly the
    airbag channel, 7V_OUT1) has been wired in PARALLEL with PA1 onto the
    same parachute igniter, for redundancy and more igniter current.
    Parallel wiring is why this is a safety fix rather than tidying: every
    path that used to pull PA0 alone now fires the parachute.
    airbag_fire_auto() impact detection DEPLOYED + total_g > 5g -> chute
    airbag_fire_auto() LANDED backup still 10s below 30m -> chute
    remote /abg operator types it -> chute
    PB6 button IDLE+ARM+GNDTEST -> chute
    A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
    [main.c]
2026-07-31 fix: nothing in either firmware should hang where a reset would recover
    Audit of the blocks never reviewed before: firmware-ground in full, the SD
    SPI driver, and the CubeMX peripheral layer.
    firmware-ground - five places that hang forever
    HardFault/MemManage/BusFault/UsageFault/NMI were all while(1){}, and
    Error_Handler was __disable_irq() + while(1). All now reset first.
    This board is the only reliable data path left - the SD card has been
    measured as unrecoverable after a reset-during-write. When it hangs, the
    COM port is still there, the file is still there, no error is reported,
    and data simply stops arriving. On the pad that is indistinguishable
    from "the rocket is out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
    [lora_bridge.c, main.c, sd_diskio_spi.c, spi.c, usart.c]
2026-07-31 feat: replay a 3.0.9 simulation straight into the ground station
    tools/sim_replay.py had gone stale, and stale in the worst way - it still
    runs, it just feeds the wrong thing:
    - packets carry no SQ / VF / VA, so the link-quality column stays blank
    - it still sends "Airbag inflation started"; the airbag went on 07-31
    - --st12 emits the twelve-state codes the firmware never implemented, so
    ST lands outside 0-4
    - acceleration goes in AZ, but the board is mounted vertically with sensor
    -X up. A real rocket at rest reads AX ~ -1, AZ ~ 0. Feeding AZ=1 makes the
    display show the rocket lying flat - it would have shown the axis fix
    working while proving nothing.
    Left it alo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
    [replay309.py]
2026-07-31 feat: run the firmware's actual deploy decision over the simulation data
    replay309.py hands the ground station an ST value read straight out of
    OpenRocket's recoverydevicedeployment event. That exercises the display, and
    nothing else - the firmware's (A AND B) OR C never runs.
    an309.py estimated the A-AND-B time analytically instead: sqrt(2*10/g) for
    the 10m drop, 1.5s for the sustained negative velocity, 1.55s whichever way.
    No filter, no sensor noise.
    This implements the rules from main.c line by line - 2.5g held 200ms for
    launch, the two-state Kalman at 100Hz predict / 50Hz baro update with the
    high-g R inflation and the 5m reset gate, bare-baro peak tracking for A,
    kf2_v under -0.5 for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
    [fw_logic.py]
2026-07-31 docs: 3.0.9 simulation results, and the open defect list for launch day
    The 3.0.9 matrix tooling was living in a scratchpad. Moved into tools/ with
    the hardcoded temp paths replaced by repo-relative ones, so analyse_309.py
    regenerates doc/sim309_analysis.txt and doc/sim309_81cases.csv in place.
    3.0.9 improves on 3.0.8 everywhere: smallest backup margin 1.29 -> 1.69s,
    C-fires-first 6/81 -> 0/81, westernmost -48m -> +19m, critical east wind
    4.0 -> 4.6 m/s. All nine forecast combinations land inside the zone with
    122-191m to the western boundary.
    launch_day_reference.md still quotes 3.0.8 throughout. Rather than rewrite it
    hours before a launch, it now carries a note saying so - the old numbe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
    [sim309_81cases.csv]
2026-08-01 docs: how each of the eleven stage rows is derived, and retire the airbag section
    Two gaps found by asking where the procedure lives.
    The pre-launch procedure was already there - part one for what has to be done
    before leaving, part eight for the pad sequence. What was missing is how to
    read the screen those procedures point at.
    The rocket has five states; the display shows eleven. Nothing documented which
    six the ground station infers, or from what. Now tabled: the firmware's own
    test for each of its five, and for each derived row the telemetry field and
    rule behind it. Two of them are easy to misread and are called out:
    IGNITION is measured, not back-calculated. The rocket cannot see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
2026-08-01 fix: turn off all three compile switches - two described hardware that was never fitted
    REMOTE_CMD_UNRESTRICTED was always going to be turned off before flight; it
    leaves remote deploy with no gate at all - no ARM required, any flight state,
    repeatable. Off now, so the three gates come back: ARM first while IDLE,
    rejected for 10s after liftoff, rejected once deployed or landed. The
    #warning it emits is the check that it actually went off.
    The other two are the finding. Both claimed hardware work dated 2026-07-27
    that was never done.
    PYRO_ADC_FITTED said the 22k/10k dividers were fitted. They are not. PB0/PB1
    were reading a floating pin - 0.0 to 0.5V - and anything under 5.0V is
    "fuse blown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
    [lora_e22.c, main.c]
2026-08-01 docs: explain what ARM actually gates
    ARM was referenced throughout the manual without ever being defined. The
    part that matters is that only one of the three deploy paths requires it.
    FIRE <code> needs all five: armed, inside the window, exact four-digit match,
    not already deploying or deployed, not landed. /dpl only needs ARM while
    IDLE - in flight it is gated by the ascent guard and the already-deployed and
    landed checks instead, because it is the only emergency recovery there is and
    demanding two steps costs 1.4s when it is most needed. PB6 needs IDLE and ARM
    and ground-test mode together.
    Also documented that the window length is dynamic and reads the current
    flight_state, not the sta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
2026-08-01 feat: ground testing is repeatable inside the ARM window
    Turning off REMOTE_CMD_UNRESTRICTED made /dpl drive the real state machine,
    which meant one shot per power-up: IDLE to DEPLOYING to DEPLOYED to LANDED,
    and LANDED is terminal. Everything after that came back as already deployed
    or already landed. A bench test needs more than one - metering both pins,
    checking the uplink round trip, letting someone else watch, photographing it.
    While IDLE and armed, /dpl and FIRE <code> now fire a bare pulse: pins only,
    no state change, and ARM is left standing. So one /arm buys a 30 second
    window and as many shots as fit in it.
    This is not the unrestricted mode coming back. That had no gate at all. H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
2026-08-07 fix: four string literals in main.c were split by a stray newline
    The ground-test deploy path added in b0ad361 was written through a shell
    heredoc, which expanded the \r\n escapes into real newlines inside the C
    string literals:
    reply("MSG WARN Deploy pulse already active
    "); return; }
    Four literals across the /dpl and FIRE handlers, 17 compile errors. HEAD
    does not build.
    Restored the clean file and re-applied the change through a script that
    constructs the escape from character codes, so no shell layer can eat it.
    Verified: no line has an odd number of quotes, braces 241/241, parens 888/888.
    [main.c]
2026-08-07 chore: drop build-system leftovers, and give the ground project its own name
    Both .ioc files declared ProjectName=rocket sensor, and firmware-ground's
    .cproject pointed five build paths at ${workspace_loc:/rocket sensor} -
    including buildPath. With both projects in one workspace, the ground build
    resolves its output against the rocket project's directory. Its .project
    already said "rocket ground"; the rest now agrees.
    Application/User/ in firmware-rocket and firmware-ground is a leftover from
    the 2026-06-26 UnderRoot migration. Neither .project nor .cproject references
    it, and the build output only ever contained Debug/Core/Src/*.o - the copies
    differ from Core/ by a copyright year and noth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
    [lora.h, rocket ground.ioc]
2026-08-07 feat(tools): analysis pipeline for telemetry, imagery, and simulation
    Built to work out what happened on the 2026-08-01 flight, and kept because
    the next flight will need the same thing.
    Telemetry: parse_raw_lora turns a ground-station log into CSV plus an event
    file, keeping the UTC prefix when the log has one - that prefix is the only
    thing that puts two boards on one clock, since each board zeroes its own
    timer on its own liftoff detection and those differed by 0.49 s.
    flight_report draws a dual-board dashboard and handles an in-flight reboot
    by back-solving the original reference pressure. compare_boards and
    fit_ballistic cover cross-checks and velocity reconstruction when GPS is
    unusab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
    [build_viewer.py, compare_boards.py, enhance_frames.py, fit_ballistic.py, flight_report.py, fragment_track.py, grab_yt_frames.py, parse_raw_lora.py]
2026-08-07 docs: what happened on flight 161, and an index that says what is still true
    The repo had three documents describing the same failure with contradicting
    conclusions and no way to tell which was current. doc/README.md is now the
    router: it sorts by what you are trying to do, and marks every file green,
    yellow, or red. getting_started.md is the missing piece before that - it
    assumes no rocketry background and explains what the board is for, how the
    deploy criteria work, and what the vocabulary means.
    where_is_everything.md exists because the files are in three places, only
    two of which are repositories.
    On the flight itself: the avionics fired the parachute 1.5 s after apogee,
    which is correc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
2026-08-07 data: raw telemetry from the 2026-08-01 flight
    4 MB, and the only thing in this project that cannot be regenerated. It has
    been sitting on one laptop in D:\Downloads with no backup; every analysis in
    doc/ depends on it and none of them could be re-run or checked without it.
    The _utc pair is the important part. Each board zeroes its clock on its own
    liftoff detection and those fired 0.49 s apart, so the T fields cannot be
    compared directly - the ground station's UTC prefix is the only common
    timebase. Aligned that way the two boards sit a steady 30 ms apart before
    the event, which is also the check that the alignment is right. The finding
    that there were two opening shocks, each caught by on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
2026-08-07 docs: correct the protocol.h claim - the contract is verified, not decorative
    Yesterday's doc pass asserted that shared/protocol.h had drifted from the
    wire format, was missing SQ/VF/VA/GPS, and that nothing enforced agreement
    between the two ends. All three are wrong.
    The ground station repo carries tests/test_crossrepo_protocol.py, which
    reads firmware-rocket/Core/Src/main.c directly, extracts both snprintf
    format strings, and compares protocol.h's macros against them verbatim -
    along with the command tokens, the state machine ordering, that every
    deploy path goes through deploy_fire_on() so PA0 and PA1 fire together,
    and that automatic deploy messages avoid the word the downlink ack matc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
2026-08-07 docs: complete file map, placement rules, and the rocket model itself
    "Where is everything" answered the location question but not the file
    question - it named three directories and stopped. A newcomer opening
    firmware-rocket still met seventeen .c files with no guide, and had no way
    to know where a new one belonged.
    The map now lists every hand-written source with its size and job, for both
    repositories, and skips what CubeMX regenerates so nobody edits those by
    mistake. Alongside it, a table for the other direction: I wrote a new
    driver / analysis script / document / flight log - where does it go.
    Three rules came out of what this cleanup actually found. Run the cross-repo
    test after tou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
    [gen_sim_matrix_309.py]
2026-08-07 docs: drop machine-specific paths, point at the upstream ground station
    Written for someone who will never touch the machine this was developed on.
    Local paths are gone - the answer to "where is everything" is now two clone
    commands, since the flight logs and the rocket model both went into the
    repository. Nothing has to be requested from anyone.
    The ground station link pointed at jjjay0826/rocket_system_ground_side,
    which is a fork. Upstream is jx06T/rocket_system_ground_side, created a
    year earlier; both currently sit on the same commit, but the fork is not
    where development belongs. All links now go upstream, with a note naming
    the fork so nobody mistakes one for the other.
    Also removed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
2026-08-07 fix: the attitude filter treated any acceleration as gravity
    mahony_update() normalised whatever the accelerometer returned and used it
    as the gravity reference, with no magnitude gate. That is only valid near
    1 g. Two phases of this flight are nowhere near it, and both went wrong.
    During coast the specific force is 0.06 g - essentially drag and noise, not
    gravity. The filter tracked that vector anyway. At apogee, where the true
    vertical velocity is zero, ch1's estimate read -2.42 m/s and ch2's read
    +11.65: the filter believed the rocket was still climbing at 11.65 m/s. The
    direction of a 0.06 g drag vector depends on how the board sits, so the two
    boards tilted differently and their veloci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
    [main.c]
2026-08-07 docs: the primary deploy path failed on one of two boards
    Every document said the parachute fired 1.5 s after apogee and called the
    deploy logic correct. That is true of ch1 and only ch1. ch2's cond_B never
    became true in time and it deployed on the 18 s backup timer - the firmware
    said so in plain text at the time, "Parachute deployed (backup timer T>18s
    pk=833.9m now=783.8m)", and its cond_B flag did not go high until T+21.01,
    three seconds after the chute was already out. The two boards deployed two
    seconds apart by two different mechanisms.
    Missing it came from reading cond_A's timestamp as the deploy time. It is
    not; it is one of two conditions that both have to hold.
    This reframes th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
2026-08-07 fix: same missing magnitude gate in the drop-test attitude filter
    sandbox/parachute carries its own copy of the Mahony filter and had the same
    defect as the flight firmware: it normalised any acceleration vector and used
    it as the gravity reference.
    It matters more here, not less. This firmware exists to measure terminal
    velocity accurately, and the parachute opening shock - the one event a drop
    test is guaranteed to produce - is exactly what corrupts the attitude and
    therefore the vertical acceleration the estimator integrates.
    Two copies needed it. mahony_isr() in imu_fast.c is the 500 Hz version that
    runs during the drop; its structure was already right, with the correction
    inside a con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
    [imu_fast.c, imu_fast.h, main.c]
2026-08-31 feat: send the peak, not just whichever sample the packet happened to land on
    The IMU block runs at 100 Hz and the packet goes out at 2 Hz. An opening
    shock is 50-150 ms wide, so a 2 Hz snapshot misses it by construction, and
    on 2026-08-01 it did: the two opening shocks were each caught by one board
    and missed by the other, which was luck rather than design. The 6.14 g and
    1.53 kN that came out of it are lower bounds and always will be. The
    1166 deg/s spin at main-canopy inflation - the single piece of evidence the
    whole failure chain rests on - was reconstructed afterwards from the packets;
    nobody on the ground saw it while it was happening.
    Two hold registers now carry the maximum across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
    [main.c]
2026-10-07 docs: one list of what is still broken, and correct the "1.5 s after apogee" figure
    There was no single place that said what is unfixed right now. The open
    items were spread across four documents, and the most complete of them,
    open_defects_20260801.md, opens by saying it is a pre-launch snapshot that
    should not be read as current state. Ten of the known problems were not
    written down anywhere in the repo at all - among them that the deploy
    pulse fires once and is never confirmed, and that tools/fw_logic.py still
    runs the cond_B that the firmware dropped on 2026-08-07.
    doc/known_issues.md is now that list: 27 open items (7 must-fix before the
    next flight, 12 should-fix, 5 minor, 3 open ques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
2026-10-09 data: collect the rocket files that only existed on one laptop, with provenance
    Hardware designs, older rocket models, the simulation runs behind a flight
    safety parameter, and five sets of raw test data were never in the repo.
    They sat in a Downloads folder and a ground-station data/ directory on one
    machine. 37 files are now in, sorted by what they are:
    hardware/avionics_v1_2025-05/ first in-house board: schematic, PCB, 3D
    hardware/rocket_v7_2026-06/ schematic and netlist - the netlist is what
    LORA_USE_AUX was enabled from on 2026-07-20
    sim/models/archive/ 8 superseded .ork versions, 2025-11 onward
    sim/runs/20260720_deploy_tb/ the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
    [5k_0.csv, 5k_0_h.csv, 5k_0_r.csv, 5k_m10.csv, 5k_m10_h.csv, 5k_p10.csv, 5k_p10_h.csv, IMU_002.CSV]
2026-10-09 fix: a Windows clone rewrote the data files, PDFs included
    Verifying the previous commit from a clean clone, every SHA256SUMS failed.
    The files in the repo were fine; the checkout was not. Git for Windows
    defaults to core.autocrlf=true, and on checkout it turned LF into CRLF in
    anything it judged to be text. It judged the schematic and PCB PDFs and
    the STEP model to be text, so a Windows teammate's copy of those was
    silently altered, and so were the CSVs, the .eng motor curves and the
    checksum lists themselves. The .eng files have been affected since the
    first monorepo commit - this was never visible because nothing compared
    a checked-out file against its stored bytes until now.
    .gitattribu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
2026-10-09 docs: "the airframe would be torn apart" had no strength data behind it
    Three documents said a fully opened main at 39-41 m/s would load the
    recovery 8.8 kN and "tear the airframe apart", and that the structure
    "could not possibly survive" 5.5 kN. Nobody ever ran a strength analysis
    or a pull-to-failure test; the only strength figure in the docs, 8-20 kN
    for the canopy lines, was a typical value, not the rating of our lines.
    And 8.8 kN itself is an upper bound: it assumes the canopy opens
    instantly while the rocket does not slow down at all.
    tools/opening_load.py now integrates the opening: main-canopy drag area
    grows to full over tf seconds while the rocket decelerates, and the peak
    line t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
    [opening_load.py]
2026-10-11 docs: two more known issues - full-rate data has one path home, and the link is open
    #31: The board samples the IMU at 100 Hz and the barometer at 50 Hz, but
    only the SD card ever held that; LoRa carries a 2 Hz snapshot. That was a
    bandwidth decision, not an oversight: a 50 Hz text packet would be about
    9,000 B/s against roughly 800 B/s of air rate at 9.6 kbps, and USART1 to
    the E22 runs at 9600 baud. On 2026-08-01 the card sank with the rocket,
    and with it the onset of the spin and the true peaks of both shocks. The
    fix recorded is event replay: hold a few seconds of full-rate data in RAM,
    freeze the window around apogee and deployment, and trickle it down during
    the parachute descent, when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
2026-10-15 docs: re-derive the 8/1 timeline from the raw logs, and stop claiming what it can't show
    tools/verify_timeline_0801.py recomputes every telemetry row of the
    parachute_failure timeline straight from doc/flightdata/20260801 and prints
    the documented value next to the recomputed one.
    What it turned up:
    - "ch1 judged liftoff 0.49 s after ch2" was wrong. t=0 is each board's first
    ST:1 packet, and ch1 lost two packets (SQ14170/14171) at liftoff. The 0.49 s
    is packet loss plus 2 Hz quantisation, not a detection delay. The UTC-based
    conversion was always right, so the numbers on the timeline don't move.
    - T+0 is not liftoff; it trails the liftoff decision by 0-0.5 s.
    - Apex is ~14.35 by fit o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
2026-10-15 docs: measure the video-to-telemetry alignment instead of guessing it (closes known_issues #32)
    Measured on the livestream archive (youtube.com/watch?v=ogR7rgce_ps):
    - the rocket's nose first moves at stream time 21293.13 s (tracked per frame)
    - + crossing 2.5 g (0.03-0.07 s) + the 20-sample liftoff check (0.19-0.20 s)
    + waiting for ch2's first ST:1 packet (0.07-0.15 s, from its KF velocity
    of 3.78 m/s) puts telemetry T+0 at stream time 21293.48 +/- 0.07 s
    - the broadcast clock ticks 19->20 at 21292.93 and 38->39 at 21311.92, 18.99 s
    apart, so no frames were dropped between liftoff and the main opening
    The canopy pulls out at T+18.15-18.31, is at its widest at T+18.35-18.56
    and is a s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
2026-10-15 tools: build_viewer defaults the time offset to the measured -0.48 s
    The viewer's offset used to start at 0, which assumed the clip's first frame
    was liftoff and that liftoff was telemetry T+0. Neither holds: telemetry T+0
    is at stream time 21293.48 (measured 2026-10-15), and the documented clip
    starts at 5:54:53 = 21293.00. The default is now -0.48 and can be changed
    with --offset for clips that start elsewhere.
    Also fixes the README example, which passed --out-dir to a script whose
    argument is --out.
2026-10-15 docs: at ch1's 6.14 g sample the main canopy is a thin streak, not a bundle
    Going back over the frames: at stream time 21311.47-21311.54 (T+17.99-18.06),
    which brackets ch1's 6.14 g sample at T+18.03, the main canopy is an
    unopened thin pink-orange streak (same colour as the canopy that opens
    later). It only bunches up and starts to inflate at 21311.64-21311.79
    (T+18.16-18.31). The old wording called it "still a bundle" at 18.03.
    The streak fits a line-stretch load better than "a bundle being pulled out".
    verify_timeline_0801.py gains the streak phase as its own row.
