jjjay0826/rocket-system/(notices)

Notices in the files:
sandbox/baro/Core/Src/i2c.c:
Copyright (c) 2026 STMicroelectronics.
All rights reserved.
This software is licensed under terms that can be found in the LICENSE file
firmware-rocket/Core/Inc/main.h:
Copyright (c) 2025 STMicroelectronics.
